46564645/Surgery_exoskeleton/Main_ project/Hardware_information_list/hardware_interface_registry.md

# 硬件接口编码表

> 状态：型号资料接口登记 + 台架接线设计；2026-10-01已在用户报告 GIM 上电后观察到肩侧 CAN 原始报文，尚未完成协议解码或动力电压的独立实测。
>
> 本文件是当前项目的权威接口登记。历史目录中的同名文件仅作为旧副本，不再被项目文档引用。
>
> 硬件范围：严格来自同目录 `hardware_components_reference.md`。
>
> 规则：厂家资料确认与项目设计分配分开记录；第10节列出已选引脚和逐线关系，不代表实物一致性、保护器件或运行参数均已验证。

## 1. 编码与证据规则

| 对象 | 格式 | 示例 | 含义 |
|---|---|---|---|
| 设备 | `类别-序号` | `ACT-01` | 沿用 Hardware List 的设备编号 |
| 物理接口组 | `设备.IF序号` | `ACT-01.IF01` | 连接器、焊盘或固定线缆接口 |
| 接口信号 | `接口组.S序号` | `ACT-01.IF01.S01` | 接口内的一条厂家定义信号 |
| 板上操作件 | `设备.CTL序号` | `ESC-01.CTL01` | 按键、选择开关等非线缆接口 |
| 软件资源槽 | `设备.LR序号` | `MCU-01.LR01` | MCU逻辑需求；已选引脚见第10节 |
| 电源域 | `PD-名称` | `PD-24V-MOTOR` | 具有共同电气性质的电源范围 |
| 逻辑网络 | `NET-名称` | `NET-CAN-ELBOW` | 后续连接映射使用的逻辑网络身份 |

编码只表达稳定身份。厂家端子名称可以记录，但“某信号接到另一设备的哪一针”在第10节接线映射表中单独记录。

### 1.1 状态

| 状态 | 含义 |
|---|---|
| `CONFIRMED` | 对应型号官方资料明确给出，且型号身份已确认 |
| `REFERENCE_ONLY` | 资料来自参考板、芯片或商品页，尚不能证明到货实物完全一致 |
| `PLANNED` | 当前架构需要，但尚未分配物理资源 |
| `DESIGN_SELECTED` | 项目已选择连接关系或物理资源，尚未实物验证；不是厂家证据等级 |
| `TBD` | 缺少型号、版本、实物标识或对应资料，不能继续细化 |
| `INACTIVE` | 设备存在，但当前编码器控制架构不使用 |

### 1.2 证据等级

| 等级 | 证据 | 可确认范围 |
|---|---|---|
| `A` | 对应型号的厂家官方手册、数据手册或官方原理图 | 可确认该型号的接口名称、信号职责和厂家限制 |
| `B` | 对应芯片数据手册或官方参考板资料 | 只能确认芯片或参考板，不能自动等同于当前模块 |
| `C` | 用户提供的商品页、订单截图或商家资料 | 只记录直接可见的信息，必须核对实物 |
| `D` | 项目规划或待验证假设 | 不能作为接线依据 |

## 2. 型号与资料绑定

| 设备 | 已确认型号 | 主资料 | 证据 | 资料边界 |
|---|---|---|---|---|
| `MCU-01` | NUCLEO-F446RE；MB1136 rev C；用户报告 C04；STM32F446RET6 | ST `UM1724 Rev 17`、`MB1136-DEFAULT-C04` 原理图 | A+用户报告 | 正面照片可见 rev C；C04 来自用户文字，背面完整标识尚未拍照核对；板上焊桥/跳线现状仍需实物核对 |
| `ACT-01` | GIM6010-8；GDS68；订单 Y-48、12–48 V 选项 | SteadyWin《GIM6010-8 使用手册 rev2.2》 | A+C | 扩展口是否存在取决于驱动板硬件版本 |
| `ESC-01` | RoboMaster C620 | DJI《C620 无刷电机调速器使用说明 V1.01》 | A | 接口以中文版第 23–25 页为准 |
| `MOTOR-01` | 裸 RoboMaster M3508 | DJI《M3508 直流无刷电机使用说明 v1.0 2025.10》 | A | 不使用 P19 减速器资料 |
| `FORCE-01` | 5 kg 直梁式四线全桥应变称重传感器 | 随购买套装提供的技术参数表、安装图和接线图 | C | 已确认所购规格与资料基准；尺寸、线色和桥阻仍需到货实测 |
| `ADC-01` | HX711-BF / HX711AD 模块；资料原理图版本 | 随购买套装原理图及 Avia《HX711 数据手册》 | B+C | 原理图确认 `RATE`接地、固定10 SPS；实物排针和PCB一致性待核对 |
| `CAN-01/02` | 商品页展示为 Waveshare SN65HVD230 CAN Board 样式 | Waveshare 参考板原理图；TI 数据手册 | B+C | 到货板是否同版尚未确认 |
| `PWR-01` | S-250-24；商品24V/10A，规格书24V/10.4A | 卖家规格书001读取记录、第7页派生图、商品截图 | C | 原PDF待补；供应商/到货批次、输入档位未核对 |
| `IMU-01/02` | WitMotion WT901C-TTL | WitMotion 官方产品页、协议和教程 | A | 当前停用；排针物理顺序仍需实物核对 |

## 3. 电源域

| 编码 | 名称 | 已知范围 | 状态与边界 |
|---|---|---|---|
| `PD-AC-MAINS` | 台架交流输入域 | `PWR-01` 交流输入、保护接地和防触碰边界 | `DESIGN_SELECTED`：规格书针号已记录；实物与输入档位待核对 |
| `PD-24V-MOTOR` | 24 V 动力域 | `PWR-01` 计划向 `ACT-01`、`ESC-01` 供电 | `DESIGN_SELECTED`：两驱动独立支路已选；保护、开关和载流验证待定 |
| `PD-LOGIC-3V3` | 3.3 V 逻辑域 | `CAN-01/02` 和可能的 MCU 扩展逻辑 | `DESIGN_SELECTED`：CN7-16供3.3V，容量待核验 |
| `PD-MCU-5V` | MCU 板 5 V 域 | NUCLEO 的 USB 5 V、E5V 或板载 5 V 路径 | `DESIGN_SELECTED`：CN1 USB供电，CN7-18向逻辑模块分线 |
| `PD-SENSOR-LOW-VOLTAGE` | 传感器低压域 | `ADC-01`、`FORCE-01`；IMU 库存保留 | `DESIGN_SELECTED`：2026-10-16用户改选方案B，HX711由CN7-16的3.3V供电、数字线直连，模块整板3.3V未验证（原为CN7-18 5V加电平转换）；称重桥由HX711激励，IMU停用 |

## 4. 设备接口详细编码

### 4.1 MCU-01：NUCLEO-F446RE

#### 4.1.1 板级接口

| 接口编码 | 官方连接器 | 作用 | 状态 | 官方依据 |
|---|---|---|---|---|
| `MCU-01.IF01` | `CN1` USB Mini-B | ST-LINK 调试、下载、Mass Storage、VCP，并可供电 | `CONFIRMED` | UM1724 第 7.4、7.5.1 节 |
| `MCU-01.IF02` | `CN2` ST-LINK/NUCLEO 跳线 | 选择 ST-LINK 与板载目标 MCU 的连接关系 | `CONFIRMED` | UM1724 第 7.4 节、表 4 |
| `MCU-01.IF03` | `CN4` SWD | 板载 ST-LINK 调试外部目标板 | `CONFIRMED` | UM1724 第 7.4.5 节、表 5 |
| `MCU-01.IF04` | `CN5/CN6/CN8/CN9` | Arduino Uno V3 扩展接口组 | `CONFIRMED` | UM1724 第 7.13 节、表 19 |
| `MCU-01.IF05` | `CN7/CN10` | ST Morpho 扩展接口组 | `CONFIRMED` | UM1724 第 7.14 节、表 29 |
| `MCU-01.IF06` | 板载 VCP 内部路径 | 默认连接 `USART2 PA2/PA3`，受焊桥配置影响 | `CONFIRMED` | UM1724 第 7.10、7.11 节 |
| `MCU-01.IF07` | `B1` USER | 用户输入，连接 `PC13` | `CONFIRMED` | UM1724 第 7.7 节 |
| `MCU-01.IF08` | `B2` RESET | 目标 MCU 复位 | `CONFIRMED` | UM1724 第 7.7 节 |
| `MCU-01.IF09` | `LD2` USER LED | 用户输出，连接 D13 / `PA5` | `CONFIRMED` | UM1724 第 7.6 节 |

`CN4` 用于板载 ST-LINK 调试另一块目标板。UM1724 要求此时移除 CN2 两只跳线；若使用 CN4 第5针 NRST 复位外部目标，还必须断开 SB12，隔离板载 MCU 的复位路径。当前不把 CN4 与板载目标调试路径同时使用。CN2 仅控制 SWDIO/SWCLK 两条路径；板载 PB3 的 SWO 另经 SB15 接到 ST-LINK/CN4 的 SWO 网络，不能由 CN2 跳线状态推断其连接。

2026-10-02用户新正面照片已实际查看（Library `libfile_6ef3ceb5dd8c8191b7ad470143ac49a4`，本机证据 `D:/codex_tasks/2026-10-01/task/s3-axis/cn2-photo-review/`）：CN2两只跳帽外观均可见；CN4六针为裸露排针，未见套接母头或外接线，CN12黑色跳帽不能混作CN4接线。此为照片外观确认，不证明接触导通；不据此假设CN4争用或要求拆线。当时的历史成功与该窗口失败使用相同CLI2.23/HOTPLUG/4000kHz、固定ST-LINK及FW V2J28M18；该窗口目标芯片身份无法读取。后续同日探针升级至V2J48M35后已读到目标身份，13:27 HSI烧录及独立读回通过；不将先前失败描述为当前仍阻塞，历史根因仍未证实。

默认 USART2 VCP 路径按 UM1724 表10要求 SB13/SB14 ON、SB61/SB62/SB63 OFF；这是资料配置条件，当前实物焊桥状态仍未逐项核查。

2026-10-03当前Library实物时钟照片核对：背面`libfile_7d63857c82448191a0d42dbeb6f811d7`与此前背面图字节相同，可见SB16/SB50/SB54装0Ω、SB55空；新正面`libfile_0cab2b9c712c8191917206e69e46874b`中U5左侧C29下四行丝印对应R34/R36/R35/R37，上两行0Ω在位，下两行R35/R37无器件，X3晶体位空，ST-LINK X1在位标8.000。已按Hardware List、MB1136-DEFAULT-C04原理图第3页与UM1724 Rev17第7.9.1节交叉核对，外观符合经PH0输入ST-LINK MCO的装配条件；这不是导通/实际8MHz测量，也未拍到精确C04子版本背贴。没有修改焊桥/接线，不能由照片判断当前24V或USB状态。原图hash与独立证据在`D:/codex_tasks/2026-10-01/task/s2-stream-clock-ab/photo-review/result.json`；该01:19离线准备之后，01:32已在用户24V关闭/USB-only窗口单次刷入同源HSE stream候选并独立读回匹配；01:33 RCC实读HSERDY/HSEBYP/PLLSRC_HSE=1、M8/N336/P4及默认输出0通过。活动源码仍HSI，板上为HSE候选；未测实际8MHz、未启动连续采样。证据在同一工作目录usb-only-20261003T013012Z/result.json。

#### 4.1.2 CN4 信号

| 编码 | 针位 | 信号 | 方向（相对 ST-LINK） |
|---|---:|---|---|
| `MCU-01.IF03.S01` | 1 | `VDD_TARGET` | 采样输入 |
| `MCU-01.IF03.S02` | 2 | `SWCLK` | 输出 |
| `MCU-01.IF03.S03` | 3 | `GND` | 参考地 |
| `MCU-01.IF03.S04` | 4 | `SWDIO` | 双向 |
| `MCU-01.IF03.S05` | 5 | `NRST` | 输出 |
| `MCU-01.IF03.S06` | 6 | `SWO` | 手册表5标为 Reserved（保留）；本项目未用；与板载 PB3 的连接受 SB15 影响，不据此断言电气悬空 |

#### 4.1.3 可用供电入口和电源脚

| 编码 | 位置 | 功能与官方范围 | 状态 |
|---|---|---|---|
| `MCU-01.IF01.S01` | `CN1` | USB 5 V 路径，板及扩展负载受 UM1724 USB 电流限制约束 | `CONFIRMED` |
| `MCU-01.IF04.S01` | `CN6 pin 8` | `VIN`，外部 7–12 V 输入 | `CONFIRMED` |
| `MCU-01.IF05.S01` | `CN7 pin 24` | `VIN` | `CONFIRMED` |
| `MCU-01.IF05.S02` | `CN7 pin 6` | `E5V`，外部 4.75–5.25 V 输入 | `CONFIRMED` |
| `MCU-01.IF04.S02` | `CN6 pin 4` | `+3V3` | `CONFIRMED` |
| `MCU-01.IF04.S03` | `CN6 pin 5` | `+5V` | `CONFIRMED` |
| `MCU-01.IF04.S04` | `CN6 pin 6/7` | `GND` | `CONFIRMED` |

本项目选择CN1 USB供电；不并联外部VIN/E5V/3.3V入口。按UM1724第21–23页核对JP1、JP5、JP6及USB供电总预算，见第10节。

#### 4.1.4 资源槽与设计分配

| 编码 | 用途 | 所需能力 | 状态 | 分配或待定内容 |
|---|---|---|---|---|
| `MCU-01.LR01` | `SHOULDER_SIDE` | 1 路 CAN TX/RX | `DESIGN_SELECTED` | CAN1 PB9/TX、PB8/RX、AF9；500kbps准备值；bank0/FIFO0，RX0/SCE IRQ 5/0；接GDS前核实速率 |
| `MCU-01.LR02` | `ELBOW` | 1 路 CAN TX/RX | `DESIGN_SELECTED` | CAN2 PB13/TX、PB12/RX、AF9；1Mbps；bank14/FIFO1，RX1/SCE IRQ 5/0；实物总线待测 |
| `MCU-01.LR03` | 命令与遥测 | ST-LINK VCP / USART2 | `DESIGN_SELECTED` | PA2/TX、PA3/RX、AF7，115200 8N1无流控；DMA1 Stream5/Channel4 RX循环、Stream6/Channel4 TX普通；S1已生成并构建，实物通信验证另见开发日志 |
| `MCU-01.LR04` | HX711 | 数字输出 `PD_SCK`、数字输入 `DOUT` | `DESIGN_SELECTED` | PC3/SCK输出、PC2/DOUT输入无上下拉；3.3V直连（方案B），10SPS新样本 |
| `MCU-01.LR05` | 未来 `assist_enable_permission` | 安全定义的数字输入 | `PLANNED` | 硬件、GPIO、电平、去抖 |

S1固件中断配置（2026-09-25）：NVIC GROUP4；USART2、DMA1 Stream5/6抢占优先级5、子优先级0；SysTick抢占优先级0。用户按键EXTI15_10的最终抢占优先级为10：官方BSP初始化会写15，因此由自有`BoardRuntime_FinalizeInterrupts()`在`BSP_PB_Init()`之后重新设置并读回检查。检查失败不启动命令接收。此段记录软件配置，不证明实物焊桥、USB链路或电机安全。

S2第一轮软件配置（2026-09-25）：APB1=42MHz，BS1=11、BS2=2、SJW=1，CAN1/2分频6/3；正常模式，允许硬件ACK，无应用发送接口。共享过滤器分界14，仅标准数据帧，不限制11位ID。启用GPIOB及CAN1/CAN2时钟，CAN2保留CAN1时钟依赖；CAN1_RX0、CAN2_RX1和两路SCE均5/0；不自动恢复bus-off。每路64帧队列、ISR最多3帧、主循环每1ms每路最多16帧。USB实测两路started=1、seen=0，仅证明控制器启动与查询，不证明线路收帧或电机在线。

### 4.2 ACT-01：GIM6010-8 + GDS68

`ACT-01` 绑定右臂 `SHOULDER_SIDE`。接口来自 GDS68，不表示全部启用。

| 编码 | 手册序号 | 连接器/形式 | 功能 | 状态 | 依据 |
|---|---:|---|---|---|---|
| `ACT-01.IF01` | 1 | 板端 `XT30PB(2+2)-M`；线端 `XT30(2+2)-F` | 电源与 CAN/复用通信 | `CONFIRMED` | rev2.2 第 2.4.1 节，第 10 页 |
| `ACT-01.IF02` | 2 | USB Type-C | 调试与上位机通信，不给驱动器供电 | `CONFIRMED` | 第 2.4.2、3.1 节 |
| `ACT-01.IF03` | 3 | 20-pin 扩展插槽 | SPI/USART/I2C/PWM/ADC/GPIO | `TBD` | 第 2.4.3 节；硬件 v3.9+ 无此口 |
| `ACT-01.IF04` | 4 | 2.00 mm 焊盘 | SWD 调试/下载 | `CONFIRMED` | 第 2.4.4 节，第 11–12 页 |
| `ACT-01.IF05` | 5 | 2.00 mm 焊盘 | 第二编码器 USART/I2C | `CONFIRMED` | 第 2.4.5 节，第 12 页 |
| `ACT-01.IF06` | 6 | 焊盘 | 电机 10 kΩ NTC | `CONFIRMED` | 第 2.4.6 节，第 12 页 |
| `ACT-01.IF07` | 7a | 2.00 mm 焊盘 | 抱闸或制动/泄放电阻 | `CONFIRMED` | 第 2.4.7 节，第 13 页 |
| `ACT-01.IF08` | 7b | 2.00 mm 焊盘 | 最小/最大限位及 12 V 辅助电源 | `CONFIRMED` | 第 2.4.8 节，第 13–14 页 |
| `ACT-01.IF09` | U/V/W | 三相绕组焊接孔 | GIM6010-8 三相绕组 | `CONFIRMED` | 第 2.2 节，第 9 页 |

#### 4.2.1 电源与 CAN

| 编码 | 信号 | 功能 | 项目状态 |
|---|---|---|---|
| `ACT-01.IF01.S01` | `VBUS` | 直流母线正端 | `PLANNED` |
| `ACT-01.IF01.S02` | `GND` | 直流母线负端/参考地 | `PLANNED` |
| `ACT-01.IF01.S03` | `CANH` | CAN 高线；其他模式可复用 | `PLANNED`：只计划 CAN |
| `ACT-01.IF01.S04` | `CANL` | CAN 低线；其他模式可复用 | `PLANNED`：只计划 CAN |

GDS68 手册明确说明驱动板没有电源反接保护。本表把它记录为接线验证约束，不据此新增未选型的保护器件。

#### 4.2.2 调试与辅助信号

| 编码 | 信号 | 功能 | 状态 |
|---|---|---|---|
| `ACT-01.IF04.S01` | `SWDIO` | SWD 数据 | `CONFIRMED` |
| `ACT-01.IF04.S02` | `GND` | 调试参考地 | `CONFIRMED` |
| `ACT-01.IF04.S03` | `SWDCLK` | SWD 时钟 | `CONFIRMED` |
| `ACT-01.IF04.S04` | `3.3V` | 调试电平参考 | `CONFIRMED` |
| `ACT-01.IF05.S01` | `GND` | 第二编码器参考地 | `CONFIRMED` |
| `ACT-01.IF05.S02` | `3.3V` | 第二编码器供电 | `CONFIRMED` |
| `ACT-01.IF05.S03` | `TX/SCL` | USART TX 或 I2C SCL | `CONFIRMED` |
| `ACT-01.IF05.S04` | `RX/SDA` | USART RX 或 I2C SDA | `CONFIRMED` |
| `ACT-01.IF06.S01` | `MOT_TEMP` | 10 kΩ NTC 信号 | `CONFIRMED` |
| `ACT-01.IF06.S02` | `GND` | 温度参考地；手册称两线无极性 | `CONFIRMED` |
| `ACT-01.IF07.S01` | `EMG` | 抱闸电流输出或制动电阻端 | `CONFIRMED`：未启用 |
| `ACT-01.IF07.S02` | `GND` | 抱闸/制动回路参考端 | `CONFIRMED`：未启用 |
| `ACT-01.IF08.S01` | `GND` | 限位参考地 | `CONFIRMED`：未启用 |
| `ACT-01.IF08.S02` | `12V` | 限位开关辅助供电 | `CONFIRMED`：未启用 |
| `ACT-01.IF08.S03` | `LW1` | 最小位置限位输入 | `CONFIRMED`：未启用 |
| `ACT-01.IF08.S04` | `LW2` | 最大位置限位输入 | `CONFIRMED`：未启用 |

限位口允许两线开关或三线 NPN 开关，但项目未选定开关。20-pin 扩展口的板端为 `X0812FVS-20CS-9TV01`，扩展板端为 `X0812WVS-20AS-9TV01`；ACT-01实读硬件3.11.1，手册标注v3.9+无此20-pin口；该未启用扩展口不建立项目连接，实物PCB外观未由本次界面读取验证。

#### 4.2.2a 肩侧目视姿态与编码器配对（2026-10-06）

- 用户确认采集期间未移动，并接受目视判断的当前角度，要求跳过进一步测角。未提供仪器测量值/误差范围，也未明确数值0°；记录为用户目视参考，不标为精确角度标定通过。
- 23:39:44 CST原生USB实读位置为2.8982579708099365转子rev，首末IDLE；原始来源为`D:/codex_tasks/2026-10-01/task/s3-shoulder-supervised/usb/captures/20261006T153943.847110Z/capture.json`。本仓证据引用：`firmware/Exoskeleton_F446/experiments/can_blackbox/captures/s3-precheck-20261006T153820368000Z/usb-read-reference.json`（本机忽略）。
- 未据此写入关节零位、方向、总传动比例或运动边界。后续若出现角度/重力补偿偏差，回查目视姿态基准、采集配对及映射参数；原始读数不是关节角度。用户范围调整和阶段状态见唯一开发日志2026-10-06条目。

2026-10-09 S4 连接补充（用户口述，未独立拆检）：GDS68 输出端与肩轴直接相连，用户确认没有额外皮带或齿轮传动。这只排除了外部二次传动的候选；反馈位置到关节角的总换算比及关节正向仍须与独立角度和同期新鲜读数核对。舒适内侧位置的独立角度、同期转子读数及试验小区间两端余量目前未提供，不将 8:1 或方向写为已验收，也不据此启用 S4 输出。

#### 4.2.3 当前实物版本、通信配置与USB绑定（2026-10-02只读）

以下是肩侧静态供电、MotorWizard已连接后的实际界面和Windows在线设备读数；不是手册示例，未修改设备配置。唯一进度与操作经过见development_schedule.md当日日志。

| 项目 | 实际读取结果 | 证据/边界 |
|---|---|---|
| 硬件/固件版本 | 3.11.1 / 0.6.5 | 电机参数页头；不再使用手册3.8/0.5.13示例代表实物 |
| 通信接口/波特率 | CAN / 500000 bit/s | 通信参数页；与MCU CAN1名义500kbps一致，不证明物理链路无错 |
| 节点/协议 | ID 1 / SIMPLE | 实际配置支持既有0x029按节点1、命令0x009核对；载荷含义和真实反馈对应仍待确认 |
| 减速比/极对数 | 8.00 / 14 | 客户端存量配置，未独立标定；不改变S2原生转子单位或确认关节零位 |
| 显示运行状态 | 空闲、0 RPM、母线23.2 V | 连接主界面快照，不代替外部仪表测量或全部启动行为验收 |
| USB Interface 2 | USB\VID_1209&PID_0D32&MI_02 | 在线Code0；oem249.inf / libusb0 / libusb-win32 1.4.0.0 |
| USB Interface 0 | COM5 / usbser.inf / usbser | 仍为原Microsoft串口驱动，未改绑 |
| 120Ω/启动参数 | 2026-10-03 01:12 UTC只读：can.config.enable_r120=true（ep72/bool）、r120_gpio_num=5（ep71/uint16）；启动参数未验证 | HW3.11.1/FW0.6.5/node1/IDLE及板SN197332430435634匹配；仅软件配置，不证明电阻导通或CAN根因，不把逻辑GPIO编号5映射为未核实的物理脚位 |

实物版本3.11.1不属于手册“硬件≤3.7时USB/CAN互斥”条件，当前CAN配置下USB实际可连接；未发Disable_Can、保存或重启命令。协议字段仍须核对0.6.5适用资料，不把旧手册全部行为自动套用。现有HAL 0x10是STM32帧格式错误，USB驱动修复不证明CAN错误已消除。S2肩侧解析、必要真实反馈/离线恢复及双路验收尚未完成；本记录不作为运动或人体安全验收。

2026-10-02 14:56–14:58 UTC补充只读证据：同一静止时段，厂家参数浏览器显示`axis0.encoder.pos_estimate=2.9320929050445557`、`encoder.is_ready=1`、`encoder.error=0`；约30秒后的CAN查询仍为`0x029/DLC8/0000000000000000`，心跳`state=1/error=0/fault=0`，输出许可为0。并非同步采样，未据此确认动态角度/速度或关节映射。原始帧已零，不通过改STM32换算掩盖；USB与CAN来源差异待厂家FW0.6.5实现核实。rev2.2第35页注明`load_encoder_axis`仅BETA必要、量产无效；不能据上游ODrive版本建议修改该项或使能初始化。第45–46页RxSdo只读方案须先取得匹配0.6.5的端点表；公开0.5.13/0.5.14表不能代用，候选0.6.5地址实际返回HTML。证据索引：`D:/codex_tasks/2026-10-01/task/s2-final-acceptance/usb-can-source-diagnosis.json`。本轮未改接线/参数/驱动固件，S2仍未完成。

2026-10-02 15:33 UTC实机Native USB追加确认：HW3.11.1/FW0.6.5/node1/axis0 IDLE，36965字节原始endpoint0 schema SHA256为`cfd83580745d91c18d87c6832daa34677685e32e9d051e7f2b4bb562a90c9bc1`。只读float `axis0.encoder.pos_estimate`端点372、`vel_estimate`端点378；当次USB分别2.9287331104278564rev和0.005722047761082649rev/s，ready=true/error0。此前公开地址返回HTML的阻碍已由设备导出解决，未套用旧版端点。固件新增只读opcode0、固定节点/端点的250ms有界诊断，匹配025回应与周期029独立标记；16:09已随新HSI刷入并独立读回，16:11默认禁用/SDO idle通过，尚未发送CAN属性读取；USB CRC16=63447不能用于CAN属性帧。端点绑定与最小后续边界见[限定SDO诊断](../../firmware/Exoskeleton_F446/docs/s2_encoder_sdo_diagnostic.md)。S2真实CAN语义、变化和离线恢复仍待验收；参数、接线及驱动固件未改。

16:21 UTC限定CAN实测：372/378各一次read得到ID025/DLC8/正确端点，位置`00740100FC993740`=2.8687734603881836rev、速度`007A010000007ABB`=−0.003814697265625rev/s；紧邻USB位置2.868832588195801rev，相隔约96.541ms。周期029仍全零、心跳IDLE/error0/fault0；两路本窗口CAN错误/丢帧/溢出/bus-off均0，无新增。属性估计与周期009分别标记，不确认厂家内部controller来源，不以非同步微小速度值确认运动方向。读取机会已用，可信连续肩反馈及实物超时/恢复仍待验收；无写参数/使能/校准或运动。证据为s2-sdo-read/can-usb-20261002T162124633Z/analysis.json。

本机证据目录：D:/codex_tasks/2026-10-01/task/gds-tool-preparation/gds-interface2-correct-binding/；actual-binding.json、pnputil-install.log、motorwizard-after-binding.png、motor-parameters.png。本次只安装授权的Interface2驱动包及其对应证书；Logitech原驱动未变，未启动、校准或同步保存设备参数。

### 4.3 ESC-01：RoboMaster C620

`ESC-01` 与 `MOTOR-01` 共同绑定右臂 `ELBOW`。

2026-10-08 安装位置补充（用户口述，未通过照片独立核查）：C620 固定在支架上，不随肩侧关节转动。估算肩轴随动负载时不计入 C620 本体质量；随动线束仍须按实际布置另行判断。

| 编码 | 官方接口 | 功能 | 状态 | 依据 |
|---|---|---|---|---|
| `ESC-01.IF01` | 7-Pin 电机数据端口 | 与 M3508 数据交互 | `CONFIRMED` | C620 中文第 23、25 页 |
| `ESC-01.IF02` | 三相动力线接头 | 向 M3508 输出三相动力 | `CONFIRMED` | 第 23、25 页 |
| `ESC-01.IF03` | 兼容 XT30 的电源线 | 24 V 输入 | `CONFIRMED` | 第 24 页 |
| `ESC-01.IF04` | CAN 信号端口 | 1 Mbps CAN 控制与反馈 | `CONFIRMED` | 第 24–25 页 |
| `ESC-01.IF05` | PWM 信号端口 | PWM 控制或配置/升级 | `CONFIRMED` | 第 24–25、27 页 |
| `ESC-01.CTL01` | 终端电阻开关 | 接入/断开板载 120 Ω | `CONFIRMED` | 第 24 页 |
| `ESC-01.CTL02` | SET 按键 | 设置 ID、快速编号、电机校准 | `CONFIRMED` | 第 24、30–32 页 |

| 编码 | 标记/线色 | 方向（相对 C620） | 项目状态 |
|---|---|---|---|
| `ESC-01.IF03.S01` | 电源正，XT30 极性依连接器 | 输入 | `PLANNED`：核对实物 |
| `ESC-01.IF03.S02` | 电源负，XT30 极性依连接器 | 输入 | `PLANNED` |
| `ESC-01.IF04.S01` | A，黑色，`CAN_L` | 双向总线 | `PLANNED` |
| `ESC-01.IF04.S02` | B，红色，`CAN_H` | 双向总线 | `PLANNED` |
| `ESC-01.IF05.S01` | A，黑色，`GND` | 参考地 | `CONFIRMED`：不作运行控制 |
| `ESC-01.IF05.S02` | B，灰色，`TX` | 输出 | `CONFIRMED`：不作运行控制 |
| `ESC-01.IF05.S03` | C，白色，`PWM/RX` | 输入 | `CONFIRMED`：不作运行控制 |

C620 手册禁止同时接入 CAN 与 PWM，切换方式前必须断电。本项目固定选择 CAN 运行路径。7-Pin 内部针位未在当前官方手册展开，因此不猜测。

### 4.4 MOTOR-01：裸 M3508

| 编码 | 官方接口 | 功能 | 状态 | 依据 |
|---|---|---|---|---|
| `MOTOR-01.IF01` | 7-Pin 数据端口 | 用随附线连接 C620 | `CONFIRMED` | M3508 v1.0 第 2、6 页 |
| `MOTOR-01.IF02` | 三相输入接头 | 连接 C620，相同颜色对应且不可反插 | `CONFIRMED` | M3508 v1.0 第 2、6 页 |

不添加 P19 接口。手册没有公开 7-Pin 内部针位，也未在文字中定义三相 U/V/W，因此只把原厂线束视为完整接口。M3508 的动力必须来自 C620 三相输出，不能直接接 24 V 直流母线。

2026-10-11 用户口述：肘部电机输出轴与关节同轴直连，本轮软件以 1:1 为局部候选。随后在 24 V 关闭、机构承托下，用户轻轻手动转动前臂，报告电机输出端与肘关节同步、同方向转动，未见明显空转或打滑；这只支持本次低负载手动联动，不是传动比精度、带载无滑差、屈伸编码器正方向、力矩或可用活动角域的实测证明。

2026-10-11 R2 修复版动力微动方向观察：在独立承托的同一台架姿态下，固件通过 C620 发送 `elbowpulse <token> 2000 150`，主机约 100 ms 取消；操作者从侧面确认重复窗口的两次微动均使前臂**更弯曲**。本结论只将该装配姿态下的正向电流指令与屈肘微动关联，不推定重力支撑方向或全活动范围。重复第 2 次结束时固件锁存 `HEALTH/SAFETY_TRANSPORT` 故障，第 3 次未发送；用户确认断电承托、无异常。原始串口与故障 RAM 见固件 `build/bench-logs/s5-r2-repeat-20261011/`。

### 4.5 FORCE-01：5 kg 直梁式应变称重传感器

以下信息来自随购买套装提供的5 kg技术参数表、安装图和接线图，证据等级为商品配套资料。到货后仍需核对实物。

| 编码 | 商品资料线色 | 商品资料定义 | 方向 | 状态 |
|---|---|---|---|---|
| `FORCE-01.IF01.S01` | 红 | `E+` 激励正 | 输入 | `REFERENCE_ONLY` |
| `FORCE-01.IF01.S02` | 黑 | `E-` 激励负 | 输入 | `REFERENCE_ONLY` |
| `FORCE-01.IF01.S03` | 绿 | `A+` 信号正 | 输出 | `REFERENCE_ONLY` |
| `FORCE-01.IF01.S04` | 白 | `A-` 信号负 | 输出 | `REFERENCE_ONLY` |

资料给出额定载荷5 kg、灵敏度1.0 ± 0.1 mV/V、推荐激励3–12 V以及输入/输出电阻1000 ± 50 Ω。安装采用一端固定、另一端悬空的悬臂方式；连接ADC前仍需测量桥路并通过已知方向加载确定正负方向。

### 4.6 ADC-01：HX711 模块

随购买套装资料给出了HX711-BF模块原理图和接线图。原理图明确把`RATE`（15脚）接至`GND`，因此本项目按固定10 SPS的低速采集模块登记；具体排针顺序仍需到货后按板上丝印确认。

| 编码 | 逻辑接口组 | 芯片功能 | 模块状态 |
|---|---|---|---|
| `ADC-01.IF01` | 通道 A 称重桥输入 | `E+`、`E-`、`A+`、`A-` | `REFERENCE_ONLY`：按套装接线图，待实物丝印确认 |
| `ADC-01.IF02` | 通道 B 输入 | `B+`、`B-` | `INACTIVE`：当前不使用 |
| `ADC-01.IF03` | MCU 数字接口 | `DT/DOUT`、`SCK/PD_SCK`、`GND` | `REFERENCE_ONLY`：待实物排针确认 |
| `ADC-01.IF04` | 模块供电 | `VCC`、`GND` | `DESIGN_SELECTED`：CN7-16 +3.3V（2026-10-16方案B）；配套原理图模拟稳压目标约4.3V，3.3V下预计饱和、E+约3.0–3.2V，需上电实测 |
| `ADC-01.CFG01` | HX711 `RATE`硬件配置 | 15脚接`GND`，固定10 SPS | `REFERENCE_ONLY`：套装原理图已确认，实物PCB待核对 |

ADC-01只发布低速辅助力监测值，用于显示、记录、标定观察和后续研究。它不作为快速助力触发、关节主控制反馈、安全触发或高带宽力闭环输入。软件不得把重复读取旧样本描述为高于10 SPS的新测量。

| 参考编码 | HX711 针位 | 信号 | 官方功能 |
|---|---:|---|---|
| `ADC-01.IF01.S01` | 8 | `INA+` | 通道 A 正输入 |
| `ADC-01.IF01.S02` | 7 | `INA-` | 通道 A 负输入 |
| `ADC-01.IF02.S01` | 10 | `INB+` | 通道 B 正输入 |
| `ADC-01.IF02.S02` | 9 | `INB-` | 通道 B 负输入 |
| `ADC-01.IF03.S01` | 12 | `DOUT` | 数据输出；低电平表示就绪 |
| `ADC-01.IF03.S02` | 11 | `PD_SCK` | 时钟兼断电控制；高电平超过 60 µs 断电 |

依据为 Avia HX711 数据手册第 2、4–6、10 页。数据手册要求 DOUT 对应的 MCU 输入不接内部上拉/下拉；本地开源 STM32 示例 README 建议上拉，与芯片手册冲突，后续必须以芯片手册和实际模块电路为先。

### 4.7 CAN-01 / CAN-02：SN65HVD230 CAN Board 样式模块

两块模块结构相同。排针顺序来自 Waveshare 参考板原理图，实物未核对，全部为 `REFERENCE_ONLY`。

下表使用公共后缀压缩重复内容。例如 `.IF01.S01` 分别展开为 `CAN-01.IF01.S01` 和 `CAN-02.IF01.S01`，两者仍是独立且唯一的信号编码。

| 信号后缀 | 参考板针位 | 信号 | 方向（相对模块） |
|---|---:|---|---|
| `.IF01.S01` | P1-1 | `CAN_TX`，接收发器 D | 输入 |
| `.IF01.S02` | P1-2 | `CAN_RX`，来自收发器 R | 输出 |
| `.IF01.S03` | P1-3 | `GND` | 参考地 |
| `.IF01.S04` | P1-4 | `3.3V` | 电源输入 |
| `.IF02.S01` | can1-1 | `CANL` | 双向总线 |
| `.IF02.S02` | can1-2 | `CANH` | 双向总线 |

Waveshare 原理图确认：`Rs` 经 10 kΩ 接地，CANH/CANL 固定跨接 120 Ω；未显示终端使能开关、隔离器或 TVS。TI 数据手册第 5 页确认 SN65HVD230 芯片信号和 3.3 V 供电。接线前必须逐块核对芯片顶标、P1 丝印方向、CANH/CANL 丝印、3.3 V/GND 极性及断电端间电阻。

### 4.8 PWR-01：S-250-24

卖家规格书001第7页已给针号。原PDF临时文件在归档时失效，保留[第7页派生图](all_hardware_relevant_documents/S-250-24_power_supply/specification_page7_render.png)与[读取记录](all_hardware_relevant_documents/S-250-24_power_supply/specification_reading_record.md)，证据等级C，实物仍待核对。

| 接口/信号编码 | 针号或名称 | 职责 | 状态 |
|---|---|---|---|
| `PWR-01.IF01.S01` | 9 / AC/L | 交流火线 | `REFERENCE_ONLY` |
| `PWR-01.IF01.S02` | 8 / AC/N | 交流零线 | `REFERENCE_ONLY` |
| `PWR-01.IF01.S03` | 7 / GND保护接地 | PE；不是DC负极 | `REFERENCE_ONLY` |
| `PWR-01.IF02.S01` | 1/2/3 / +V | 同一路+24V输出 | `REFERENCE_ONLY` |
| `PWR-01.IF02.S02` | 4/5/6 / −V | 同一路动力0V | `REFERENCE_ONLY` |
| `PWR-01.IF03` | ADJ | 输出调节；规格書22.7–25.2V | `REFERENCE_ONLY` |

观察方向：风扇面朝上、端子朝向观察者，从左向右1–9，调压器不计入针号。三组正负端子共享电源总额定10.4A，不乘三；原商品标10A的差异保留。L接火线，N接零线，不采纳卖家“无需区分”说法。输入选择档位、接线端子扭矩和回生吸收能力未确认。

保护资料边界（既有S-250-24规格书读取记录、原PDF未归档）：过流12.5–14.5A恒功率、过功率300–350W及短路消除后自动恢复；ADJ为调压，未记录可调恒流限流能力。供应商/实物一致性和保护实测未验证，固定保护不代替支路保险；现有用户选择为暂不安装动力保险，动力线径尚未核实。

### 4.9 IMU-01 / IMU-02：WT901C-TTL

IMU 当前不进入控制架构，仅登记库存能力。

下表公共后缀分别展开到 `IMU-01` 与 `IMU-02`，例如 `.IF01.S02` 对应两个设备各自独立的 TX 信号。

| 信号后缀 | 官方信号 | 方向（相对 IMU） | 状态 |
|---|---|---|---|
| `.IF01.S01` | `VCC` | 电源输入 | `INACTIVE`：电压按实物版本复核 |
| `.IF01.S02` | `TX` | 串口输出 | `INACTIVE` |
| `.IF01.S03` | `RX` | 串口输入 | `INACTIVE` |
| `.IF01.S04` | `GND` | 参考地 | `INACTIVE` |

WitMotion 官方教程确认串口交叉连接，即传感器 TX 对主控 RX、传感器 RX 对主控 TX。当前没有本批产品排针实物证据，不登记物理针序；未来启用时须先读取当前波特率和输出配置。

## 5. 逻辑网络

| 编码 | 功能 | 端点角色 | 状态 | 尚未决定 |
|---|---|---|---|---|
| `NET-PWR-24V-MOTOR` | 24 V 动力母线 | `PWR-01.IF02`、`ACT-01.IF01`、`ESC-01.IF03` | `PLANNED` | 分支、保护、线径、连接器、同时输出能力 |
| `NET-CAN-SHOULDER-SIDE` | SHOULDER_SIDE CAN | `MCU-01.LR01`、`CAN-01`、`ACT-01.IF01` | `DESIGN_SELECTED` | MCU引脚见第10节；实物终端、线束、CAN配置待验证 |
| `NET-CAN-ELBOW` | ELBOW CAN | `MCU-01.LR02`、`CAN-02`、`ESC-01.IF04` | `DESIGN_SELECTED` | MCU引脚见第10节；实物终端、线束、C620 ID待验证 |
| `NET-M3508-DATA` | M3508 数据链 | `ESC-01.IF01`、`MOTOR-01.IF01`、原厂 7-Pin 线 | `CONFIRMED` | 不拆未公开针位 |
| `NET-M3508-PHASE` | M3508 三相链 | `ESC-01.IF02`、`MOTOR-01.IF02` | `CONFIRMED` | 实物线色和接头检查 |
| `NET-FORCE-BRIDGE` | 力传感器桥路 | `FORCE-01.IF01`、`ADC-01.IF01/04` | `PLANNED` | 实物端子、激励、桥阻和方向标定 |
| `NET-HX711-DIGITAL` | HX711 10 SPS低速数字采集 | `ADC-01.IF03`、`MCU-01.LR04` | `DESIGN_SELECTED` | GPIO见第10节；方案B 3.3V直连无转换板；实物排针、读取超时待落实 |
| `NET-DEBUG-VCP` | 调试与遥测 | PC、`MCU-01.IF01/06`、`MCU-01.LR03` | `PLANNED` | USART2 是否占用、波特率、格式 |

## 6. 无法由型号资料确认的项目

1. `MCU-01` 用户报告 C04，已选用 C04 原理图作为资料依据；背面完整版本贴纸和当前焊桥/跳线状态仍未照片核对。
2. `ACT-01` 已实读GDS68硬件3.11.1/固件0.6.5及CAN 500kbps/ID1/SIMPLE（第4.2.3节）；实际PCB接口外观、120Ω软件开关和肩侧反馈/错误根因仍未确认，不认定20-pin扩展口存在。
3. `FORCE-01`已确定购买5 kg规格，但缺少到货实物、厂家型号和铭牌，线色、桥阻及尺寸仍需实测。
4. `ADC-01`已有套装原理图并确认固定10 SPS，但缺少到货PCB正反面照片，不能把资料排针顺序直接视为实物事实。
5. `CAN-01/02` 未核对到货板，Waveshare 参考板针序不能视为实物事实。
6. `PWR-01` 已读取S-250-24规格书并保存第7页派生图；原PDF待补，实物铭牌、输入档位和端子一致性未核对。
7. `IMU-01/02` 当前停用且缺少本批排针照片，不登记物理针序。

## 7. 接线设计前的实物核对

| 对象 | 必须获取或测量 | 解锁工作 |
|---|---|---|
| `MCU-01` | C04 背标照片、当前焊桥/跳线 | 板级差异与实物接线核对 |
| `ACT-01` | GDS68 板版本、端子朝向、CAN 模式与配置 | SHOULDER_SIDE 线束 |
| `ESC-01` | XT30 极性、终端开关、ID、CAN/PWM 未同时接入 | ELBOW 线束 |
| `MOTOR-01` | 原厂 7-Pin 与三相线完好、同色对应 | C620-M3508 配套确认 |
| `FORCE-01` | 铭牌/订单型号、5 kg规格、尺寸、线色、桥阻和已知方向加载 | 接HX711并完成方向标定 |
| `ADC-01` | PCB正反面、丝印、芯片顶标，并核对`RATE`确实接地 | 两侧针位编码和10 SPS采样验证 |
| `CAN-01/02` | 正反面、芯片顶标、丝印、断电总线电阻 | CAN 接线与终端 |
| `PWR-01` | 铭牌、输入选择、端子排和丝印 | 交流与 24 V 支路 |
| `IMU-01/02` | 未来启用时核对排针、供电版本和配置 | IMU 资源分配 |

## 8. 尚未完成的设计与验证

- CAN1/CAN2及HX711引脚已分配；CAN ID、实际波特率配置、控制周期、控制限值、DMA/IRQ/滤波器仍由固件设计与设备读取落实。C620要求1Mbps不是另一条GDS68总线已配置的证明。
- 24V两支路拓扑已选；保险、急停/接触器、浪涌、回生处理、线束载流具体型号未选定；HX711按方案B 3.3V直连，不再需要电平转换板。图中占位不代表已安装器件。
- 不把旧款商品参数、参考板针序、规格书数值或开源程序提升为实物已验证结论。IMU保持停用。

## 9. 资料索引

AI 读取手册时，有对应型号和版本且正文可读的 Word 就优先读 Word；完整格式规则和图示核对要求见[图纸文字说明第0.1节](motor_can_diagrams_text.md#01-手册读取入口)。Word 页码可能因重排变化，以下章节/页码依据原 PDF。

| 编号 | 本地资料 | 用途 |
|---|---|---|
| `SRC-PROJECT-DIAGRAMS` | [电机与 CAN 模块图纸的详细文字描述](motor_can_diagrams_text.md) | 项目整理的逐线说明和 Word/PDF 读取入口；不替代厂家原件或本表的当前接线状态 |
| `SRC-MCU-01` | [Word](all_hardware_relevant_documents/um1724-stm32-nucleo64-boards-mb1136-stmicroelectronics.docx)；[原 PDF](all_hardware_relevant_documents/um1724-stm32-nucleo64-boards-mb1136-stmicroelectronics.pdf) | NUCLEO 接口、供电、VCP、按键和 LED |
| `SRC-MCU-C04` | [ST 官方 MB1136-DEFAULT-C04 原理图](https://www.st.com/resource/en/schematic_pack/mb1136-default-c04_schematic.pdf)；[项目所用接口的结构化摘录](nucleo_f446re_mb1136_c04_ai.json) | 5 页 C04 参考电路；JSON 为不完整摘录，不能代替整板网表或实物焊桥检查 |
| `SRC-ACT-01` | [Word](all_hardware_relevant_documents/ABUIABA9GAAgzpi6wQYoh9D9CQ.docx)；[原 PDF](all_hardware_relevant_documents/ABUIABA9GAAgzpi6wQYoh9D9CQ.pdf) | GIM6010-8/GDS68 rev2.2 第 2.2–2.4 节 |
| `SRC-ESC-01` | [原 PDF](all_hardware_relevant_documents/RoboMaster_C620_Brushless_DC_Motor_Speed_Controller_V1.01.pdf)（当前无对应 Word） | C620 接口、线色、终端和限制 |
| `SRC-MOTOR-01` | [Word](all_hardware_relevant_documents/RoboMaster_M3508_Brushless_DC_Motor_User_Guide_v1.0_2025.10.docx)；[原 PDF](all_hardware_relevant_documents/RoboMaster_M3508_Brushless_DC_Motor_User_Guide_v1.0_2025.10.pdf) | 裸 M3508 接口 |
| `SRC-ADC-01` | `all_hardware_relevant_documents/电子秤HX71..料包/电子秤HX711AD模块资料包/hx711(海芯).pdf` | HX711 芯片信号与时序 |
| `SRC-FORCE-01` | `all_hardware_relevant_documents/电子秤HX71..料包/电子秤HX711AD模块资料包/称重传感器的原理及使用.pdf`（旧技术参数表目录不在当前树中） | 5 kg传感器参数、尺寸、安装与线色 |
| `SRC-ADC-REF` | `all_hardware_relevant_documents/电子秤HX71..料包/电子秤HX711AD模块资料包/ADC模块原理图.pdf` | 确认资料版本固定10 SPS；不直接证明到货排针 |
| `SRC-CAN-BOARD` | [原理图 PDF](all_hardware_relevant_documents/SN65HVD230_CAN_module/Waveshare_SN65HVD230_CAN_Board_Schematic.pdf)（当前无原理图 Word） | 参考板排针、120 Ω 与 10 kΩ |
| `SRC-CAN-IC` | [TI Rev O Word](all_hardware_relevant_documents/SN65HVD230_CAN_module/TI_SN65HVD23x_3.3V_CAN_Transceivers_RevO.docx)；[原 PDF](all_hardware_relevant_documents/SN65HVD230_CAN_module/TI_SN65HVD23x_3.3V_CAN_Transceivers_RevO.pdf) | 芯片引脚和职责；旧 Waveshare Datasheets Word 是 Rev G 芯片资料，不是模块原理图 |
| `SRC-PWR-01` | [来源及派生资料](all_hardware_relevant_documents/S-250-24_power_supply/SOURCE.md) | 商品、规格书读取记录与第7页派生图；原PDF待补 |
| `SRC-IMU-01` | WitMotion 官方 WT901C 产品页及 WIT Standard Protocol | WT901C-TTL 串口角色；当前停用 |

## 10. 台架接线设计分配（2026-09-24）

以下均为`DESIGN_SELECTED`，与厂家资料级`CONFIRMED`分开。CN7-35指连接器第35针，不是MCU芯片封装第35脚。针号见UM1724 Rev17第59页表29；CAN复用AF9见STM32F446RE DS10693复用功能表。板上针1标记/单双排方向按实物核对，不能按照片左右猜针号。

### 10.1 整体连接图

```mermaid
flowchart TD
  PC[电脑USB] --> MCU[NUCLEO CN1 Mini-B]
  MCU -->|CN7-16 3.3V| L33[3.3V分线]
  MCU -->|CN7-18 5V| L5[5V分线]
  L33 --> CAN1[CAN-01]
  L33 --> CAN2[CAN-02]
  L33 --> HX[HX711 3.3V供电 方案B]
  MCU -->|PB9 TX / PB8 RX| CAN1
  MCU -->|PB13 TX / PB12 RX| CAN2
  MCU <-->|PC3 SCK输出 / PC2 DOUT输入 直连| HX
  HX --> FORCE[称重桥 E+ E- A+ A-]
  CAN1 <-->|CANH/CANL 独立总线| GDS[GDS68 / 肩部]
  CAN2 <-->|CANH/CANL 独立总线| C620[C620 / 肘部]
  AC[交流 L N PE] --> PSU[S-250-24]
  PSU -->|24V及0V| DIST[动力保护与分配 器件待定]
  DIST --> GDS
  DIST --> C620
  C620 -->|原厂三相线及7-pin| MOTOR[裸M3508]
```

图省略各逻辑GND线，实际必须按下表接地。两条CAN不合并H/L；非隔离系统通过专用参考连接共地，电机回流直接到动力0V分配，不经过开发板、面包板或杜邦线。PE与DC0V分开标识，不能任意短接。

### 10.2 逐线连接表

2026-10-05现场补充（用户报告）：肩侧CAN-01到GDS68的H/L线长约15cm；用户确认CAN-01元件面与官方参考一致、无发现问题。本轮未收到新图片或阻值实测，不把该报告扩大为已独立核验R1/R2、终端上电导通或信号波形。按用户确认继续使用既有接线映射，不再将补拍同一模块作为整理接线说明的前置。下述历史线色为定位辅助，接线以信号丝印及NUCLEO连接器针号为准。

同日后续用户对完整逐线说明回复“没问题”，并对断电检查CAN-01 H/L端子及四针插头有无明显松动回复“没有”。记录为人工核对未发现接错或明显松动，不等同于已测接触电阻随弯折变化、终端导通或动态波形；不再重复要求同一接线和松动检查。

2026-09-25现场记录（照片辨识+用户确认，不是电压/通断仪器测量）：肩侧TX白线→PB9/CN10-5，RX红线→PB8/CN10-3；肘部TX紫线→PB13/CN10-30，RX橙线→PB12/CN10-16。CN7-16分线至肩侧3.3V紫线、肘部3.3V蓝线，CN7-20分配两模块GND。两根紫线用途不同，所有线色以端点信号为准。用户确认面包板分段与针位；USB已接，当前安排24V断开、H/L不接驱动器。电压与远端终端仍待测。

2026-09-30现场线色补记：以下以模块端近照及上段用户确认记录为依据。上段“H/L 不接驱动器”是2026-09-25当时的状态；照片可见肩侧模块 H/L 端子已插入导线，GIM 四芯插头已插入。用户此前口头确认黑线到 GDS68 CANL、白线到 CANH；后续电机端特写按丝印和出线位置判断为细黑在 CANL 侧、白线在 CANH 侧，与模块端一致。此为照片判断，尚未做两根小触点的逐线通断核对，不能写成实物电气验收或已收到 CAN 帧。

| 对象/模块端丝印 | 当前线色 | 已知去向及证据边界 |
|---|---|---|
| 肩侧 `CAN-01 TX` | 白 | 本次照片可见模块端；此前用户确认至 PB9/CN10-5 |
| 肩侧 `CAN-01 RX` | 红 | 本次照片可见模块端；此前用户确认至 PB8/CN10-3；不是动力 +24 V |
| 肩侧 `CAN-01 GND` | 灰 | 本次照片可见模块端；逻辑地分配的远端未在本次照片中追线 |
| 肩侧 `CAN-01 3.3V` | 浅紫 | 本次照片可见模块端；此前用户确认来自 CN7-16 分线；不是肘部 TX 的紫线 |
| 肩侧 `CAN-01 CANL` 蓝色端子左孔 | 黑 | 照片可见模块端；GIM 端细黑线也位于 CANL 丝印对应侧，照片判断一致，未逐针复测 |
| 肩侧 `CAN-01 CANH` 蓝色端子右孔 | 白 | 照片可见模块端；不是上方 TX 白线；GIM 端白线也位于 CANH 丝印对应侧，照片判断一致，未逐针复测 |
| 肘部 `CAN-02 TX` | 紫 | 2026-09-25用户确认至 PB13/CN10-30；本次照片未拍到 CAN-02 |
| 肘部 `CAN-02 RX` | 橙 | 2026-09-25用户确认至 PB12/CN10-16；本次照片未拍到 CAN-02 |
| 肘部 `CAN-02 3.3V` | 蓝 | 2026-09-25用户确认来自 CN7-16 分线；本次照片未拍到 CAN-02 |
| GDS68 配套线粗红 | 红 | 用户报告粗红线与其识别为 VBUS 的触点约 0 Ω；测量部位和插头朝向未由照片复核，不作为完整线束验收 |

用户按前述断电测量步骤报告 CAN-01 H/L 间约 120 Ω；该值可能仅来自模块端终端电阻，不能证明 GDS68 端终端已使能或真实通信。肘部 `CAN-02 GND` 的现场线色、GDS68 除粗红 VBUS 外三根线的触点对应仍缺少逐线测量。线色只用于定位这次台架上的导线，不替代丝印、端点核对或断电测量。

2026-09-30 后续五张现场照片复核：

| 部位 | 照片可见 | 不能由照片证明/待核对 |
|---|---|---|
| GIM6010-8 插座及四芯插头 | 板面丝印 `VBUS`、`GND`、`CANH`、`CANL`；插头已插入，出线为粗红、粗黑、细黑、白。按丝印与出线位置判断：粗红 VBUS、粗黑 GND、细黑 CANL、白线 CANH | 粗红到 VBUS 另有此前用户报告约 0 Ω；其余三根线尚未逐线通断测量，照片判断不等于触点电气验收。此前曾把细黑/白的上下位置误看成疑似交叉，复核本组特写后已更正 |
| GIM 动力线端 | 粗红、粗黑分别进入两只独立的 WAGO 221-412；各自另一孔在照片中未见接入电源线 | 未见可调电源鳄鱼夹或其他电源输出接入；未验证端子夹持、电源电压/极性或上电状态 |
| 肩侧 CAN-01 | 排针按实物丝印从 `TX/RX/GND/3.3V` 依次插白/红/灰/浅紫；蓝色端子 `CANL` 插黑、`CANH` 插白 | 排针远端的 NUCLEO 针号、GIM 插头两个 CAN 小触点未在本组照片中逐线追踪；黄色两针不视为终端开关 |
| NUCLEO 与分线 | 开发板接有多根跳线，分线处可见多色插接线 | 线束在照片中交叉、遮挡，不能仅凭颜色核实全部 CN 针号、3.3 V、逻辑 GND 与 CAN-02 的实际端点；C620/M3508 动力与 CAN 接线不在本组照片中 |

用户在确认万用表表笔自检正常后，曾报告断电测量 GIM 粗黑动力负极所在端子与 CAN-01 `GND` 为 `0L/OL`（未导通）；此前将其短暂误读为 `0 Ω` 已纠正。随后用户按指导加接动力 0 V 与逻辑 GND 的专用参考线，并报告两点间断电电阻已接近表笔短接读数；未提供具体数值或装配照片，此结果按用户报告记录为公共参考地已导通，不证明 GIM 粗黑线到插头 `GND` 触点本身已逐线核验。用户另报告可调电源空载时红夹相对黑夹为直流约 `+24 V`，未提供万用表照片；随后报告已将可调电源低压输出线接到 WAGO，并自查接线无问题。在要求暂时隔离 GIM 粗红正线、测量 WAGO 正负后，用户回复“都没有问题”；未提供改线后照片、具体表显或 GIM 粗红线复位状态，先前照片只显示未接电源的旧状态。用户决定先不安装动力保险，不等于已具备过流保护。正负分组及夹持情况目前仅有用户自查报告，驱动器动力是否仍断开尚未核实；照片对 CANH/CANL 的线色判断一致，但不把本接线记为已上电或已收到 CAN 反馈。

2026-10-01 动态观察：上述段落记述的是首次通电前的证据边界。用户明确报告打开 GIM 电源后，NUCLEO 的 COM10 `shoulder` 查询显示 CAN1 `rx` 从 10549 增至 10605，随后从 29505 增至 29672；`seen=1`，最近帧为标准数据帧 ID `0x029`、DLC 8、数据 `00 00 00 00 00 00 00 00`、年龄 2–9 ms。CAN2 `elbow` 同期 `rx=0 seen=0`，`output_allowed=0`。CAN1 `err` 从 1 增至 11，`last_err=0x00000010` 对应当前 STM32 HAL 的帧格式错误，`bus_off=0`，无软件丢帧或 FIFO 溢出。按 GIM 手册 rev2.2 CAN Simple 的 ID 分段，`0x029` 可拆为节点 1、命令 `0x009`（编码器位置/速度估计）；但尚未独立读取该驱动器当前协议/节点配置，也未验证全零载荷与真实轴状态的对应关系，因此只确认持续收到肩侧原始帧，不将其记作有效角度、无错链路或运动安全验收。此刻未发送运动命令，未安装动力保险；电源实际电压和接线端子温升均未由工具实测。

| 网络/用途 | 起点 | 终点 | 要求 |
|---|---|---|---|
| USB逻辑供电/调试 | 电脑USB | NUCLEO CN1 Mini-B | 已有数据线；不为电机供动力 |
| 肩部CAN发送 | PB9 / CN10-5 / CAN1_TX AF9 | CAN-01 TX（D） | TX对TX，不交叉 |
| 肩部CAN接收 | CAN-01 RX（R） | PB8 / CN10-3 / CAN1_RX AF9 | 3.3V逻辑 |
| 肘部CAN发送 | PB13 / CN10-30 / CAN2_TX AF9 | CAN-02 TX（D） | TX对TX |
| 肘部CAN接收 | CAN-02 RX（R） | PB12 / CN10-16 / CAN2_RX AF9 | 3.3V逻辑 |
| 3.3V | CN7-16 | 两CAN模块3.3V及HX711 VCC（2026-10-16方案B） | 通过分线，不接5V |
| 5V | CN7-18 | 方案B下暂不使用 | 不直接进入MCU信号脚 |
| 逻辑地 | CN7-20 | 两CAN GND、HX711 GND | 分线端子互联建立同一逻辑地 |
| HX711时钟 | PC3 / CN7-37 | HX711 SCK直连，不加下拉（2026-10-16用户决定） | 固件在`MX_GPIO_Init`用户区先置低、再配置为推挽输出。复位到GPIO初始化前的数毫秒内SCK悬空，HX711可能短暂掉电，SCK回低后按手册复位恢复，驱动须等首个DOUT就绪；高脉冲不超过50µs；读取驱动尚未接入 |
| HX711数据 | HX711 DOUT/DT | PC2 / CN7-35直连 | GPIO输入无内部上下拉；不误接桥路B+ |
| 肩部CAN高/低 | CAN-01 H/L | GDS68配套线CANH/CANL | 一对双绞线；按触点功能核对线束，不猜颜色 |
| 肘部CAN高 | CAN-02 H | C620 CAN B红线 | 此红线不是24V |
| 肘部CAN低 | CAN-02 L | C620 CAN A黑线 | 此黑线不是GND |
| +24V主干 | 电源+V（1/2/3选一） | 动力保护/正极分配 | 具体保护器件待选；总电流不乘三 |
| 动力0V主干 | 电源−V（4/5/6选一） | 动力负极分配 | 按总回流选线 |
| 肩部动力 | 动力正/负分配 | GDS68 VBUS/GND | 使用已有XT30(2+2)-F配套线 |
| 肘部动力 | 动力正/负分配 | C620电源正/负 | 使用已有配套电源线，核对极性 |
| 公共参考地 | 动力0V分配 | 逻辑GND分配 | 专用连接；不承担电机负载回流 |
| 电机连接 | C620三相和7-pin接口 | M3508同色三相与7-pin | 原厂线束，不定义未公开内部针序 |
| 称重桥 | 传感器红/黑/绿（部分图蓝）/白 | HX711 E+/E−/A+/A− | 核对实际传感器；B通道不接 |
| 交流输入 | 火线/零线/PE | 电源9/L、8/N、7/保护地 | 先核对输入档位及防触碰结构 |

2026-10-01肘侧现场更新（用户断电测量/自查报告）：CAN-02单独H/L约120Ω，C620单独H/L约120Ω，恢复完整肘侧连接后H/L约60Ω；该组重测替代此次此前不可靠的0Ω/OL/120Ω读数，不替代肩侧CAN-01既有120Ω记录。用户确认C620动力粗红为正、粗黑为负，CAN_H/L、原厂三相和7-Pin已连接并自查完成，PWM不接；记录为用户报告，不声称本代理独立仪器验收。24V保持断开；当前仅NUCLEO USB供电的COM10查询确认S2_CAN_RX、output_allowed=0、CAN2启动成功/名义1Mbps，尚无驱动器真实反馈或24V静态验收。GDS68动力支路与C620共用24V源，安排C620单路供电前需在断电下物理隔离GDS68正极支路，避免一并上电。

2026-10-01肘侧只读接收更新：COM10的180秒记录已收到累计9185帧、最近ID0x201/DLC8，按C620手册对应ID1原始反馈；累计2次HAL CAN错误（0x08 Stuff、0x80 Bit dominant），此窗口现场供电切换时刻尚未对应，不能记为无错链路或完整S2反馈验收。该次采集的板上固件只有原始监视。随后按用户批准新增C620转子rad/rad/s解析和有效接收时间戳，ID1/暂定100ms集中在s2_config.h，离线测试与Debug构建通过，尚未烧录；当前板上镜像仍不能查询新反馈或设备在线状态。GDS68动力插头已获用户确认拔下并保护，肩侧在该窗口无帧；用户事后确认两次上电但未提供精确时刻，目前24V已关闭、USB保留。

### 10.3 供电、终端与线束约束

- USB供电按UM1724第21–23页：JP5选U5V（1–2），JP6接通，JP1按相应USB枚举方案核对；JP1 OFF枚举方案总板及扩展负载上限300mA，不能把该值当扩展余量。还须计入NUCLEO、两收发器和HX711（含约1000Ω称重桥，3.3V下约3mA）；3.3V稳压器额定值不替代USB总预算。
- 每条CAN总线设计为两个末端各120Ω：收发器参考板固定120Ω，远端GDS68软件使能/C620开关接入。实物确认后全系统断电测H/L约60Ω；不是用万用表验证线缆特性阻抗。GDS68参数与板版本对应后再设置，不盲目加第三只120Ω。
- Waveshare参考原理图P1针号为1TX/2RX/3GND/4(3.3V)；商品图从上到下显示3.3V/GND/RX/TX，方向相反，不能据此给到货模块直接编号。接线以实物信号丝印和电路一致性为准。黄色双针为H/L并行接口，不是终端开关。
- HX711参考板VCC连DVDD及VSUP。原设计为5V供电并做双向相反通道的电平转换，不采购仅写"自动双向"的板（两侧上拉使SCK默认为高）。2026-10-16用户改选方案B：VCC接3.3V，SCK/DOUT与MCU直连，按HX711手册DVDD 2.6–5.5V、VIH=0.7·DVDD≈2.3V。配套原理图模拟稳压目标约4.3V，在3.3V下会饱和，E+预计约3.0–3.2V（传感器推荐激励3–12V的下沿），属于未验证的整板配置；首次上电先测E+−E−电压。
- RV2.5mm²红/黑各2m是固定台架主干采购建议，不是厂家规定或已验证载流能力；关节活动段另核验柔性、弯折和应力释放。CAN建议2×0.3mm²双绞线，特性阻抗向供应商核实。
- WAGO221-415六个仅为分线用量预估（动力两组、3.3V、5V、逻辑地两组）；221-412四个仅在两路CAN都需延长时使用。一只端子各孔同电位，不能将正负或H/L插入同一只。需确认实际产品适用细绞线截面积；0.14mm²下限不适合常见26/28AWG细线，优先匹配0.2–0.3mm²逻辑线。不得把杜邦金属接头当裸线夹入。数量及品牌不作为已采购事实。

### 10.4 后续验证与配置边界

GDS68硬件/固件及当前CAN接口/波特率/ID/协议已于2026-10-02只读核实，见第4.2.3节；软件终端enable_r120=true/r120_gpio_num=5已于2026-10-03只读确认，实物导通未证实。电源输入档位和实物丝印、CAN模块排针及电阻、HX711 PCB一致性仍按各自记录核对。终端配置、GDS68协议/波特率/ID、C620 ID、限流与控制周期在通信/动力调试前落实；手册通信方法存在不代表当前设备已经配置。初次测试前还需完成动力保护、急停和回生设计；不得用本表宣称系统已经可以直接上电或穿戴。C620控制模式固定CAN，不同时连接PWM。

2026-10-02当前板上状态更新：按用户明确确认24V关闭、仅USB连接，已将上述C620只读源码对应Debug ELF烧录并校验成功，ST-LINK/STM32F446身份匹配；USB-only新elbowfeedback可查询ID1，seen/valid/online均0、数据和时间为na，两路CAN收帧/错误计数0、output_allowed=0。此前2026-10-01“尚未烧录/当前板不能查询”的记录是当时状态，现已被本次实测更新。24V未由本机独立测量；没有进行带电反馈、超时恢复或运动验收，不能由无样本记为S2完成。GDS动力隔离及其他现场条件仍由主对话协调下一步，不重测已确认肘侧60Ω。

2026-10-02 C620静态接收状态：同一只读采集中已实测有效收帧、断电后valid/online=0且旧时间戳不刷新、2026-10-02T01:24:21.1462311Z新帧恢复valid/online=1；全窗口CAN/串口/调度错误0、output_allowed=0，GDS隔离无帧。按用户减少测试要求，恢复确认后于01:24:56.459 UTC关闭串口，不追加已过项。100ms精确边界、独立角度/非零速度真值未测；S2肩侧及双路仍待完成。最后观察C620在线，现场24V是否随后关闭须按用户报告记录，不由端口关闭推定。
