46564645/Surgery_exoskeleton/Main_ project/Hardware_information_list/motor_can_diagrams_text.md

# 电机与 CAN 模块图纸的详细文字描述

> 整理日期：2026-09-26。目标是只读本文即可理解**这些资料图中的电气连接**。下文把厂家图、参考板原理图与本项目的接线设计分别标出；资料图不能证明到货实物一致，也不表示整机已经可以接通动力电源。当前接口和验证状态的权威登记仍是[硬件接口编码表](hardware_interface_registry.md)。

## 0. 先分清图的种类和读法

本文件涉及四个对象：肩侧一体电机 `GIM6010-8/GDS68`、肘部 `C620` 电调与裸 `M3508` 电机、两块 `SN65HVD230` CAN 收发模块。GDS68、C620、M3508 手册给的是**外部接口/线束示意**，没有公开完整内部电路；Waveshare 的 SN65HVD230 文件才是**板级原理图**，可以沿导线追到芯片引脚和电阻。

文中的 `H/L` 是 CAN 总线的高线/低线；`TX/RX` 是 MCU 与 CAN 收发器间的数字信号；`VBUS/+24V` 与 `GND/0V` 是动力电源的正负端。`CAN_L` 虽可能是黑线，仍是信号线，不能当作 0V。接插件上的 `P1-1` 等数字只属于对应图纸；连接器公母端翻转后，观察到的左右顺序可能相反。未给针号的图，本文只记录**信号名称**，不自造针号。

### 0.1 手册读取入口

**AI 有对应型号和版本、且正文可读的 Word 时优先读 Word 正文和表格；没有合适或可读的 Word 时再读 PDF。**下列 Word 文件是仓库已有的阅读版本，本轮未转换或改写手册。接头朝向、针号和图中线路同时核对原 PDF/原理图；Word 中的图片不能因只抽取文字而被忽略。遇到乱码、漏字、数值歧义或版本不一致时回查原件。本文及接口登记中的页码均指原 PDF，Word 重排后的页码不能直接套用。

| 对象与用途 | Word 正文入口（优先） | 原 PDF/原理图（核对图示、版本与页码） |
|---|---|---|
| NUCLEO-F446RE / UM1724 | [UM1724 Word](all_hardware_relevant_documents/um1724-stm32-nucleo64-boards-mb1136-stmicroelectronics.docx) | [UM1724 Rev 17 PDF](all_hardware_relevant_documents/um1724-stm32-nucleo64-boards-mb1136-stmicroelectronics.pdf) |
| GIM6010-8 / GDS68 | [GIM6010-8 手册 Word](all_hardware_relevant_documents/ABUIABA9GAAgzpi6wQYoh9D9CQ.docx) | [手册 rev2.2 PDF](all_hardware_relevant_documents/ABUIABA9GAAgzpi6wQYoh9D9CQ.pdf) |
| 裸 M3508 | [M3508 v1.0 2025.10 Word](all_hardware_relevant_documents/RoboMaster_M3508_Brushless_DC_Motor_User_Guide_v1.0_2025.10.docx) | [同版 PDF](all_hardware_relevant_documents/RoboMaster_M3508_Brushless_DC_Motor_User_Guide_v1.0_2025.10.pdf) |
| SN65HVD230 芯片功能、引脚和 Rs 模式 | [TI Rev O Word](all_hardware_relevant_documents/SN65HVD230_CAN_module/TI_SN65HVD23x_3.3V_CAN_Transceivers_RevO.docx) | [TI Rev O PDF](all_hardware_relevant_documents/SN65HVD230_CAN_module/TI_SN65HVD23x_3.3V_CAN_Transceivers_RevO.pdf) |
| C620 外部接口与线束 | 当前未收集对应 Word | [C620 V1.01 PDF](all_hardware_relevant_documents/RoboMaster_C620_Brushless_DC_Motor_Speed_Controller_V1.01.pdf) |
| Waveshare CAN 参考模块逐器件连接 | 当前未收集原理图 Word | [参考模块原理图 PDF](all_hardware_relevant_documents/SN65HVD230_CAN_module/Waveshare_SN65HVD230_CAN_Board_Schematic.pdf) |
| MB1136 C04 板级原理图 | 当前未收集原理图 Word | [ST 官方 C04 PDF](https://www.st.com/resource/en/schematic_pack/mb1136-default-c04_schematic.pdf)；项目接口可读[结构化 JSON](nucleo_f446re_mb1136_c04_ai.json) |

`Waveshare_SN65HVD230_CAN_Board_Datasheets.docx` 是旧版 TI 芯片资料（Rev G），不是模块原理图。当前芯片说明读取上表的 TI Rev O；模块 P1 针序、10 kΩ 和 120 Ω 连接仍看 Waveshare 原理图，不能用芯片资料代替模块电路。

## 1. SN65HVD230 CAN 收发模块：把整张参考原理图写成网表

**资料及适用范围：** [Waveshare SN65HVD230 CAN Board Schematic](all_hardware_relevant_documents/SN65HVD230_CAN_module/Waveshare_SN65HVD230_CAN_Board_Schematic.pdf) 第 1 页；芯片脚功能和 `Rs` 模式另核对 [TI SN65HVD23x 数据手册 Rev O](all_hardware_relevant_documents/SN65HVD230_CAN_module/TI_SN65HVD23x_3.3V_CAN_Transceivers_RevO.pdf) 第 5、21～23 页。以下是**参考板**，不是到货 `CAN-01/02` 的实测网表。

### 1.1 图中有哪些器件

| 图中编号 | 器件/数值 | 电气作用 |
|---|---|---|
| `P1` | 四针 MCU 侧排针 | 向模块提供 3.3 V 与 GND，传入 CAN_TX，取出 CAN_RX。 |
| `U1` | `SN65HVD230` 八脚芯片 | 在 TX/RX 数字信号与 CANH/CANL 双线总线之间收发信号；它本身不是 CAN 控制器。 |
| `R1` | 10 kΩ | 从 U1 的 `Rs` 脚接到 GND。TI 将这种 10～100 kΩ 下拉列为斜率控制模式；它不是终端电阻。 |
| `R2` | 120 Ω | 直接跨接 CANH 和 CANL，作为图中的固定终端电阻。 |
| `can1` | 两针总线侧端子 | 第 1 针为 CANL，第 2 针为 CANH。图中没有给总线参考地的第三针。 |

### 1.2 从 P1 逐针追到 U1

| 参考图针号 | 信号与方向（相对模块） | 图中导线的去向 |
|---|---|---|
| `P1-1` | `CAN_TX`，模块输入 | 直接到 `U1-1 D`，芯片的发送数据输入脚；由 MCU 的 CAN_TX 驱动。 |
| `P1-2` | `CAN_RX`，模块输出 | 直接来自 `U1-4 R`，芯片的接收数据输出脚；送到 MCU 的 CAN_RX。 |
| `P1-3` | `GND` | 与 `U1-2 GND` 和 `R1` 的接地端共网。 |
| `P1-4` | `3.3V` | 到 `U1-3 VCC`；图中没有从 5 V 转成 3.3 V 的稳压器。 |

**核对观察方向：** 原理图按数字列出 `1 TX / 2 RX / 3 GND / 4 3.3V`。资料中的商品照片从上到下印着 `3.3V / GND / RX / TX`，这与按另一方向读取上述四针相符，但照片没有直接标出 `P1-1`。到货模块必须以本块 PCB 的丝印和触点为准，不能把参考图的数字方向直接套到实物。接口登记曾把参考图的 2～4 针顺序写反，已按原图更正。

### 1.3 从 U1 的每个脚追到电路另一端

| `U1` 脚 | 芯片脚名 | 本图中的完整外部连接 |
|---|---|---|
| 1 | `D` | 接 `P1-1 CAN_TX`，无串联器件画在这条线上。 |
| 2 | `GND` | 接 `P1-3 GND`；与 R1 的下端共地。 |
| 3 | `VCC` | 接 `P1-4 3.3V`。 |
| 4 | `R` | 接 `P1-2 CAN_RX`，无串联器件画在这条线上。 |
| 5 | `Vref` | 图中的引出线到此为止，没有连接 P1、can1 或其他器件。 |
| 6 | `CANL` | 接 `can1-1`，也接 R2 的低线一端。 |
| 7 | `CANH` | 接 `can1-2`，也接 R2 的高线一端。 |
| 8 | `Rs` | 只经 `R1=10 kΩ` 下拉到 GND；没有 MCU 控制开关。 |

`R2=120 Ω` 的两端分别接 `U1-7/can1-2` 与 `U1-6/can1-1`，因此在参考图中它始终跨在 CANH/CANL 上，没有可拔插的“终端使能跳帽”。图中也没有画隔离器、TVS 或电源去耦电容；这句话只描述**图纸未画**，不能推出到货板一定没有这些器件。商品照片中的黄色两针并行接出 H/L，不应误认为终端开关。

### 1.4 沿信号看工作过程

发送方向为 `MCU CAN_TX → P1-1 → U1 的 D 脚 → U1 的 CANH/CANL 脚 → 两线总线`；接收方向为 `两线总线 → U1 的 CANH/CANL 脚 → U1 的 R 脚 → P1-2 → MCU CAN_RX`。TI 数据手册说明：`D` 为低时请求显性总线状态，接收器识别显性时 `R` 为低；这些逻辑电平不是把 H/L 当作一根 TX、一根 RX。`Rs` 的 10 kΩ 下拉使收发器处于斜率控制模式，不是“只接收”或断电模式；具体总线速率仍由 MCU 的 CAN 控制器与远端设备配置决定。

## 2. 肩侧 GIM6010-8 / GDS68：板上位置与外部接头

**资料及适用范围：** [GIM6010-8 使用手册 rev2.2](all_hardware_relevant_documents/ABUIABA9GAAgzpi6wQYoh9D9CQ.pdf) 第 9～14 页，尤其 2.2 与 2.4.1～2.4.8 节；供电与 Type-C 边界见第 3、15～16 页，终端设置见第 38 页。手册图画的是驱动板或焊盘的**一个观察视角**，不是插上线束后从线端看过去的镜像图，也没有公开板内 CAN 收发器或三相功率级的逐器件电路。

### 2.1 第 9 页：整块驱动板的位置示意

在手册第 9 页的板面图中，标号 `1` 是电源/CAN 共用接头，`2` 是 Type-C 调试口，`3` 是扩展插槽，`4` 是 SWD 焊孔，`5` 是第二编码器焊孔，`6` 是电机温度焊孔，`7` 是抱闸/制动电阻与限位相关焊孔。板面还画有 `U/V/W` 三相绕组焊接孔；它们是驱动板与 GIM6010-8 电机绕组之间的连接点，不是给 STM32 或外部 CAN 模块使用的针脚。项目使用成套一体电机，不据此拆改已装配的相线。

### 2.2 第 10 页：XT30(2+2) 上的四个信号

板端型号为 `XT30PB(2+2)-M`，配套线端型号为 `XT30(2+2)-F`。在手册图的**板侧正面视角**，Type-C 口在接头左边；接头左边两只较大的动力触点依次标 `VBUS`、`GND`，右边两只较小的通信触点标 `CANH`（上）、`CANL`（下）。这一方向描述仅帮助辨认原图，线端公母接插件的观察方向必须另行核对。手册没有为这四触点提供类似 `1～4` 的可靠编号，故下表不用数字针号。

| 接头信号 | 由图和手册确认的作用 | 在本项目的设计去向 |
|---|---|---|
| `VBUS` | GDS68 直流母线正输入。 | 经动力保护/分配后接 +24 V 支路。 |
| `GND` | GDS68 直流母线负输入。 | 回到动力 0 V 分配；它不是 CANL。 |
| `CANH` | CAN 总线高线；其他模式可复用此触点。 | 接肩侧 `CAN-01` 的 H。 |
| `CANL` | CAN 总线低线；其他模式可复用此触点。 | 接肩侧 `CAN-01` 的 L。 |

在 PWM 模式下 `CANH` 可成为 PWM 输入；在脉冲/方向模式下 `CANH` 为脉冲、`CANL` 为方向；某些版本又可复用为 RS485 A/B。**当前选 CAN 模式**，不能把这些其他模式的线义同时使用。Type-C 是调试/上位机通信口，手册说明它不为驱动器提供动力。手册特别说明驱动板没有电源反接保护，因此 VBUS/GND 不能只靠线色或图片左右位置决定。

手册第 9～10 页的通用电压表有 15～60 V、额定 15～48 V 和最小/最大 12/72 V 等不同表述；本项目订单明确是**旧 24 V、Y-48、12～48 V 选项**。这些不同版本/口径不能拼成到货电机的允许电压或运行限值；本文件只按项目选定 24 V 描述连接。

### 2.3 第 11～14 页：图中还能看到的辅助接口

以下接口均为手册图示能力，**目前不进入项目接线**。记录它们是为了以后只看文字也能辨识图中的焊盘；不把“手册有”写成“到货板有”。

| 图页与接口 | 图上信号的排列和连接 | 本项目边界 |
|---|---|---|
| 第 12 页 SWD 四焊孔 | 按该页的板面图从上至下为 `SWDIO`、`GND`、`SWDCLK`、`3.3V`；2 mm 间距。 | 用于驱动器调试/下载，不是 NUCLEO 的 CAN 接口；当前不用，也不刷固件。 |
| 第 12 页第二编码器四焊孔 | 按板面图从左到右为 `GND`、`3.3V`、`TX/SCL`、`RX/SDA`；后两针在 USART/I2C 两种模式下复用。 | 第二编码器未纳入本次 S2 接线。 |
| 第 12 页电机温度两焊孔 | `MOT_TEMP` 与 `GND`；手册说电机内置 10 kΩ NTC，两根引线无极性。 | 这是电机温度输入，不能接作 CAN GND/H/L。 |
| 第 13～14 页边缘五焊孔 | 沿图示板边从上到下为 `EMG`、`GND`、`12V`、`LW1`、`LW2`。最上方 `EMG/GND` 两焊孔用于抱闸或外接制动/泄放电阻；下方 `12V/LW1/LW2` 连同公共 GND 用于限位开关。`LW1` 为最小位置，`LW2` 为最大位置。 | 抱闸、泄放电阻和限位开关均未选型或启用；`EMG` 不是本项目急停输入的已接线路。 |

**第 11 页的 20 针扩展插槽**：手册明确说硬件版本 3.9 及以后不再提供；本项目 GDS68 板版本未读到，因此不能把它当作实际存在。为完整记录图中文字，图上的左列 `1～10` 为：`1 GND`、`2 SPI_MOSI`、`3 SPI_MISO`、`4 SPI_SCK`、`5 EXT_NSS`、`6 USART_EN`、`7 USART_RX`、`8 USART_TX`、`9 GPIO1`、`10 GPIO2`。右列 `11～20` 为：`11 EXT_SDA_RX`、`12 EXT_SCL_TX`、`13 GND`、`14 DIR_IN`、`15 PWM_IN_OUT`、`16 GND`、`17 3.3V`、`18 3.3V`、`19 VOL_CTRL`、`20 DC_5V`。图中 `VOL_CTRL` 另经 `C98=0.1 µF` 到 GND；这只是图中连接，不为该口推定用途或外部负载能力。CAN 接线不经过这个扩展插槽。

手册第 38 页另称驱动器可使能/关闭板载 120 Ω CAN 匹配电阻，并给出软件配置例子；是否适用于本项目旧板、是否已使能，须读实物版本和设置后才能判断。不能仅因手册存在该选项就认为当前总线已有远端终端。

## 3. 肘部 C620 与裸 M3508：所有图示线束分别做什么

**资料及适用范围：** [C620 使用说明 V1.01](all_hardware_relevant_documents/RoboMaster_C620_Brushless_DC_Motor_Speed_Controller_V1.01.pdf) 中文第 23～25 页；[裸 M3508 使用说明 v1.0](all_hardware_relevant_documents/RoboMaster_M3508_Brushless_DC_Motor_User_Guide_v1.0_2025.10.pdf) 中文第 6 页（PDF 第 8 页）。两份手册画了器件端口和接法，没有给出 C620 功率级、M3508 内部绕组或 7-Pin 内部逐针电路。

### 3.1 C620 图中 `[1]`～`[8]` 的含义

| 图示序号 | 端口或操作件 | 连到哪里，以及在本项目中的用法 |
|---|---|---|
| `[1]` | 7-Pin 电机数据端口 | 通过随电机/电调的 7-Pin 数据线连接 M3508 的 7-Pin 数据端口。不能把这根线当 CAN 线。 |
| `[2]` | 三相动力线接头 | 接 M3508 的三相输入接头；同色对同色，依防反插结构连接。M3508 的动力由这条线从 C620 输出。 |
| `[3]` | 120 Ω 终端电阻选择开关 | ON 接入 C620 板载 CAN 终端，OFF 断开；只作用于 C620 所在 CAN 总线。 |
| `[4]` | SET 按键 | 厂家用于 ID 设置等操作；不是急停键。 |
| `[5]` | 电源线 | 额定 24 V 输入，插头兼容 XT30；接本项目的肘部 24 V/动力 0 V 支路，极性按实物核对。 |
| `[6]` | 状态指示灯 | 显示 C620 状态；它不构成 CAN 物理接线。 |
| `[7]` | CAN 信号端口 | 插入厂家 CAN 信号线，以 1 Mbps 与控制板通信；本项目连接 `CAN-02`。 |
| `[8]` | PWM 信号端口 | 用于另一种控制方式，也可供厂家配置/升级工具连接；本项目 CAN 运行时不接。 |

### 3.2 CAN 两芯线、PWM 三芯线与电机线不可混用

手册第 25 页把 **CAN 线**画成两芯，按该页线束图从上到下标 `A`、`B`：`A=黑色 CAN_L`，`B=红色 CAN_H`。在本项目，A 接 `CAN-02 L`，B 接 `CAN-02 H`；两芯均不是 C620 的 24 V 电源线。该页另画的 **PWM 线**为三芯：`A=黑色 GND`，`B=灰色 TX`，`C=白色 PWM/RX`。这是另一只端口的线序，不能把 PWM 线的 A/GND 与 CAN 线的 A/CAN_L 混为一谈。手册明确禁止同时插入 CAN 与 PWM 信号线，切换前必须切断 C620 电源。

M3508 手册给出的连接只有两步：一根随附 **7-Pin 数据线**连接 C620 与 M3508 的对应数据端口；另一组**三相接头**连接 C620 三相输出与 M3508 三相输入，同色相接且不强行反插。两份手册没有公开 7-Pin 内部针脚职责，也没有逐针定义三相 U/V/W，因此本文到连接器整体为止。M3508 裸电机不接到 24 V 直流母线，且不套用带 P19 减速器的参数。

### 3.3 沿电源和信号分别追完整路径

动力路径：`24 V 电源 → 动力保护/分配 → C620 [5] 电源线 → C620 内部驱动（手册未展开） → C620 [2] 三相线 → M3508 三相输入`；动力回流从 C620 电源负端回到动力 0 V 分配，不经 NUCLEO 或 CAN 信号线。电机数据路径：`M3508 的 7-Pin 数据端口 ↔ 原厂 7-Pin 数据线 ↔ C620 [1]`。通信路径：`STM32 CAN2 ↔ CAN-02 收发模块 ↔ 独立肘部 CANH/CANL 双线 ↔ C620 [7] CAN 端口`。这三条路径有不同的连接器，不得互相替代。

C620 手册明确 CAN 速率 1 Mbps，并通过 `[3]` 开关选择板载终端。但“手册规定速率/有开关”不等于本机 ID 已读取、开关位置已确认或总线上已收到反馈。

## 4. 把两套图放到本项目：从 MCU 到驱动器的逐线文字图

下表是[项目接口登记第 10 节](hardware_interface_registry.md#10-台架接线设计分配2026-09-24)的**设计映射**，用于把前述资料图连起来。MCU 引脚与板针位已选择；驱动器 H/L、动力、终端和模块内部电阻仍需实物测量。两套 CAN 收发模块结构相同，但电气上是两条**互不相连的 CANH/CANL 总线**。

| 独立链路 | 从 STM32 到收发模块 | 从收发模块到驱动器 |
|---|---|---|
| 肩侧 `CAN-01` | `PB9/CN10-5 CAN1_TX → 模块 TX/P1-1 → U1-D`；`U1-R → 模块 RX/P1-2 → PB8/CN10-3 CAN1_RX`。 | `模块 CANH → GDS68 CANH`；`模块 CANL → GDS68 CANL`。GDS68 同一个 XT30(2+2) 的另外两触点另接 24 V 的 VBUS/GND。 |
| 肘部 `CAN-02` | `PB13/CN10-30 CAN2_TX → 模块 TX/P1-1 → U1-D`；`U1-R → 模块 RX/P1-2 → PB12/CN10-16 CAN2_RX`。 | `模块 CANH → C620 CAN 线 B/红/CAN_H`；`模块 CANL → C620 CAN 线 A/黑/CAN_L`。C620 的 XT30 电源、三相线和 7-Pin 线另走各自连接器。 |
| 两模块逻辑供电 | NUCLEO `CN7-16 3.3V → 两块模块各自的 3.3V`；`CN7-20 GND → 两块模块各自的 GND`。 | 非隔离系统的逻辑参考地与动力 0 V 按接口登记建立专用参考连接；电机负载回流不走开发板、面包板或杜邦线。 |

表中的 `P1-1/2` 只表示 **Waveshare 参考图的网络名和针号**。对用户已接的到货模块，优先看它自身的 `TX/RX/3.3V/GND` 丝印；现场线色（肩侧 TX 白、RX 红；肘部 TX 紫、RX 橙）是一次照片辨识及用户确认的记录，**线色不替代端点核对**。CAN TX 接模块 TX、CAN RX 接模块 RX，不按 UART 串口交叉。NUCLEO 当前由电脑 USB 供逻辑电，两台驱动器另由 24 V 电源供动力；USB 不能给电机供动力。

每条双节点 CAN 总线原则上在两个物理末端各接一个 120 Ω：参考收发板的 R2 已固定跨 H/L，远端分别是 GDS68 的可配置终端或 C620 的终端开关。**只有在实物确认两端终端都存在且全系统断电时**，从该条 H/L 两端测到约 60 Ω 才是两个 120 Ω 并联的预期值；读数异常需继续查线路、开关或实际模块版本，不能盲加第三只电阻。肩侧和肘部的 H/L 不相连，也不能拿一条总线的终端去补另一条。

## 5. 单凭这些图仍不能得出的结论

- GDS68 到货板的硬件/固件版本、CAN 模式、波特率、节点 ID、终端是否使能，以及 XT30(2+2) 配套线的实物触点方向，图中都没有实测值。
- 到货 `CAN-01/02` 是否与 Waveshare 参考板完全同版、P1 数字方向、R1/R2 是否真按原理图装配、3.3 V 和 GND 是否正确，仍须对每块板核对丝印并断电测量。
- C620 的实物 CAN 终端开关位置、ID、XT30 极性和线束完好状态，以及 M3508 的实际三相接头状态，不能仅凭手册图认定。
- 厂家没有在这些图中展开 GDS68/C620 功率级、7-Pin 内部针位或整机保险、急停、回生电路。本项目动力保护器件仍待落实，不能把本文当成完整可上电施工图。
- 截至开发日志所记的 S2 第一轮验证，两路 STM32 CAN 控制器可启动并查询，但 `seen=0`；这只说明尚未观察到真实驱动器报文，不构成电机在线或反馈解析完成的证据。

## 6. STM32 板卡 C04 的 AI 结构化资料

用户于 2026-09-26 报告板卡版本为 C04，正面照片已可见 `MB1136 rev C`。对应资料为 [ST 官方 MB1136-DEFAULT-C04 原理图](https://www.st.com/resource/en/schematic_pack/mb1136-default-c04_schematic.pdf)，共 5 页，覆盖总览、电源、目标 MCU、ST-LINK 和扩展连接器。官网列出 PDF 原理图与设计工程 ZIP，尚未找到官方提供的电路 JSON。

给 AI 使用的 [nucleo_f446re_mb1136_c04_ai.json](nucleo_f446re_mb1136_c04_ai.json) 已保存于同目录。它记录项目所用 6 个信号脚的 MCU 封装脚号与板连接器针号、USB/SWD/VCP/按键/LED 接口、电源针位，以及双 CAN 和 HX711 的外部接线设计。每项区分资料连接、用户报告和未实测状态；JSON 可直接作为文本读取。

这份 JSON 是**项目所用接口的结构化摘录，不是整板完整网表**：没有逐针重建全部阻容、ST-LINK 内部电路和所有焊桥。官方 C04 是多型号共用图，不能将共用符号中的全部候选引脚名都视为 F446RE。当前直接下载未取得有效 PDF 原件，因此未登记 PDF 校验值；背标照片、焊桥/跳线状态与电气测量仍按接口登记核对。
