46564645/Surgery_exoskeleton/Main_ project/Hardware_information_list/all_hardware_relevant_documents/S-250-24_power_supply/SOURCE.md

# S-250-24 Power Supply References

## Selected product screenshot

- File: `user_selected_S-250-24_24V_10A.png`
- Evidence: user-provided seller screenshot
- Recorded: 2026-09-22
- SHA-256: `b2719de01529c9d46ff93eca623ac73cfd2e3144ac78ecbc41a51c71e2857c41`
- Visible selection: S-250-24, DC 24 V, 10 A, seller-rated 250 W
- Visible dimensions: 215 x 115 x 50 mm
- Visible input range: AC 95-132 V / 185-264 V
- Visible seller claims: overload, overvoltage, and short-circuit protection

The seller's 250 W label is retained as a product claim. The nominal electrical
product of 24 V and 10 A is 240 W. Neither value has been verified on the
delivered unit.

## Terminal-label reference screenshot

- File: `seller_terminal_wiring_reference_S-350-24.png`
- Evidence: user-provided seller screenshot
- Recorded: 2026-09-22
- SHA-256: `37812e0b7776bd55b25d06f8636db47d196ceee92bb6c691439a35893b793aad`
- Visible model: S-350-24, DC 24 V, 14.6 A

This second screenshot is a different power-supply model. It is retained only
as a reference for the seller's explanation of L, N, protective earth, +V, -V,
and ADJ labels. Its 14.6 A rating must not be assigned to the selected S-250-24.

## 2026-09-24 补充归档

卖家提供的型号规格书，供应商栏未填写，尚未核对实物一致性。第2页输出参数，第3页保护和输入，第7页端子，第8页安装说明。商品图仍为 S-350-24，不用于 S-250-24 参数或针号判定。商品图来源：https://img.alicdn.com/imgextra/i4/2216884299726/O1CN01VLEuUw2LiZBr6TA4C_!!2216884299726-0-ampmedia.jpg 。卖家称零火线无需区分，不采纳为操作要求：L 接火线，N 接零线，PE 可靠接地。输入选择开关、回生承受能力及端子紧固规格未确定。

- 文件：[seller_terminal_reference_S-350-24_2026-09-24.jpg](<seller_terminal_reference_S-350-24_2026-09-24.jpg>)
  - 原始来源：`/var/folders/12/jbwvkcys6s7539kd4bj7_yhm0000gn/T/codex-clipboard-a1076b10-6eea-41c6-816a-0d5d75152c0e.jpg`
  - SHA-256：`c1b2080797a8166ca48dd94aea5fbcdc9430c6102f31c48456f38f25683c1cc3`

### 原PDF缺失说明

原PDF在本轮归档时已从剪贴板临时目录消失，尚未归档。不得把本目录商品JPG或读取记录说成原PDF。保留[读取记录](specification_reading_record.md)及此前生成的第7页派生图；收到原件后补录PDF校验值。
- [specification_reading_record.md](specification_reading_record.md) SHA-256：`f25896573696a96368db2140aee5c56151b92673195ad87e59b6c081689d7883`。
- [specification_page7_render.png](specification_page7_render.png) SHA-256：`5a026fdccf3ec8c824f1bedcd9a6031fea7b9268a720f0b9c700555d1ca46cd8`。
