46564645/Surgery_exoskeleton/Main_ project/Hardware_information_list/all_hardware_relevant_documents/SN65HVD230_CAN_module/SOURCE.md

# SN65HVD230 CAN Module References

## Texas Instruments document

- File: `TI_SN65HVD23x_3.3V_CAN_Transceivers_RevO.pdf`
- Source: https://www.ti.com/lit/ds/symlink/sn65hvd230.pdf
- Product page: https://www.ti.com/product/SN65HVD230
- Downloaded: 2026-09-22
- SHA-256: `e98fc0c59168c035d7958111924dae7e21e46ab45bdfd6400aef048299d6d716`

The PDF is the Texas Instruments chip-level datasheet for SN65HVD230,
SN65HVD231, and SN65HVD232. It does not define the PCB pin order,
termination resistor, jumpers, or protection components of the user's module.

## Waveshare board documents

- Wiki: https://www.waveshare.com/wiki/SN65HVD230_CAN_Board
- Schematic: `Waveshare_SN65HVD230_CAN_Board_Schematic.pdf`
- Schematic source: https://files.waveshare.com/upload/c/c5/SN65HVD230-CAN-Board-Schematic.pdf
- Schematic SHA-256: `7f1862fb51dc0252b89cca1e81af58cc27bb59250ff78bdcf52ddb7fc3f87338`
- Datasheet bundle: `Waveshare_SN65HVD230_CAN_Board_Datasheets.pdf`
- Datasheet source: https://files.waveshare.com/upload/3/3a/SN65HVD230-CAN-Board-Datasheets.pdf
- Datasheet SHA-256: `6104a3617c3f5a921dde069a82f8a702210d75b669ca18354a3e43ce920ebecb`
- Example code: `Waveshare_SN65HVD230_CAN_Board_Code.7z`
- Example code source: https://files.waveshare.com/upload/c/ca/SN65HVD230-CAN-Board-Code.7z
- Example code SHA-256: `636b7079af1e0e977582540f66b1fd72df14f422821f9f401e24cfb70728205a`
- Downloaded: 2026-09-22

The seller screenshot links to this Waveshare board page and shows the same
pin labels and fixed 120-ohm termination resistor. The yellow two-pin part in
the image is a parallel CANH/CANL header, not a termination-enable jumper. The
screenshot does not by itself prove that the delivered boards are genuine
Waveshare products or unchanged clones, so the physical boards must still be
checked after delivery.

## User-provided product screenshot

- File: `user_provided_product_screenshot.png`
- SHA-256: `c99950b9148dcb64c313261e7efbffe7270ac13dc4396f0aa5453e3f5d274490`
- Archived: 2026-09-22

## Seller reference supplied by the user

https://www.xinlucity.com/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

The supplied page is a general download index for PCAN, CANable, isolated CAN,
and USB-to-CAN products. No dedicated SN65HVD230 module schematic or download
was found on that page or through its site search on 2026-09-22.
