46564645/Surgery_exoskeleton/firmware/Exoskeleton_F446/.auto-embedded/spec/hardware/_detected.md

# 自动探测结果（草案，待人工确认）

> 由 `aemb init` 扫描工程文件名/扩展名推断，**可能误判**。
> 确认无误后，请把相关信息手工并入 `index.md` 与 `hw-lock.yaml`，再删除本文件。

- 疑似芯片: STM32F4XX, STM32F446XX
- 疑似框架: STM32CubeMX
- 构建系统: CMake

## 证据
- CMake ← CMakeLists.txt
- STM32F4XX ← stm32f4xx_hal_conf.h
- STM32CubeMX ← Exoskeleton_F446.ioc
- STM32F446XX ← stm32f446xx.h
