46564645/Surgery_exoskeleton/Main_ project/Hardware_information_list/all_hardware_relevant_documents/GIM6010-8/drawings/SOURCE.md

# 资料来源与边界

## 2026-09-24 补充归档

来源：用户下载的 Planetary Reduction Motor 中 GIM6010-8.zip；入口 https://steadywin-motor.com/products/document-download 。二维图标记 V1.0 / 2025-07-18。标准版、出轴版、抱闸版和核心组件不能混用；STEP 未验证与到货实物吻合。Parameters PDF 含不同驱动版本，不覆盖旧24V订单。

- 文件：[GIM6010-8  2D Drawing-Brake Version.pdf](<GIM6010-8  2D Drawing-Brake Version.pdf>)
  - 原始来源：`/Users/mzc/Downloads/Planetary Reduction Motor/GIM6010-8.zip :: GIM6010-8/GIM6010-8  2D Drawing-Brake Version.pdf`
  - SHA-256：`45b4d5ec5c96c0780b313f4675192b0772cdf5c294f88b5c237b85cd1027f97c`
- 文件：[GIM6010-8  2D Drawing-Shaft Extension Version.pdf](<GIM6010-8  2D Drawing-Shaft Extension Version.pdf>)
  - 原始来源：`/Users/mzc/Downloads/Planetary Reduction Motor/GIM6010-8.zip :: GIM6010-8/GIM6010-8  2D Drawing-Shaft Extension Version.pdf`
  - SHA-256：`6425dbcfecace1a90b83e8718e7ab5756f1cb9b9a08772046993e94724932d6a`
- 文件：[GIM6010-8  2D Drawing-Standard Version.pdf](<GIM6010-8  2D Drawing-Standard Version.pdf>)
  - 原始来源：`/Users/mzc/Downloads/Planetary Reduction Motor/GIM6010-8.zip :: GIM6010-8/GIM6010-8  2D Drawing-Standard Version.pdf`
  - SHA-256：`b475f3e185b79963751e95eead83e626ba10ad9f7b4133d0d918cb6660a31aed`
- 文件：[GIM6010-8  3D Model-Brake Version.stp](<GIM6010-8  3D Model-Brake Version.stp>)
  - 原始来源：`/Users/mzc/Downloads/Planetary Reduction Motor/GIM6010-8.zip :: GIM6010-8/GIM6010-8  3D Model-Brake Version.stp`
  - SHA-256：`6a82eff1afff1d27de0456f4305c6d04808986cf0031a713daf74cd35b9ce111`
- 文件：[GIM6010-8  3D Model-Standard Version.stp](<GIM6010-8  3D Model-Standard Version.stp>)
  - 原始来源：`/Users/mzc/Downloads/Planetary Reduction Motor/GIM6010-8.zip :: GIM6010-8/GIM6010-8  3D Model-Standard Version.stp`
  - SHA-256：`813edb29802b0b93d09e1dc44090cfa22f18baebe534db3f99e2d2bcd041adff`
- 文件：[GIM6010-8 3D Model-Shaft Extension Version.stp](<GIM6010-8 3D Model-Shaft Extension Version.stp>)
  - 原始来源：`/Users/mzc/Downloads/Planetary Reduction Motor/GIM6010-8.zip :: GIM6010-8/GIM6010-8 3D Model-Shaft Extension Version.stp`
  - SHA-256：`546e39b1ebc0f3b581fa351b8f0367f4e3d779c68b399eff2e66bc51cd29b5d3`
- 文件：[GWK6010-8 2D Drawing.pdf](<GWK6010-8 2D Drawing.pdf>)
  - 原始来源：`/Users/mzc/Downloads/Planetary Reduction Motor/GIM6010-8.zip :: GIM6010-8/GWK6010-8 2D Drawing.pdf`
  - SHA-256：`5d0cbb987b950e13d0eea5b380cd9cd428299655ad1b9409682f0009e241712b`
- 文件：[GWK6010-8 3D Model.stp](<GWK6010-8 3D Model.stp>)
  - 原始来源：`/Users/mzc/Downloads/Planetary Reduction Motor/GIM6010-8.zip :: GIM6010-8/GWK6010-8 3D Model.stp`
  - SHA-256：`5b415b9cabacb6e8ead42c91bd1753b95539ee27727adcb70aa2a620fb83cde7`
- 文件：[Parameters of GIM6010-8    .pdf](<Parameters of GIM6010-8    .pdf>)
  - 原始来源：`/Users/mzc/Downloads/Planetary Reduction Motor/GIM6010-8.zip :: GIM6010-8/Parameters of GIM6010-8    .pdf`
  - SHA-256：`1f1e2697de7b881c07444fae2d2fabfeef83d0513ae0f4b161712fffd02fabd7`
