46564645/Surgery_exoskeleton/Main_ project/Hardware_information_list/all_hardware_relevant_documents/GIM6010-8/selection/SOURCE.md

# 资料来源与边界

## 2026-09-24 补充归档

来源：用户从厂家下载页取得的原始 Excel；包含多型号。关节电机选型表 M列为 GIM6010-8/GDS68/24V，N列为 GDZ468H/48V；没有独立6010-8性能曲线工作表。保留原表，不改参数，不作为旧款实物已确认规格。

- 文件：[Planetary-Reduction-Motor-Selection-Table.xlsx](<Planetary-Reduction-Motor-Selection-Table.xlsx>)
  - 原始来源：`/Users/mzc/Downloads/Planetary-Reduction-Motor-Selection-Table.xlsx`
  - SHA-256：`6b77393c23e02bf0f2beff19fbe3382e30cfd4091dc0b9edbd55612168c5cd03`
