46564645/Surgery_exoskeleton/Main_ project/docs/Drafts/wayfinder/project_blueprint_architecture/tickets/confirm_blueprint_scope.md

---
title: 确定蓝图覆盖范围
type: grilling
status: closed
parent: ../map.md
blocked_by: []
claimed_by: user_and_codex
---

## Question

项目蓝图是否只重点展开 STM32 软件架构，还是对机械、电气、传感通信、控制、安全和软件进行同等深度的系统架构拆分？

## Resolution

采用完整系统蓝图。机械、驱动与供电、传感与通信、嵌入式软件、控制行为和安全关系需要同等深度拆分；软件不是唯一重点，机械和电气也不能只作为外部边界一笔带过。
