46564645/Surgery_exoskeleton/Open-source projects/开源项目借鉴索引表.md

# 开源项目借鉴索引表

## 使用边界

> 本表是项目自有的借鉴索引，不是第三方实现保证。当前规则以[系统架构蓝图](../Main_%20project/docs/system_architecture_blueprint.md)为准，尤其是5.7至5.11节的输出类型、动作暂停、故障恢复与参考差异。参考源码保持只读；所有改写量仅为粗略估计，不代表已完成复用或验证。

- 当前硬件边界：STM32F446RE；SHOULDER_SIDE 为 GIM6010-8 + GDS68；ELBOW 为裸 M3508 + C620。不得套用 P19 减速总成的数据或实现。
- 当前感知边界：暂不使用 IMU；肩、肘状态以电机编码器为主。M3508 编码器仅在当前 1:1、无滑移假设下暂作肘关节角度来源。
- 当前功能边界（2026-10-16）：以省力和自由跟随为主，连续重力补偿为基础；动作放大为可选后续扩展，根据编码器方向和速度介入。Lock通电位置保持已取消，不移植，也不作为其他功能前置；动作取消/停止、状态保护和遥测仍保留。力传感器 + HX711 只作辅助监测，不作为主要助力触发。
- “直接使用”指库、生成代码、工具或已经确定的功能语义可原样采用；“需要修改”指预计改写量不超过 55%；“自己编写”指项目代码仍需自行完成 55% 以上，但所列项目能减少分析、设计或局部实现工作。
- 每行最多列两个主参考。标成“思路借鉴”的项目不计入主参考，也不表示复制其源码。“拿走使用部分”无法确认时留空。
- 改写量是相对该模块最终项目代码的初步估计，不是对整个仓库的修改比例；硬件协议、控制参数和安全阈值仍须以实物资料和后续验证为准。

## 索引表

| 模块 | 借鉴项目 | 拿走使用部分 | 判断 | 改写量 | 继承 ExoKit 的东西 |
|---|---|---|---|---:|---|
| 1. 系统对象与功能术语 | 主参考：[ExoKit](https://github.com/HCI-Lab-Saarland/ExoKit) | “关节、手臂、动作、条件、反应”的对象划分，以及动作开始、运行、取消、结束后恢复的语义 | 直接使用（概念与命名） | 0-10% | 直接保留 ExoKit 的 `joint / arm / action / condition / reaction` 心智模型；不直接复制其 Arduino/Dynamixel 实现 |
| 2. 可选助力与取消命令名称 | 主参考：[ExoKit](https://github.com/HCI-Lab-Saarland/ExoKit) | `jointamplify`、`cancel` 的名称及用户可见行为；不采用 `jointlock` | 直接使用（适用的命令语义） | 0-10% | 保留适用的外部操作语言；Amplify未实现，不将参考命令名称写成当前固件已支持 |
| 3. STM32F446 工程底座 | 主参考：[STM32CubeF4](https://github.com/STMicroelectronics/STM32CubeF4)、[LEAP upper limb](https://github.com/ziteh/LEAP-upper-limb) | F4 HAL/CMSIS、CubeMX 生成工程组织和 F446 外设初始化范例 | 需要修改 | 25-40% | 作为 ExoKit 功能层的新执行底座；ExoKit 的 Arduino 初始化层不继承 |
| 4. 主循环与任务调度 | 主参考：[STM32CubeF4](https://github.com/STMicroelectronics/STM32CubeF4)、[FreeRTOS-Kernel](https://github.com/FreeRTOS/FreeRTOS-Kernel) | HAL 时基、裸机周期任务范例；若后续选 RTOS，可直接使用 FreeRTOS Kernel | 路线待选；需要修改 | 裸机 30-45%；RTOS 25-40% | 保留 ExoKit 对周期条件检查、反应更新和通信处理的职责划分，重写其 TaskManager 调度 |
| 5. CAN 底层与报文分发 | 主参考：[BetaRobot](https://github.com/itgz123/BetaRobot)、[STM32CubeF4](https://github.com/STMicroelectronics/STM32CubeF4) | `bsp_bxcan`/`hal_can` 的分层方式、F4 HAL CAN 收发和过滤器范例 | 需要修改 | 30-45% | 为 ExoKit 的 Joint 调用提供与具体电机解耦的通信底座 |
| 6. 串口 DMA 与环形缓冲 | 主参考：[stm32-usart-uart-dma-rx-tx](https://github.com/MaJerle/stm32-usart-uart-dma-rx-tx)、[LwRB](https://github.com/MaJerle/lwrb) | F4 UART 空闲线/DMA 接收范例和 `lwrb` 环形缓冲库 | 直接使用库，修改集成层 | 20-35% | 承接 ExoKit 文本命令入口和状态输出；不继承其 Arduino Serial 层 |
| 7. 统一关节执行器接口 | 主参考：[BetaRobot](https://github.com/itgz123/BetaRobot)、[ExoKit](https://github.com/HCI-Lab-Saarland/ExoKit) | BetaRobot 的 `drv_motor_base` 接口分层；ExoKit 的 Joint 对上层隐藏电机差异的职责 | 需要修改 | 35-50% | 形成 STM32 版 Joint 接口，让动作层仍只面对关节状态、使能和命令 |
| 8. GIM6010-8 驱动适配 | 主参考：[Rhino-Pi-X1-ROS2HomeRobots](https://github.com/Coderyne/Rhino-Pi-X1-ROS2HomeRobots)、[BetaRobot](https://github.com/itgz123/BetaRobot) | `gim6010_drv.c/.h` 的报文封装与反馈解析骨架、BetaRobot 的 bxCAN 适配层 | 需要修改 | 40-50% | 作为 SHOULDER_SIDE Joint 的硬件适配器；保留 ExoKit Joint 行为，不继承 Dynamixel 驱动。项目中的 `ffTorque * 8` 等设备特定处理不得直接照搬 |
| 9. M3508 + C620 驱动适配 | 主参考：[BetaRobot](https://github.com/itgz123/BetaRobot)、[UICRM-Embedded](https://github.com/UIC-RoboMaster/UICRM-Embedded) | DJI 电机反馈解析、组帧发送、`DjiMotorBase`/`drv_djimotor_broadcast` 的接口组织 | 需要修改 | 20-35% | 作为 ELBOW Joint 的硬件适配器，继续向 ExoKit 风格的关节层提供统一状态和命令 |
| 10. 编码器状态与多圈累计 | 主参考：[BetaRobot](https://github.com/itgz123/BetaRobot)、[Rhino-Pi-X1-ROS2HomeRobots](https://github.com/Coderyne/Rhino-Pi-X1-ROS2HomeRobots) | DJI 编码器反馈状态组织、GIM 位置/速度反馈解析结构 | 需要修改 | 30-45% | 替代 ExoKit 的独立编码器对象，但继续向 Condition 和 Reaction 提供角度、速度和方向 |
| 11. 关节角度统一换算 | 主参考：[BetaRobot](https://github.com/itgz123/BetaRobot)、[ExoKit](https://github.com/HCI-Lab-Saarland/ExoKit) | 电机原始反馈到统一关节状态的数据层结构 | 需要修改 | 35-50% | 保留 ExoKit 的关节方向、零位和可读状态概念；具体符号、零偏和范围由本项目标定 |
| 12. M3508 外环控制 | 主参考：[BetaRobot](https://github.com/itgz123/BetaRobot)、[CMSIS-DSP](https://github.com/ARM-software/CMSIS-DSP) | BetaRobot 的电机/PID 组织和 CMSIS-DSP 基础数学、滤波函数 | 需要修改 | 25-40% | 把 ExoKit Reaction 给出的关节级目标转换为 ELBOW 可执行命令；参数不从参考项目照搬 |
| 13. HX711 与力传感器采集 | 主参考：[STM32-Libraries](https://github.com/DanielMartensson/STM32-Libraries)；思路借鉴：[Auxivo EduExo Maker](https://github.com/auxivo/edu_exo_maker)、IROS 2024 Force-Triggered Controller（`F0(q)` 线性回归 + 短促力触发） | `HX711.c/.h` 的 GPIO 时序、原始值读取和去皮/比例换算接口；ExoKit `ForceCondition` 的阈值条件结构 | 需要修改 | 20-35% | 默认仍只作监测；可选"力触发有界增量"（`App/control/force_assist.c`，默认关闭、需校准 `F0(q)`）。力只触发增量、不参与故障判断，过期即撤；传感器须位于绑带-手臂界面。保持10SPS（未改RATE），触发延迟约100–200ms |
| 14. 参数持久化 | 主参考：[STM32 EEPROM Emulation](https://github.com/STMicroelectronics/stm32-util-eeprom-emulation)、[STM32CubeF4](https://github.com/STMicroelectronics/STM32CubeF4) | EEPROM 仿真核心、Flash 接口模板和 F4 Flash 使用范例 | 需要修改 | 20-35% | 保存 ExoKit 风格的关节配置、助力参数和动作配置；不保存未经确认的默认阈值 |
| 15. 编码器零位标定流程 | 主参考：[OpenExo](https://github.com/naubiomech/OpenExo)、[StateSmith](https://github.com/StateSmith/StateSmith) |  | 自己编写（开源辅助） | 55-70% | 标定结果进入 ExoKit Joint 配置；标定本身是本项目新增的 STM32 状态流程 |
| 16. 启动参数检查 | 主参考：[StateSmith](https://github.com/StateSmith/StateSmith)、[STM32 EEPROM Emulation](https://github.com/STMicroelectronics/stm32-util-eeprom-emulation) |  | 自己编写（开源辅助） | 55-65% | 在 ExoKit 动作系统可运行前增加配置完整性检查，不改变其动作语义 |
| 17. 重力模型离线推导 | 主参考：[SymPy](https://github.com/sympy/sympy)、[SymPyBotics](https://github.com/cdsousa/SymPyBotics)；思路借鉴：[GALAXEA-A1Z](https://github.com/userguide-galaxea/GALAXEA-A1Z) | SymPy 符号表达式化简和代码生成；SymPyBotics 的机器人动力学符号推导方式 | 自己编写（工具直接用） | 45-55% | 为 ExoKit Joint/Arm 补充其原项目没有的重力前馈来源；生成结果需改为本项目双关节模型 |
| 18. 连续重力补偿 | 主参考：[GALAXEA-A1Z](https://github.com/userguide-galaxea/GALAXEA-A1Z)、[SymPy](https://github.com/sympy/sympy) | `GravityModel`、编码器关节状态到重力转矩再到逐关节限幅的控制流程；离线生成公式的工具链 | 自己编写（开源辅助） | 55-70% | 作为健康且有许可时的基础助力层，故障或许可撤销时不继续输出；不能直接搬用 GALAXEA 的 Python/Pinocchio 和六轴模型 |
| 19. 动作意图判断 | 主参考：[ExoKit](https://github.com/HCI-Lab-Saarland/ExoKit)、[CMSIS-DSP](https://github.com/ARM-software/CMSIS-DSP) | `AmplifyReaction` 的方向、起始速度、有效最大速度、反向暂停和低速处理；其 finishCondition 返回 false；必要的基础滤波函数 | 需要修改 | 30-45% | 保留运动条件判断；停止或反向时暂时退出助推，不等于取消 Amplify；正常暂停只撤增量，保留获许可的重力基线；编码器运动不等于已确认用户主动意图，不引入 IMU |
| 20. 动作放大式顺势助力（可选扩展） | 主参考：[ExoKit](https://github.com/HCI-Lab-Saarland/ExoKit)；思路借鉴：[GALAXEA-A1Z](https://github.com/userguide-galaxea/GALAXEA-A1Z) | `AmplifyReaction` 的参数与运行生命周期 | 自己编写（开源辅助） | 55-70% | 若实现，保留 `jointamplify` 及其 Reaction 语义；输出改成叠加在连续重力补偿上的增量助力，不能照搬 Dynamixel 电流控制代码；不依赖Lock，不阻塞当前省力演示 |
| 21. 助力命令合成 | 主参考：[GALAXEA-A1Z](https://github.com/userguide-galaxea/GALAXEA-A1Z)、[ExoKit](https://github.com/HCI-Lab-Saarland/ExoKit) | 动力学前馈与附加力矩合成和限幅；位置、速度、kp、kd与前馈力矩分字段发送 | 自己编写（开源辅助） | 65-80% | 把带类型的 Reaction 请求与重力基线协调；只相加同单位力矩，不把位置与电流相加；控制环在 STM32 或驱动器内仍为 TBD |
| 22. 双关节动作协调 | 主参考：[ExoKit](https://github.com/HCI-Lab-Saarland/ExoKit)、[StateSmith](https://github.com/StateSmith/StateSmith) | ExoKit Arm 级动作组合及并行动作的职责划分 | 自己编写（开源辅助） | 60-75% | 继承 Arm 对多个 Joint 的统一编排，但按 SHOULDER_SIDE/ELBOW 异构执行器重写同步、结束和取消逻辑 |
| 23. 通电保持（已取消，保留编号追溯） | 历史参考：[ExoKit](https://github.com/HCI-Lab-Saarland/ExoKit)、[GALAXEA-A1Z](https://github.com/userguide-galaxea/GALAXEA-A1Z) | 原 `JointLockReaction` 的进入时记录当前位置、运行时保持、退出时恢复语义，仅留作历史资料 | 不采用（用户2026-10-16取消） | 不适用 | 不实现 `jointlock`，不作为FOLLOW、Amplify或演示的前置；来源链接及第三方源码保留 |
| 24. 模式平滑切换 | 主参考：[GALAXEA-A1Z](https://github.com/userguide-galaxea/GALAXEA-A1Z)、[CMSIS-DSP](https://github.com/ARM-software/CMSIS-DSP) |  | 自己编写（开源辅助） | 55-70% | 服务于FOLLOW启停、姿态变化及可选Reaction的进入、退出和取消，减少助力突变与对手动移动的对抗 |
| 25. 角度、速度与输出限制 | 主参考：[BetaRobot](https://github.com/itgz123/BetaRobot)、[GALAXEA-A1Z](https://github.com/userguide-galaxea/GALAXEA-A1Z) | 电机命令限幅的分层位置；GALAXEA 的关节范围、速度和转矩逐级检查结构 | 需要修改 | 30-50% | 在 ExoKit Condition/Reaction 外增加不可绕过的关节级约束；具体阈值留待硬件确认 |
| 26. 系统状态机 | 主参考：[StateSmith](https://github.com/StateSmith/StateSmith)、[ExoKit](https://github.com/HCI-Lab-Saarland/ExoKit) | StateSmith 的状态图生成 C/C++ 流程；ExoKit 动作生命周期 | 需要修改 | 25-40% | 按蓝图使用 `STARTUP_CHECK`、`CALIBRATION`、`SAFE_OFF`、`FOLLOW`、`FAULT`；若实现Amplify再使用 `ASSIST` 并另记当前是否助推；不增加 `LOCK`，这是本项目规则，不是ExoKit已有状态机 |
| 27. 动作管理器 | 主参考：[ExoKit](https://github.com/HCI-Lab-Saarland/ExoKit)、[StateSmith](https://github.com/StateSmith/StateSmith) | `IReaction`、Event、`CmdReactionRunner` 的开始/循环/取消/清理职责 | 需要修改 | 40-50% | 保留新动作取消旧动作、取消后清理的语义；普通取消仅在健康且有许可时返回基线，故障清理不得恢复旧输出；重写内存和调度实现 |
| 28. 安全监督与故障管理 | 主参考：[BetaRobot](https://github.com/itgz123/BetaRobot)、[StateSmith](https://github.com/StateSmith/StateSmith)；思路借鉴：[GALAXEA-A1Z](https://github.com/userguide-galaxea/GALAXEA-A1Z) |  | 自己编写（开源辅助） | 60-75% | ExoKit动作层只提交候选；本项目新增唯一最终输出入口和安全否决，严重故障撤销两个关节许可；软件撤销不等于电机已停；正常开机与故障恢复分开，故障复位后必须重新确认出力 |
| 29. 看门狗与周期健康监测 | 主参考：[STM32CubeF4](https://github.com/STMicroelectronics/STM32CubeF4)、[BetaRobot](https://github.com/itgz123/BetaRobot) | F4 IWDG 范例、BetaRobot `drv_daemon` 的在线/超时监测组织 | 需要修改 | 20-35% | 对周期动作和通信增加存活约束，不由Reaction自行喂狗；超时回调不能保证程序卡死或CAN断线后电机已停，驱动行为与台架独立停止手段须另行验证 |
| 30. 固定文本命令解析 | 主参考：[CLIP](https://github.com/marcinbor85/clip)、[ExoKit](https://github.com/HCI-Lab-Saarland/ExoKit) | CLIP 的嵌入式命令注册/参数解析；ExoKit 的命令名称、目标关节和动作参数定义 | 需要修改 | 15-30% | 保留 ExoKit 命令层，对解析器和串口实现做 STM32 化；不复制 Arduino 正则和动态分配方式 |
| 31. 遥测与调试界面 | 主参考：[Serial Studio](https://github.com/Serial-Studio/Serial-Studio)、[ExoKit](https://github.com/HCI-Lab-Saarland/ExoKit) | Serial Studio 作为独立上位机显示状态、曲线和终端；ExoKit Processing GUI 的命令分组与参数布局 | 直接使用上位机；修改数据映射 | 5-20%（只监看）；40-50%（含控制） | 界面继续使用 ExoKit 的 Joint/Arm/Action 语言；Serial Studio 与固件分开运行，不把其 GPL 代码并入固件 |
| 32. 算法单元验证 | 主参考：[Unity](https://github.com/ThrowTheSwitch/Unity)、[Ceedling](https://github.com/ThrowTheSwitch/Ceedling) | Unity 断言框架、Ceedling 构建与 mock 流程 | 需要修改 | 40-50% | 验证 ExoKit 风格 Condition/Reaction 生命周期、换算、合成和限幅 |
| 33. MuJoCo 仿真省力验证与软件在环（2026-10-26新增，未实现） | 主参考：[MuJoCo](https://github.com/google-deepmind/mujoco)、[myo_sim](https://github.com/MyoHub/myo_sim)；思路借鉴：[MyoAssist/assist_sim](https://github.com/neumovelab/myoassist)、[rehyb_mujoco](https://github.com/stesfazgi/rehyb_mujoco) | MuJoCo Python 绑定、关节执行器、`weld/connect` 绑带约束、`mj_inverse`；myo_sim `legacy/elbow/myoelbow_1dof6muscles_1dofexo.xml` 的外骨骼支撑件与理想助力执行器写法；MyoSuite/RoboHive `myoarm_relocate.xml` 的桌子场景写法 | 引擎直接使用；人臂+外骨骼模型自己编写（开源辅助） | 55-70% | 不涉及 ExoKit 实物层；被测对象是本项目 `App/control` 原代码（编成主机 DLL），仿真不替代必要台架窗口。计划见 schedule 1.2 节；固定 `mujoco==3.16.0`；本地参考库暂无这些仓库 |

## 五项架构规则的源码导航

具体文件链接、函数名、可借鉴部分及必须改写的边界统一维护在[蓝图5.12实现索引](../Main_%20project/docs/system_architecture_blueprint.md#implementation-reference)，本表不复制第二套源码说明。

| 本表模块 | 实现时查阅 | 重点 |
|---|---|---|
| 1、2、27 动作对象、命令与管理器 | [REF-EXO-01](../Main_%20project/docs/system_architecture_blueprint.md#ref-exo-01)、[REF-EXO-02](../Main_%20project/docs/system_architecture_blueprint.md#ref-exo-02)、[REF-EXO-03](../Main_%20project/docs/system_architecture_blueprint.md#ref-exo-03) | 新动作取消旧动作；生命周期不能直接取得电机输出权限 |
| 19、20 助推条件与Amplify | [REF-EXO-04](../Main_%20project/docs/system_architecture_blueprint.md#ref-exo-04)、[REF-EXO-05](../Main_%20project/docs/system_architecture_blueprint.md#ref-exo-05) | 暂停不等于取消；不继承未经确认的默认速度和电流比例 |
| 18、21 重力与合成 | [REF-GAL-01](../Main_%20project/docs/system_architecture_blueprint.md#ref-gal-01)、[REF-GAL-02](../Main_%20project/docs/system_architecture_blueprint.md#ref-gal-02) | 核对姿态相关补偿、逐轴单位和输出限制；第23行已取消，[REF-EXO-06](../Main_%20project/docs/system_architecture_blueprint.md#ref-exo-06)仅供历史追溯 |
| 8、9、12 驱动适配与外环 | [REF-BETA-02](../Main_%20project/docs/system_architecture_blueprint.md#ref-beta-02)、[REF-GIM-01](../Main_%20project/docs/system_architecture_blueprint.md#ref-gim-01) | 核对裸M3508/C620与GDS68能力、单位和换算；计算与发送权限分开 |
| 25、28、29 限制、故障与超时 | [REF-EXO-07](../Main_%20project/docs/system_architecture_blueprint.md#ref-exo-07)、[REF-BETA-01](../Main_%20project/docs/system_architecture_blueprint.md#ref-beta-01)、[REF-GAL-01](../Main_%20project/docs/system_architecture_blueprint.md#ref-gal-01) | 软件撤销不等于硬件停止；统一入口与台架停止保障须由本项目补齐 |
| 15、16、26 标定、启动与系统状态 | [REF-EXO-08](../Main_%20project/docs/system_architecture_blueprint.md#ref-exo-08)及蓝图5.9 | 只借鉴先关闭输出的顺序；故障复位重新确认没有可直接套用的完整实现 |

## 本地仓库状态

本表所列开源项目均已放入当前文件夹。此前已有：`ExoKit-main`、`LEAP-upper-limb-main`、`OpenExo`、`UICRM-Embedded`、`Auxivo_EduExo_Maker`、`elbow_exoskeleton-main`。

本次新增浅克隆：`BetaRobot`、`Rhino-Pi-X1-ROS2HomeRobots`、`STM32CubeF4`、`FreeRTOS-Kernel`、`lwrb`、`stm32-usart-uart-dma-rx-tx`、`stm32-util-eeprom-emulation`、`CMSIS-DSP`、`GALAXEA-A1Z`、`sympy`、`SymPyBotics`、`StateSmith`、`clip`、`Serial-Studio`、`Unity`、`Ceedling`、`STM32-Libraries`。

## 许可证提醒

-许可证无所谓，因为是学生项目只是个人使用，不会涉及问题，但适用项目需要自己判断。
