46564645/Surgery_exoskeleton/Open-source projects/OPEN_SOURCE_PROJECTS_RULES.md

# 上肢外骨骼查找开源项目本地rules
## 本目录的定位

本地文件夹中没有某个模块时，不能直接得出“没有现成项目、需要自己从零写”的结论，必须继续进行联网检索。

本项目属于学生个人原型和学习娱乐用途，现阶段许可证不作为是否下载、研究和原型复用的筛选条件。表格仍保留来源和许可证记录，主要用于以后追溯项目出处。

## 使用规则

每个软件或硬件模块开始设计、写代码之前，必须按以下顺序检查现有成果：

1. 先检查 ExoKit 主参考项目中是否已有可直接借鉴的结构、接口或逻辑。
2. 再检查本地这个文件夹中的参考项目，但必须记住它们只是部分参考。
3. 本地找不到或现有项目不匹配时，必须继续到 GitHub、Gitee、GitCode、AtomGit、GitLink 等开源网站检索，不允许直接从零编写。
4. 搜索到候选项目后，按“可直接使用 > 部分可以使用 > 仅借鉴思路”的顺序评估；预计修改量小于 40%时优先直接适配。
5. 如果只能复用部分代码，应明确保留哪些部分、修改哪些部分，并记录项目来源。详细规则见技术文档中的 AI 编写原则和开源项目原则。
6. 如果网上仍然找不到合适项目，必须先用最直白的话告诉用户“这一部分没有找到可直接使用的开源实现”，讨论确认后才能自行设计或由 AI 从零编写。
7. 本项目为学生个人原型和学习娱乐用途，许可证不作为现阶段的筛选条件。

## 网上开源项目检索入口

| 平台 | 链接 | 主要用途 |
|---|---|---|
| GitHub | https://github.com/search | 第一检索入口，优先查英文型号、芯片名、控制器名和完整项目 |
| Gitee（码云） | https://gitee.com/ | 中文代码托管平台，适合检索 STM32、机器人、电机驱动和国内硬件示例 |
| GitCode | https://gitcode.com/ | 中文开源项目与代码托管平台，可补充检索国内项目和镜像 |
| AtomGit | https://atomgit.com/ | 国内开源代码托管与协作平台，可检索嵌入式和机器人项目 |
| GitLink（确实开源） | https://www.gitlink.org.cn/ | 中文开源社区和项目托管平台 |
| OSCHINA 开源项目 | https://www.oschina.net/project | 中文开源项目分类与发现入口 |
| GitLab Explore | https://gitlab.com/explore | GitHub 以外的国际开源仓库补充入口 |

实际检索不能只搜索一次。至少要组合中英文关键词，例如 `GIM6010 STM32 CAN`、`M3508 C620 STM32 HAL`、`WT901C TTL STM32`、`HX711 STM32 non-blocking`、`upper limb exoskeleton open source` 和“上肢外骨骼 STM32”。

## 当前结论

当前本地库只是部分参考。每个模块都应按“ExoKit 底版 -> 本地参考库 -> 网上开源平台检索 -> 官方资料核对 -> 直接或部分适配”的顺序推进。只有完成联网检索后仍找不到合适实现，才能向用户报告并讨论是否由 AI 从零编写。
