46564645/Surgery_exoskeleton/firmware/Exoskeleton_F446/docs/s3_output_preparation.md

# S3 输出软件接口与启用边界

这是已批准S2→S3方案的源码与启用边界说明，唯一进度日志在[开发排期](../../../Main_%20project/docs/development_schedule.md)。S2当前批准的可信连续肩反馈和一次真实变化已通过；2026-10-04一次受监督肩微动已实际prepare、闭环使能、arm/pulse并完成停止。不能继续以旧失败窗口的“从未使能”描述当前状态。

本次100ms/20mNm请求获接受，零目标/模式及新鲜闭环心跳符合门控；TTL撤权后驱动IDLE、250ms停稳观察通过，终态FAULT/EXPIRED且output/request/token0，原点UNSET→ACTIVE→RETIRED，锁存ACTIVE后至RETIRED身份不变。方向/零位、精确动态、肘部运动及其余S3现场项目未全部验收，因此S3仍为部分完成。实物掉线/恢复仅从本轮S2取消，未执行，不写通过。

当前已刷镜像为HSE相对台架ELF762c0902a4269f3056c32e75b2cb99039d9a45f22678aac41364c111500bcf54（BIN91148B）；2026-10-04只复位一次，未再次刷写。主仓默认site禁用/HSI仍保留，镜像差异见验收记录；以下较早上板、未动作描述保留历史时点。原始[本次记录](bench/s3-capture/evidence-relative-20261004T013713353068Z/summary.json)与[S2变化判定](s2_encoder_stream.md#当前验收证据2026-10-04)记录了全部实际边界；目标转矩受理不证明实际达到20mNm。本轮归档并提交至原GitHub仓库，远端结果以对应Git提交记录为准。

## 实现与实际可达性

| 层/文件 | 当前行为 |
|---|---|
| L1 `board_can_tx.c/.h` | 按显式轴集合有界发送、旧邮箱abort及空闲确认；停用总线不校验帧、不执行HAL或TX。旧API以集合3兼容；无软件队列、不加TX中断，默认未绑定。 |
| L2 `motor_command.c/.h` | C620 分组发送编码，未选择槽清零；GDS rev2.2 SIMPLE 的 Set_Input_Torque/IDLE、力矩输入模式和闭环状态准备帧编码；纯函数不发送。 |
| L3 `joint_state.c/.h` | 连续转子量按已确认映射转换；拒绝未知配置、非有限值和冒充连续量的模角。C620裸轴的单圈扇区由L4独立处理，不称连续量或装配关节坐标。 |
| L3 `safety_supervisor.c/.h` | 只检查启用轴各自的反馈/协议、映射、限制及反馈新鲜度；停用轴的未知映射/状态不阻断。公共保护、停止、UART与服务时序仍参与门控；任一启用关键链异常撤销全部启用轴许可。 |
| L4 `output_gateway.c/.h` | 唯一提交点，按GDS/C620各自证据Prepare→READY→人工Arm→静态单轴请求；限幅、斜率、寿命、替换/取消、故障锁存及撤销旧待发帧；无动态对象。 |
| L4 `output_can_transport.c/.h` | 传递启用轴集合至L1；只触碰启用总线。生产仅在该集合配置与可信来源就绪时绑定，当前默认条件不满足。 |
| L4 `s3_bench.c/.h` | 从s3_site集中读取启用集合与确认项；接入启用CAN总线、公共UART/服务周期健康和人工命令。默认集合0、transport为空，SAFE_OFF无输出。 |
| L4 `s3_feedback.c/.h`、`s3_site.c/.h` | 从CanMonitor读取逐帧GDS档案观测和C620真实反馈，分别保留位置/心跳时间戳与driver[2]状态。WireValid不授予许可；裸C620反馈静止观察已提供，外部停止及GDS校准/零目标/模式来源仍未提供。 |

无参数只读命令 `outputstatus` 仍保留。以下默认禁用状态在2026-10-02 13:30 USB-only及13:46带电只读窗口均已观察；不代表后续停止策略已板测：

```text
OK stage=S2_CAN_RX s3_state=0 reason=1 configured=0 transport_bound=0 output_allowed=0 request_valid=0 stop_attempted=0 prep_state=0 arm_token=0
```

状态编号：0 SAFE_OFF、1 ARMED、2 ACTIVE、3 FAULT、4 PREPARING、5 READY；原因1表示配置未就绪。`prep_state`为0未准备、1等GDS零目标读回或C620零命令后的新反馈、2等GDS模式读回、3等GDS闭环读回、4准备就绪。当前生产 `enabled_axes=0`、确认项false/0、实际发送未绑定；默认prepare/arm在发送前被拒绝。

`enabled_axes`位0肩、位1肘：0禁用、1仅肩、2仅肘、3双轴，非法位拒绝。集合只在冷启动初始化时复制，CLI不能修改。每轴 `feedback_confirmed` / `protocol_confirmed` 取代整机S2完成布尔；整体验收仍如实记录，不靠将布尔置真满足门控。
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
