46564645/Surgery_exoskeleton/firmware/Exoskeleton_F446/docs/bench/live-sessions/live-20261022-005215/figure/figure.png

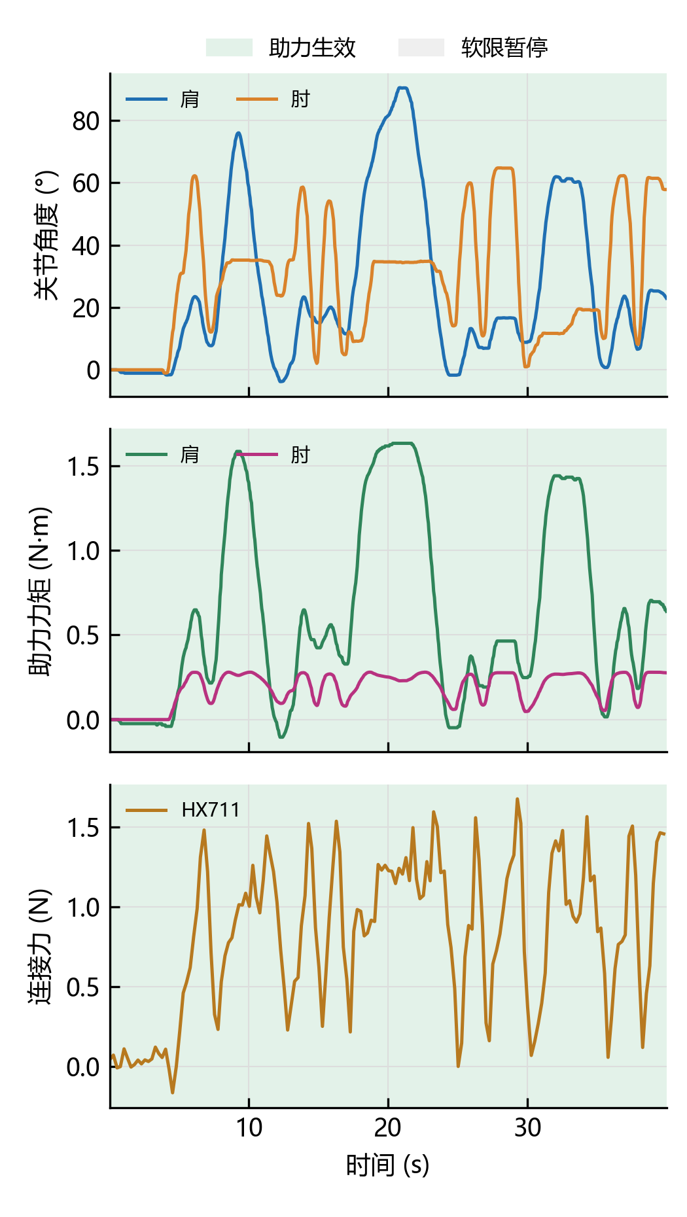
firmware/Exoskeleton_F446/docs/bench/live-sessions/live-20261022-005215/figure/figure.png
