46564645/Surgery_exoskeleton/firmware/Exoskeleton_F446/docs/bench/s3-capture/evidence-direction-after-recovery-20261005T1404074080622Z/motorwizard-user-screenshot.png

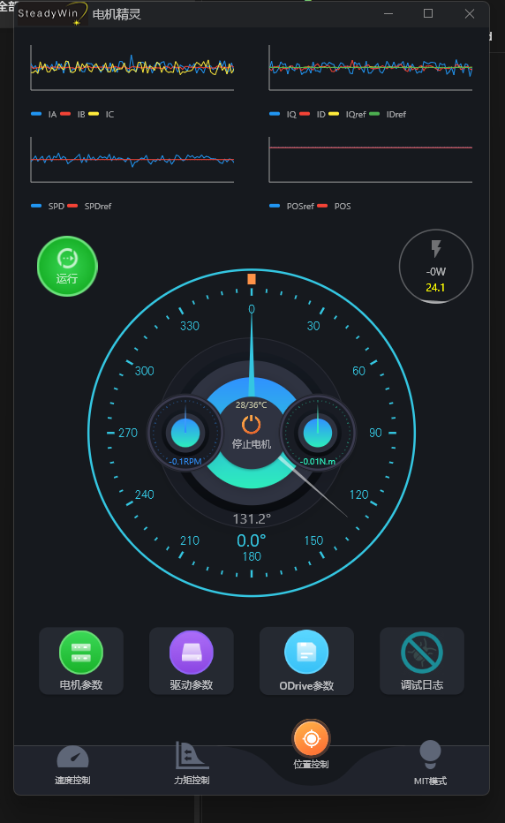
firmware/Exoskeleton_F446/docs/bench/s3-capture/evidence-direction-after-recovery-20261005T1404074080622Z/motorwizard-user-screenshot.png
