46564645/Surgery_exoskeleton/firmware/Exoskeleton_F446/sim/mujoco_arm/docs/figures/01_overview.png

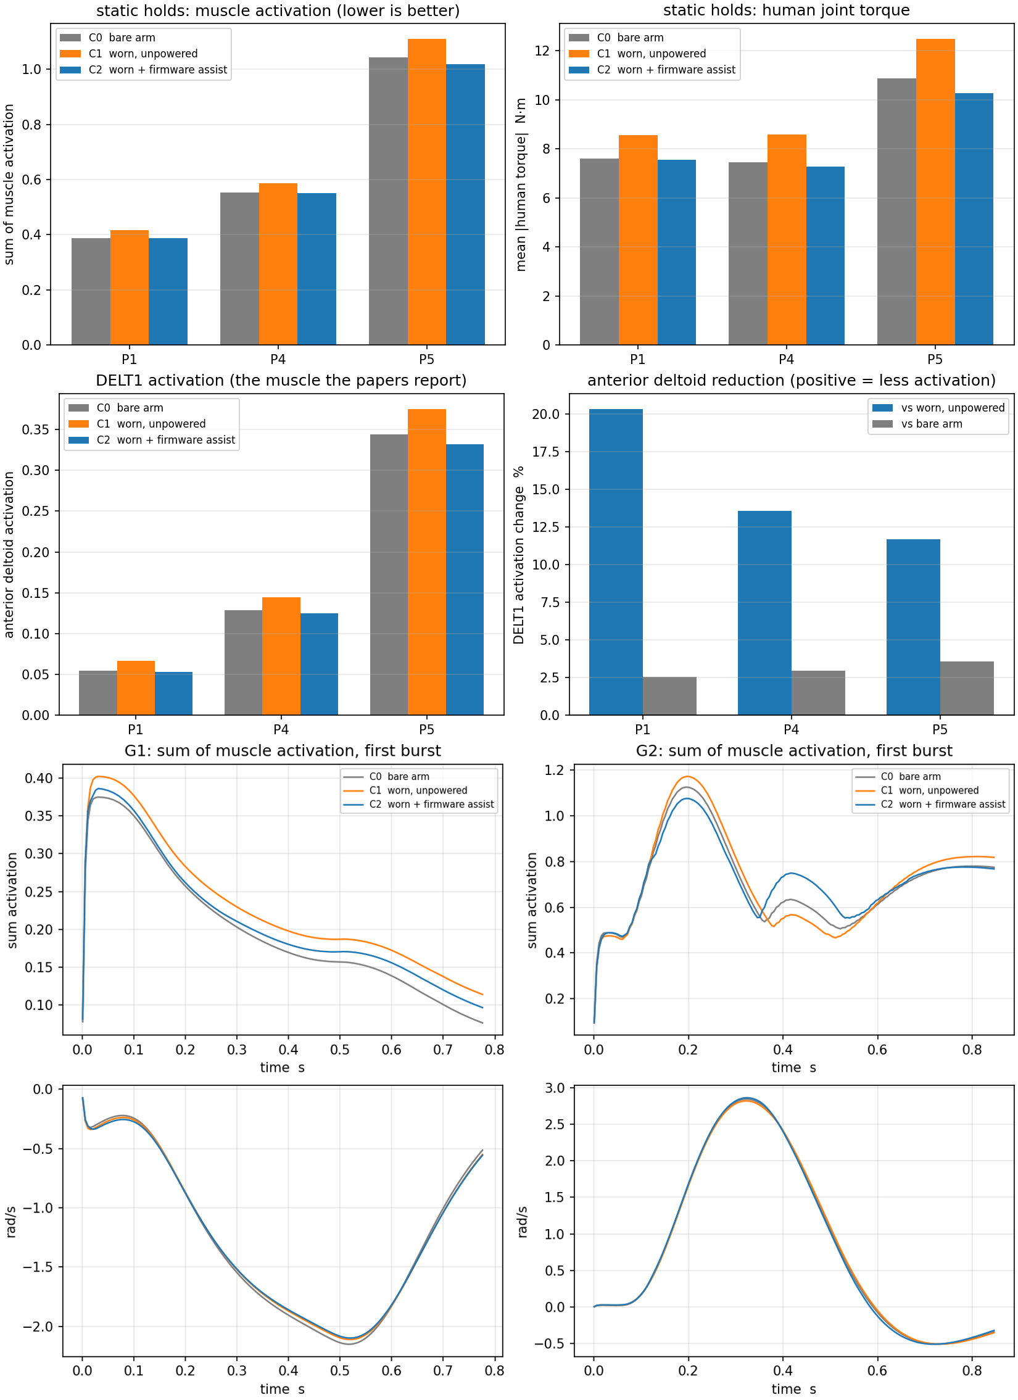
firmware/Exoskeleton_F446/sim/mujoco_arm/docs/figures/01_overview.png
