46564645/Surgery_exoskeleton/firmware/Exoskeleton_F446/sim/mujoco_arm/model/orthoease/docs/cuff_sections.png

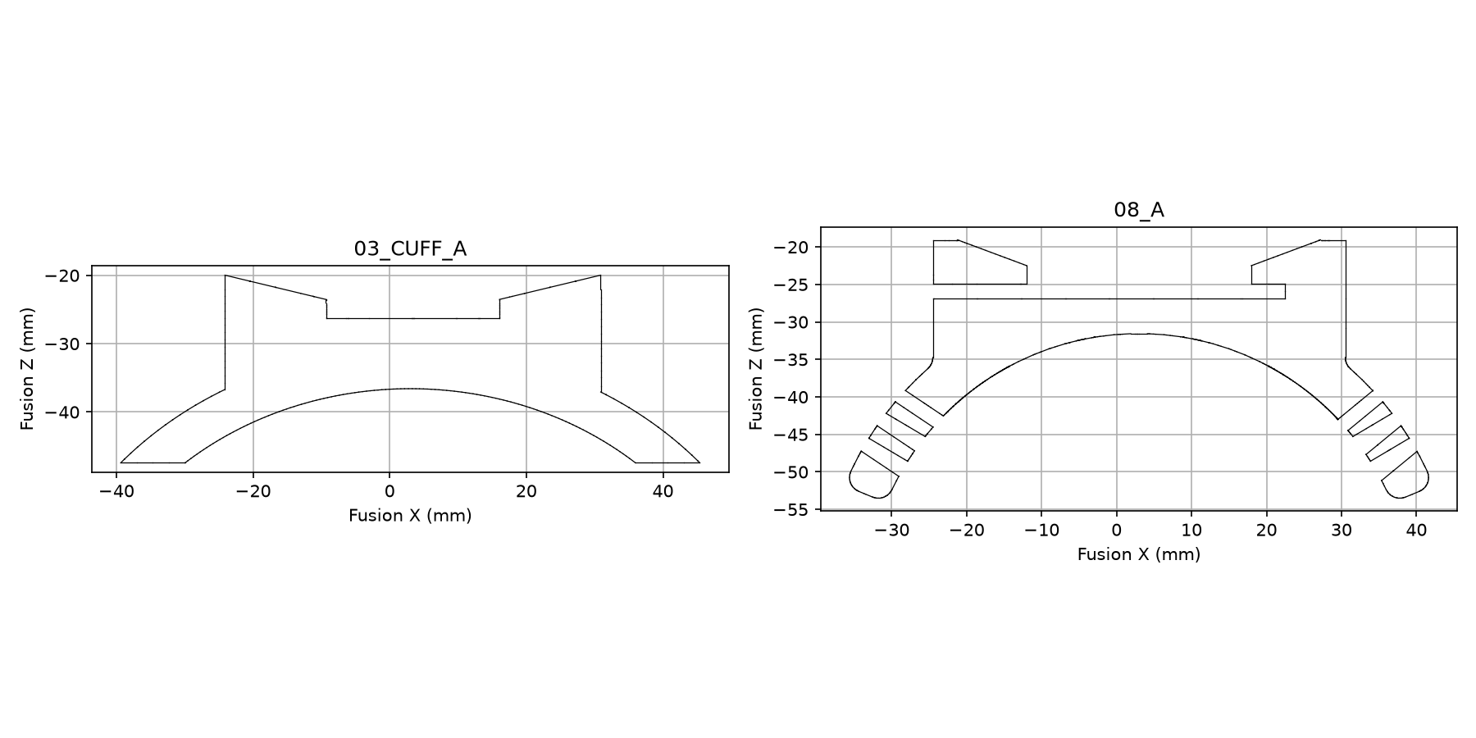
firmware/Exoskeleton_F446/sim/mujoco_arm/model/orthoease/docs/cuff_sections.png
