46564645/Surgery_exoskeleton/Main_ project/docs/exokit_reference_figures/figure_03.png

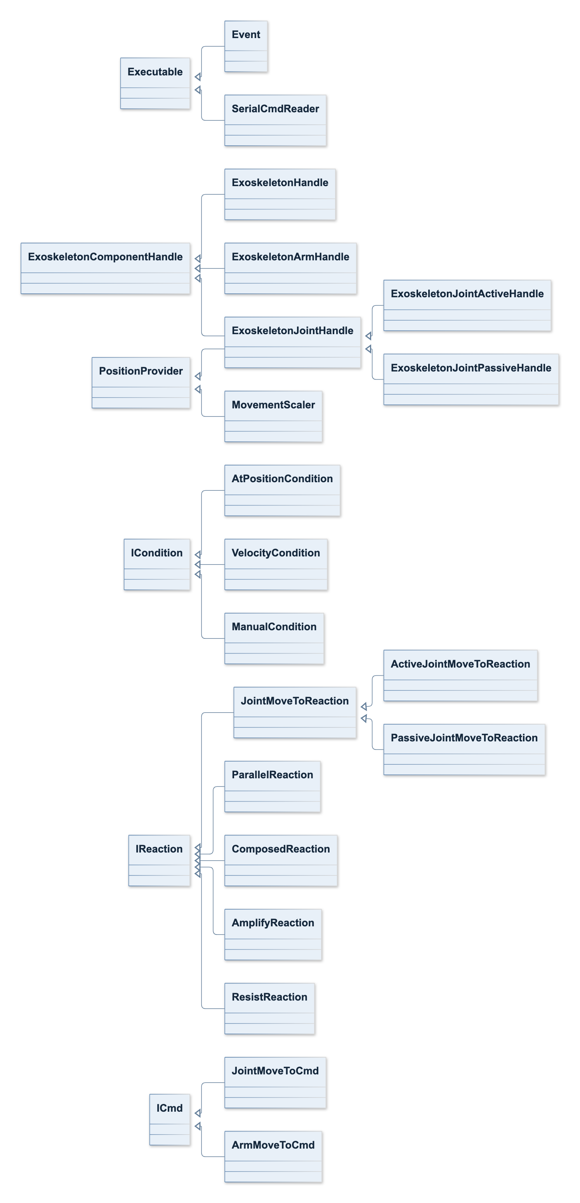
Main_ project/docs/exokit_reference_figures/figure_03.png
