46564645/Surgery_exoskeleton/Main_ project/docs/exokit_reference_figures/figure_05.png

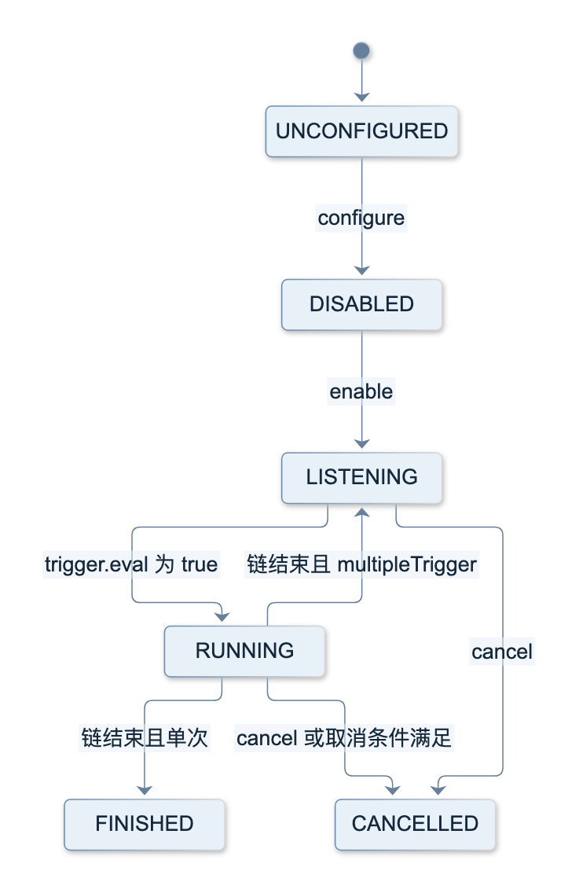
Main_ project/docs/exokit_reference_figures/figure_05.png
