46564645/Surgery_exoskeleton/Main_ project/Hardware_information_list/all_hardware_relevant_documents/S-250-24_power_supply/seller_terminal_reference_S-350-24_2026-09-24.jpg

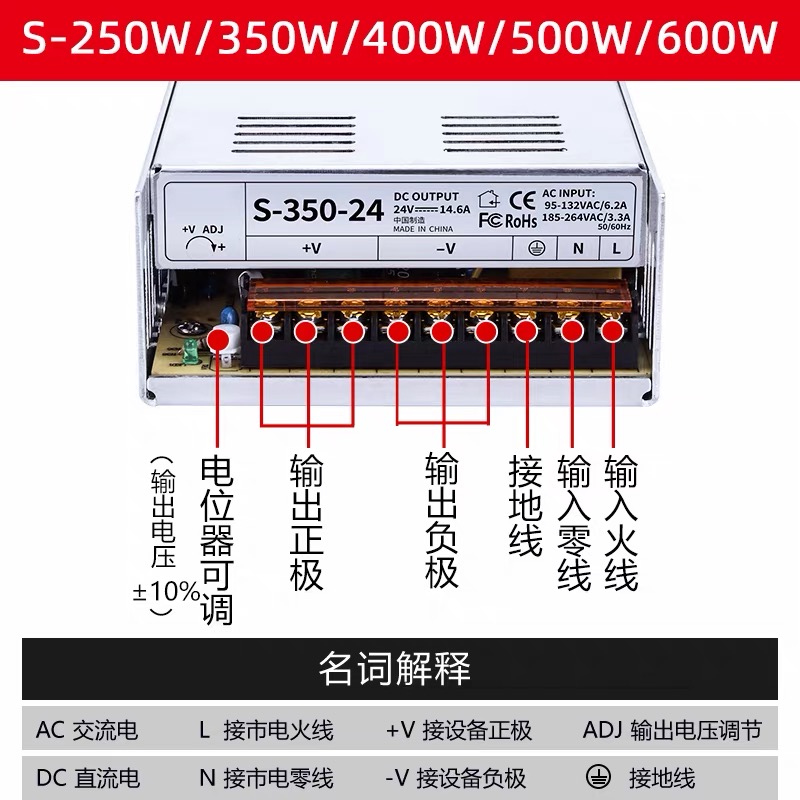
Main_ project/Hardware_information_list/all_hardware_relevant_documents/S-250-24_power_supply/seller_terminal_reference_S-350-24_2026-09-24.jpg
