46564645/Surgery_exoskeleton/Main_ project/Hardware_information_list/all_hardware_relevant_documents/S-250-24_power_supply/user_selected_S-250-24_24V_10A.png

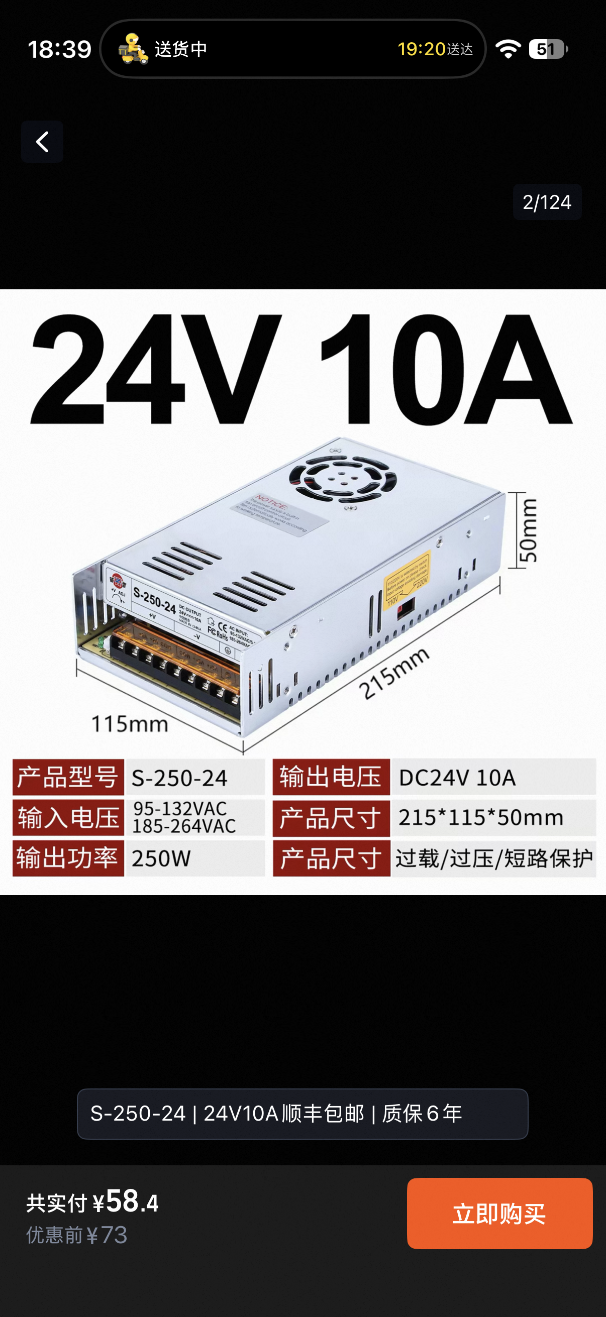
Main_ project/Hardware_information_list/all_hardware_relevant_documents/S-250-24_power_supply/user_selected_S-250-24_24V_10A.png
