46564645/Surgery_exoskeleton/Main_ project/Hardware_information_list/all_hardware_relevant_documents/SN65HVD230_CAN_module/user_provided_product_screenshot.png

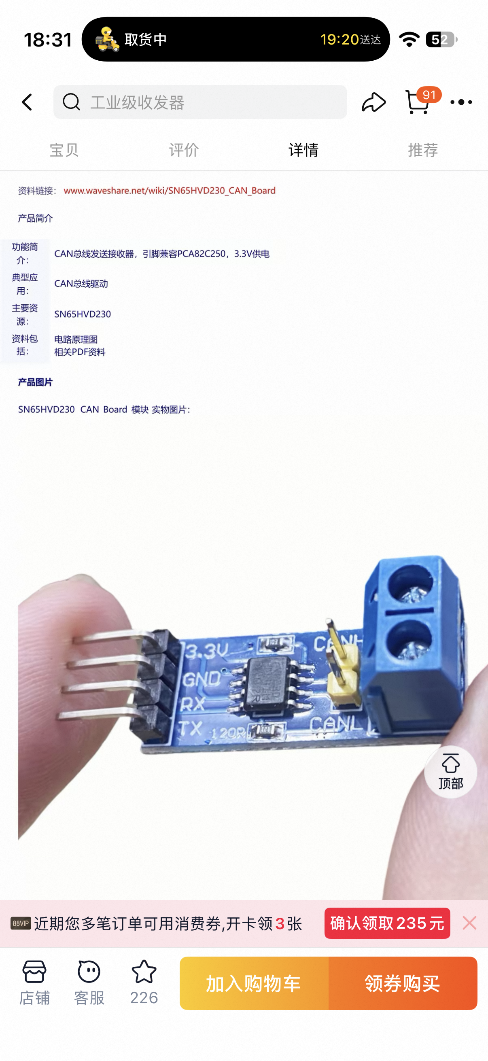
Main_ project/Hardware_information_list/all_hardware_relevant_documents/SN65HVD230_CAN_module/user_provided_product_screenshot.png
