46564645/Surgery_exoskeleton/Main_ project/Hardware_information_list/all_hardware_relevant_documents/GIM6010-8/purchase_evidence/order_configuration.md

# 订单配置摘录

来源：用户2026-09-24提供的订单截图，仅提取产品信息，不记录地址、电话或订单编号。

- 型号：GIM6010-8。
- 选项原文：【旧24v】[电机+减速器];Y-48行星绕组;GDS68(12–48V)；断电记住单圈位置。
- 数量：1。
- “Y-48”不直接等同于已验证的额定电压；“断电记住单圈位置”不能证明已安装输出轴第二编码器。
- GDS68硬件及固件版本未读取。
