46564645/Surgery_exoskeleton/self models/右臂/右臂_发给厂商/打印及采购清单_右臂_副本.txt

ExoKit 右侧单臂 J2 至前臂末端臂箍
三维打印及五金采购清单

序号  中文名称                 本文件夹中的文件名                              打印数量
01    J2 右侧肩侧关节（不打）          01_J2肩侧关节_右臂_打印1个.3mf                 1 个
02    J3 右侧肘关节（不打）            02_J3肘关节_右臂_打印1个.3mf                   1 个
03    关节转子（不打）                 03_关节转子_打印2个.3mf                         2 个
04    上臂刚性连杆             04_上臂刚性连杆_打印2个.3mf                     2 个
05    上臂调节轨               05_上臂调节轨_打印1个.3mf                       1 个
06    上臂臂箍                 06_上臂臂箍_打印2个.3mf                         2 个
07    前臂链节              07_前臂链节_公公型_打印2个.3mf                  2 个
08    前臂链节              08_前臂链节_公母型_打印2个.3mf                  2 个
09    前臂臂箍转接件           09_前臂臂箍转接件_打印1个.3mf                   1 个
10    前臂末端臂箍             10_前臂末端臂箍_打印1个.3mf                     1 个

打印实体合计：15 个。

文件名中的“打印几个”是数量要求。每个三维模型文件只提供一个模型，厂商需要在切片软件中复制到指定数量。

工艺要求

1. 材料：ABS。
2. 填充率：100%。
3. 填充图案：八面体填充。
4. 壁厚：2 毫米。
5. 支撑：普通支撑，悬空和桥接部位按模型需要生成。
6. 尺寸单位：毫米。
7. 不要缩放模型，不要镜像关节件。

四、五金件采购参考（不属于三维打印订单）

1. M5×35 毫米螺丝：8 颗，建议购买 10 颗。
2. M5 防松螺母：8 个，建议购买 10 个。
3. M5 平垫片：16 个，建议购买 20 个。
4. M4×60 毫米螺丝：按四个前臂链节计算共 24 颗，建议购买 28 颗。
5. M4 防松螺母：24 个，建议购买 28 个。
6. M4 平垫片：48 个，建议购买 56 个。
7. 如果 J2 使用大型 XM540 电机：M2.5×16 毫米螺丝 2 颗，建议购买 4 颗。
8. 如果 J3 使用小型 XM430 电机：M2×10 毫米螺丝 2 颗，建议购买 4 颗。
9. 宽度不超过 30 毫米的织物绑带：至少 3 条。
10. 螺纹防松胶：1 瓶。

说明：M4×60 毫米螺丝数量包括两个上臂臂箍、一个前臂臂箍、上臂调节轨和四个前臂链节的连接。若实际减少链节数量，螺丝会有余量。

五、可选轴承

原手册建议使用 MR74-2RS 轴承，尺寸为内径 4 毫米、外径 7 毫米、厚度 2.5 毫米。按本清单的四个链节计算，理论数量为 28 个。

轴承不是首次试装的必需品。由于原手册同时给出了 M5 连杆连接螺丝，与 4 毫米轴承内径存在需要现场核对之处，建议先打印并测量实际孔径，再购买轴承。

六、交货检查

1. 核对实物总数是否为 15 个。
2. 核对 J2 和 J3 均为右臂版本。
3. 检查所有螺丝孔是否完整、无支撑残留。
4. 检查转子、连杆和链节是否存在明显翘曲或层间开裂。
5. 厂商不得用镜像左臂模型替代右臂关节模型。
