46564645/Surgery_exoskeleton/Main_ project/Hardware_information_list/all_hardware_relevant_documents/GIM6010-8/purchase_evidence/SOURCE.md

# 资料来源与边界

## 2026-09-24 补充归档

来源：用户2026-09-24提供的商品详情截图和订单截图。仅归档无订单隐私的参数截图；未复制完整订单截图。第一列GDS68/24V作为旧款暂定参考，尚未实测。

- 文件：[old_24V_product_parameters.png](<old_24V_product_parameters.png>)
  - 原始来源：`/var/folders/12/jbwvkcys6s7539kd4bj7_yhm0000gn/T/codex-clipboard-7486cf2b-3d95-4ffd-b30e-261eabf8e859.png`
  - SHA-256：`a907481627ca53023c054b52fb4b1bbc3683ff379c3621630d4aaad464f0f704`

- 摘录文件：[order_configuration.md](order_configuration.md)；SHA-256：`572001708ad47fbfebd6fbe18928c8828eade6df5688f0698210f29954711456`。
