46564645/Surgery_exoskeleton/firmware/Exoskeleton_F446/sim/mujoco_arm/model/orthoease/assets/05c_elbow_fixed_output_disc.stl

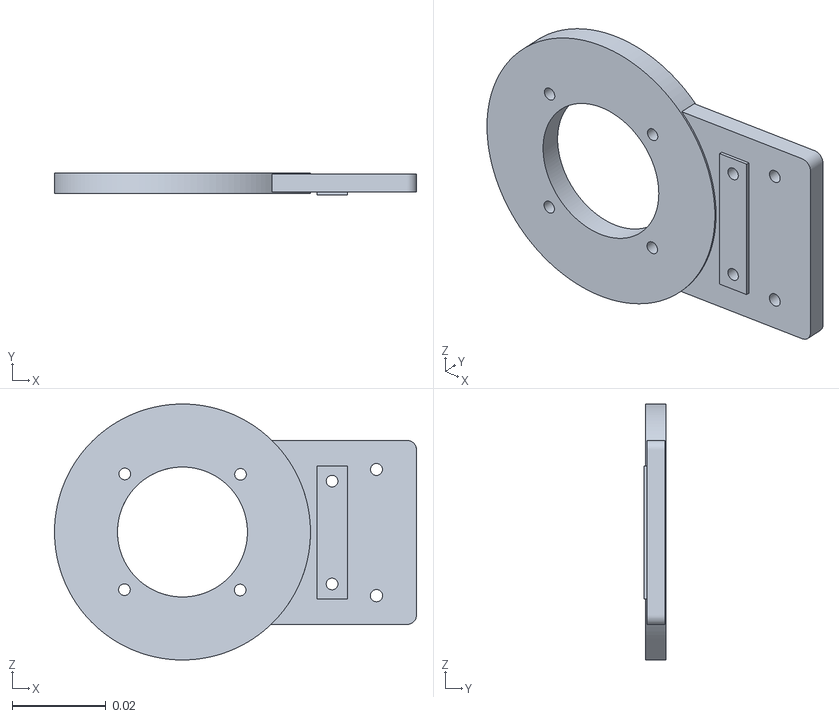
[picture p25: CAD file, 2026-10-27]
firmware/Exoskeleton_F446/sim/mujoco_arm/model/orthoease/assets/05c_elbow_fixed_output_disc.stl
0.0774 x 0.00478 x 0.0548
