46564645/Surgery_exoskeleton/Main_ project/Hardware_information_list/all_hardware_relevant_documents/GIM6010-8/drawings/GWK6010-8 3D Model.stp

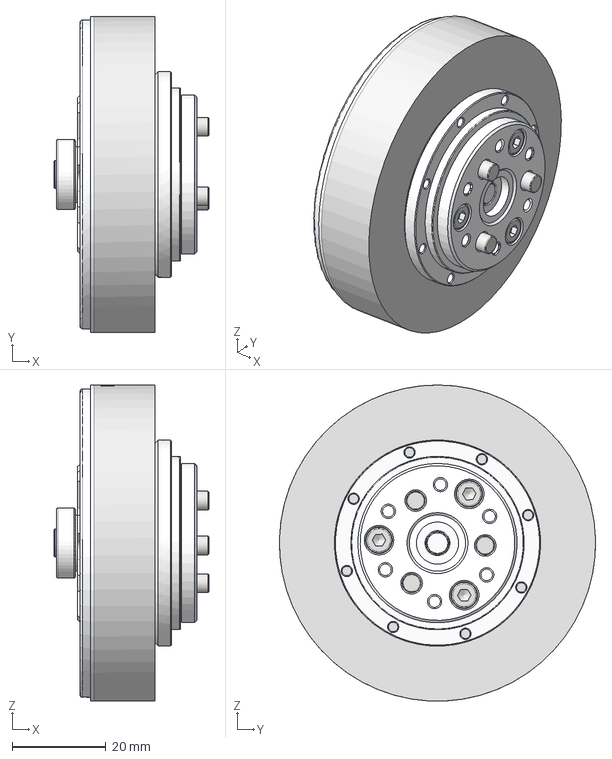
[picture p26: CAD file, 2026-09-25]
Main_ project/Hardware_information_list/all_hardware_relevant_documents/GIM6010-8/drawings/GWK6010-8 3D Model.stp
33.0 x 67.5 x 67.5 mm
