46564645/Surgery_exoskeleton/Open-source projects/Auxivo_EduExo_Maker/EduExo STL files/AdditionalCuffSizes/Upper_Arm_Cuff_110.stl

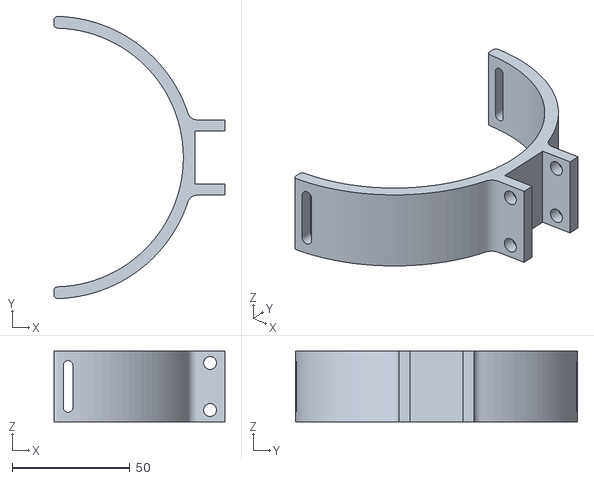
[picture p27: CAD file, 2026-09-22]
Open-source projects/Auxivo_EduExo_Maker/EduExo STL files/AdditionalCuffSizes/Upper_Arm_Cuff_110.stl
72.7 x 120.0 x 30.0
