46564645/Surgery_exoskeleton/Open-source projects/Auxivo_EduExo_Maker/EduExo STL files/MotorAdapter.stl

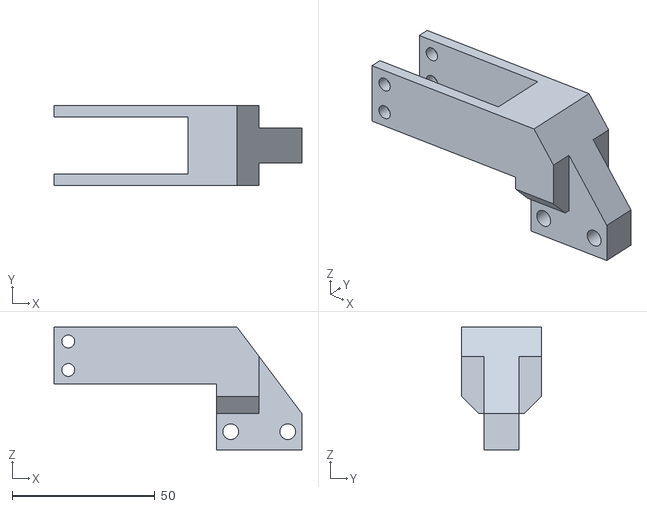
[picture p28: CAD file, 2026-09-22]
Open-source projects/Auxivo_EduExo_Maker/EduExo STL files/MotorAdapter.stl
87.0 x 28.0 x 43.0
