46564645/Surgery_exoskeleton/self models/3d-printing arm cuff.stl

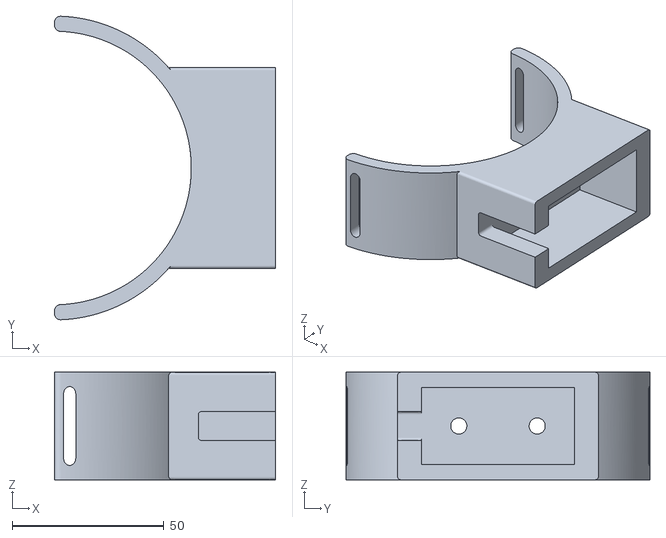
[picture p29: CAD file, 2026-09-22]
self models/3d-printing arm cuff.stl
72.7 x 99.9 x 35.4
