46564645/Surgery_exoskeleton/self models/右臂/整臂_J2固定座.step

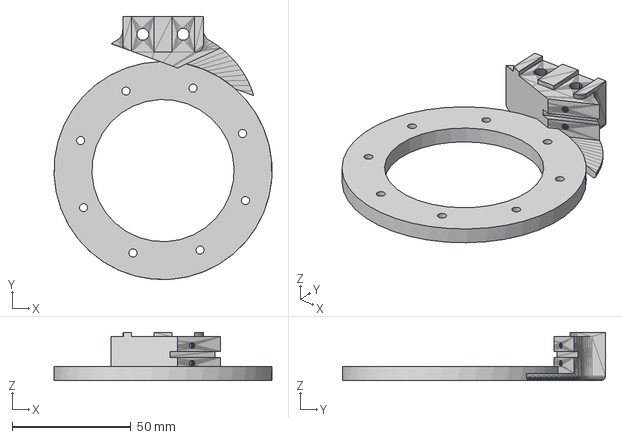
[picture p30: CAD file, 2026-09-22]
self models/右臂/整臂_J2固定座.step
91.9 x 111.0 x 20.3 mm
