46564645/Surgery_exoskeleton/self models/右臂/电机模型/13AFE811C19FDFAE261833B0B7DD1662.SLDPRT

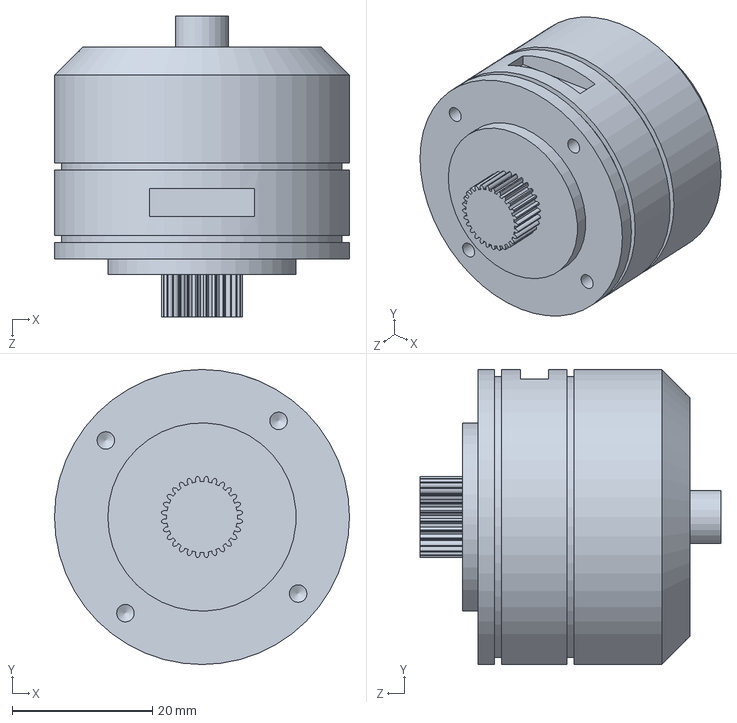
[picture p31: CAD file, 2026-09-24]
self models/右臂/电机模型/13AFE811C19FDFAE261833B0B7DD1662.SLDPRT
42.0 x 42.0 x 42.8 mm
