46564645/Surgery_exoskeleton/firmware/Exoskeleton_F446/sim/mujoco_arm/model/orthoease/assets/06_triple_head_link.stl

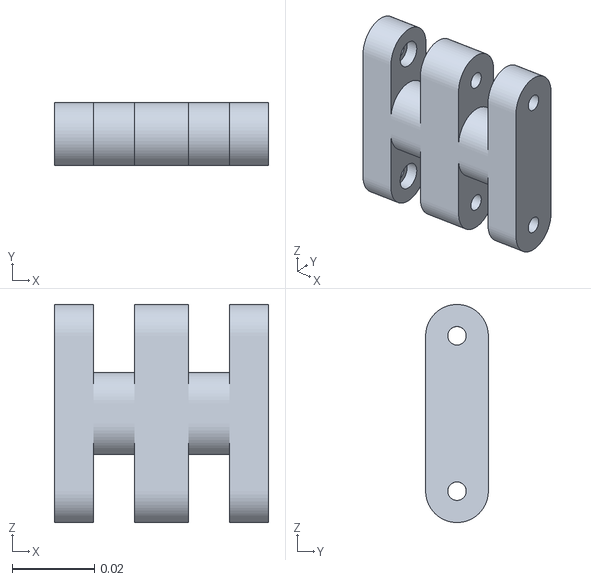
[picture p32: CAD file, 2026-10-27]
firmware/Exoskeleton_F446/sim/mujoco_arm/model/orthoease/assets/06_triple_head_link.stl
0.052 x 0.0152 x 0.053
