46564645/Surgery_exoskeleton/Main_ project/Hardware_information_list/all_hardware_relevant_documents/GIM6010-8/drawings/GIM6010-8  3D Model-Brake Version.stp

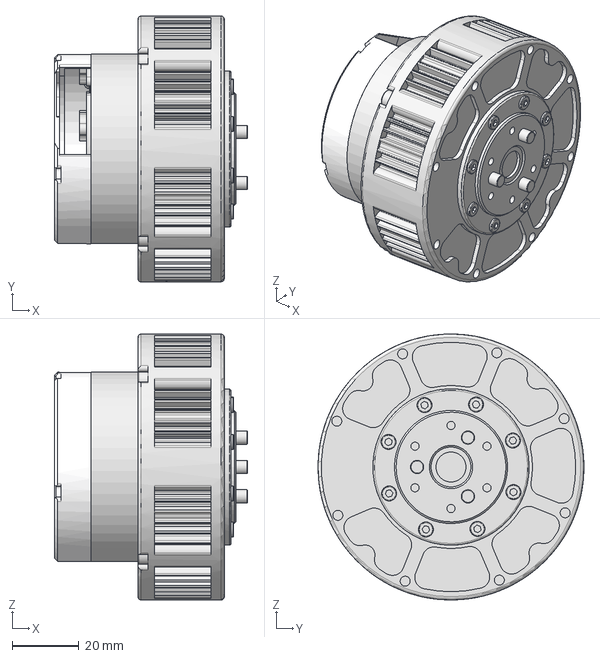
[picture p33: CAD file, 2026-09-25]
Main_ project/Hardware_information_list/all_hardware_relevant_documents/GIM6010-8/drawings/GIM6010-8 3D Model-Brake Version.stp
58.1 x 80.0 x 80.0 mm
6010-8刹车_简化_1
V5驱动盖
