46564645/Surgery_exoskeleton/Open-source projects/Auxivo_EduExo_Maker/EduExo STL files/AdditionalCuffSizes/Upper_Arm_Cuff_90.stl

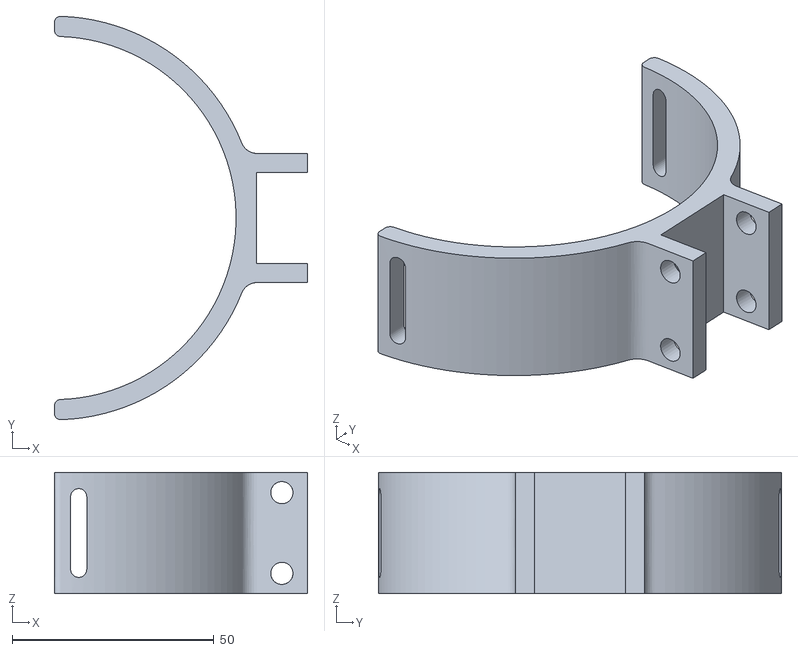
[picture p34: CAD file, 2026-09-22]
Open-source projects/Auxivo_EduExo_Maker/EduExo STL files/AdditionalCuffSizes/Upper_Arm_Cuff_90.stl
62.7 x 100.0 x 30.0
