46564645/Surgery_exoskeleton/Open-source projects/Auxivo_EduExo_Maker/EduExo STL files/Lower_Arm_Segment.stl

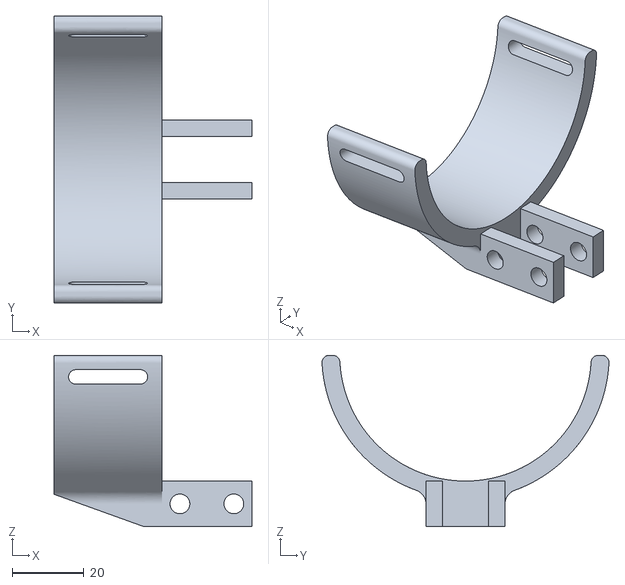
[picture p35: CAD file, 2026-09-22]
Open-source projects/Auxivo_EduExo_Maker/EduExo STL files/Lower_Arm_Segment.stl
55.0 x 79.9 x 47.7
