46564645/Surgery_exoskeleton/self models/j3_自制关节转子.stp

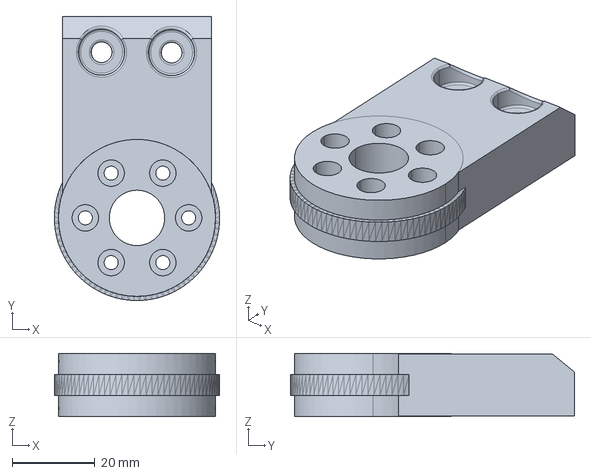
[picture p36: CAD file, 2026-09-22]
self models/j3_自制关节转子.stp
40.0 x 68.7 x 15.2 mm
