46564645/Surgery_exoskeleton/self models/右臂/J3_V4_07_前臂输出叉_试装打印1件.step

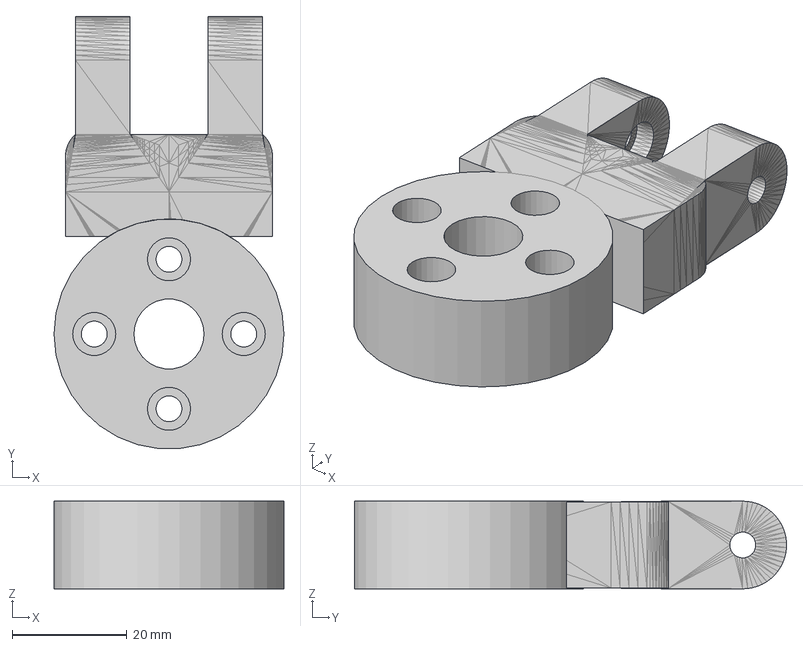
[picture p37: CAD file, 2026-09-22]
self models/右臂/J3_V4_07_前臂输出叉_试装打印1件.step
40.0 x 75.1 x 15.2 mm
