46564645/Surgery_exoskeleton/self models/右臂/电机模型/GIM6010-8_standard_with_GDS68_reference.stp

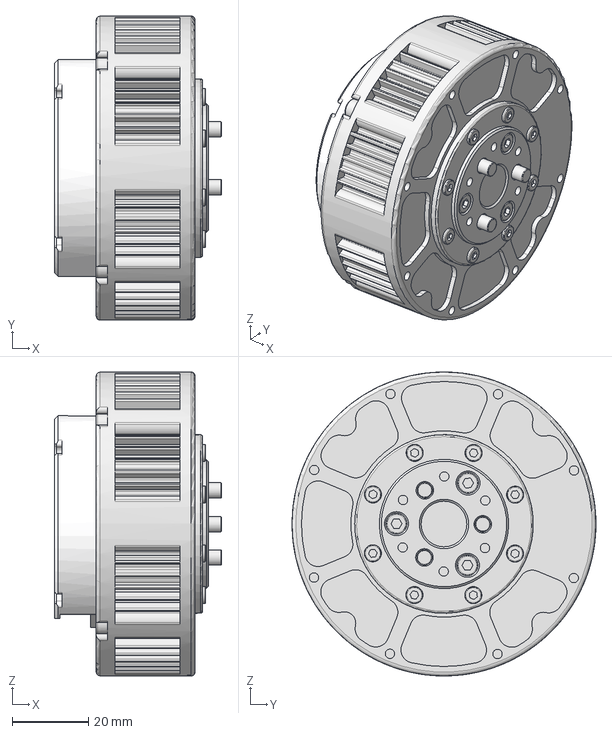
[picture p38: CAD file, 2026-09-22]
self models/右臂/电机模型/GIM6010-8_standard_with_GDS68_reference.stp
44.0 x 80.0 x 80.0 mm
6010-8_简化_1
V5驱动盖
