46564645/Surgery_exoskeleton/firmware/Exoskeleton_F446/sim/mujoco_arm/model/orthoease/assets/01b_stand_clamp.stl

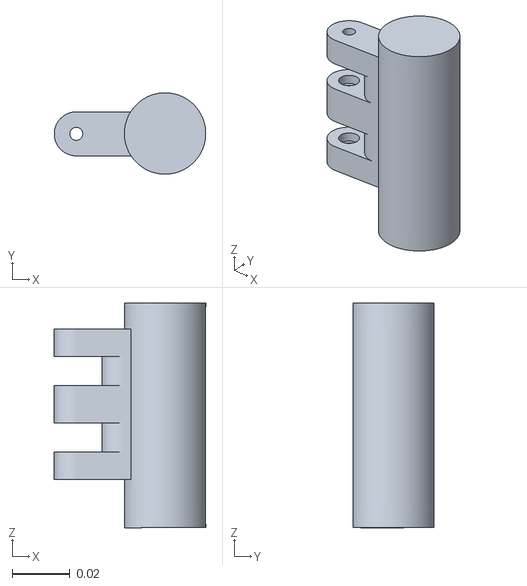
[picture p39: CAD file, 2026-10-27]
firmware/Exoskeleton_F446/sim/mujoco_arm/model/orthoease/assets/01b_stand_clamp.stl
0.0524 x 0.0281 x 0.0778
