46564645/Surgery_exoskeleton/Main_ project/Hardware_information_list/all_hardware_relevant_documents/GIM6010-8/drawings/GIM6010-8 3D Model-Shaft Extension Version.stp

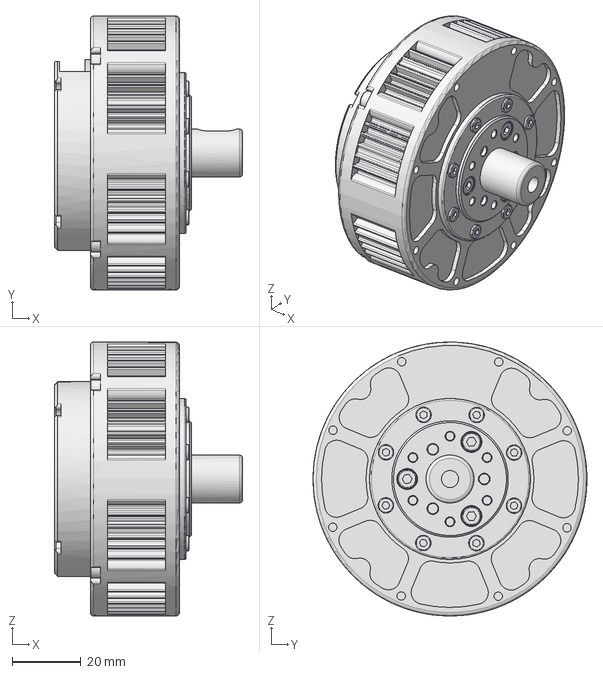
[picture p40: CAD file, 2026-09-25]
Main_ project/Hardware_information_list/all_hardware_relevant_documents/GIM6010-8/drawings/GIM6010-8 3D Model-Shaft Extension Version.stp
55.0 x 80.0 x 80.0 mm
