46564645/Surgery_exoskeleton/Open-source projects/Auxivo_EduExo_Maker/EduExo STL files/AdditionalCuffSizes/Upper_Arm_Cuff_70.stl

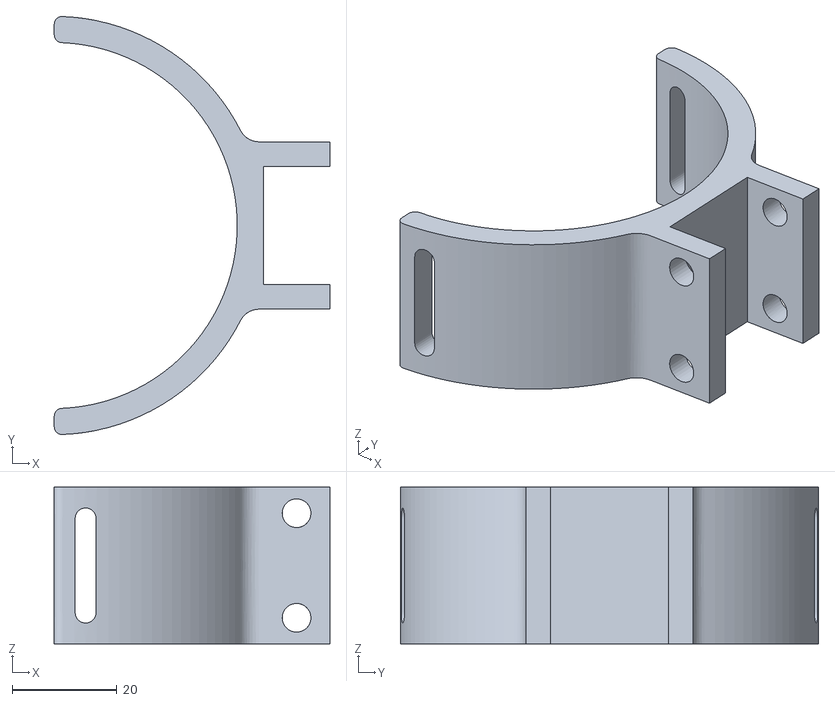
[picture p41: CAD file, 2026-09-22]
Open-source projects/Auxivo_EduExo_Maker/EduExo STL files/AdditionalCuffSizes/Upper_Arm_Cuff_70.stl
52.7 x 79.9 x 30.0
