46564645/Surgery_exoskeleton/firmware/Exoskeleton_F446/sim/mujoco_arm/model/orthoease/assets/03_upper_arm_magnetic_interface.stl

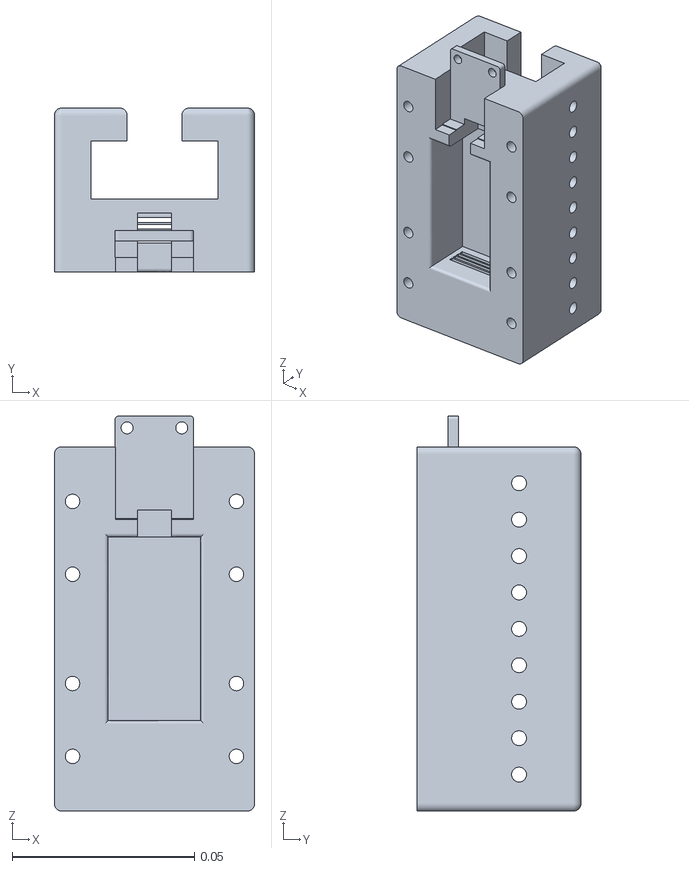
[picture p42: CAD file, 2026-10-27]
firmware/Exoskeleton_F446/sim/mujoco_arm/model/orthoease/assets/03_upper_arm_magnetic_interface.stl
0.055 x 0.045 x 0.108
