46564645/Surgery_exoskeleton/Open-source projects/Auxivo_EduExo_Maker/EduExo STL files/Upper_Arm_Segment.stl

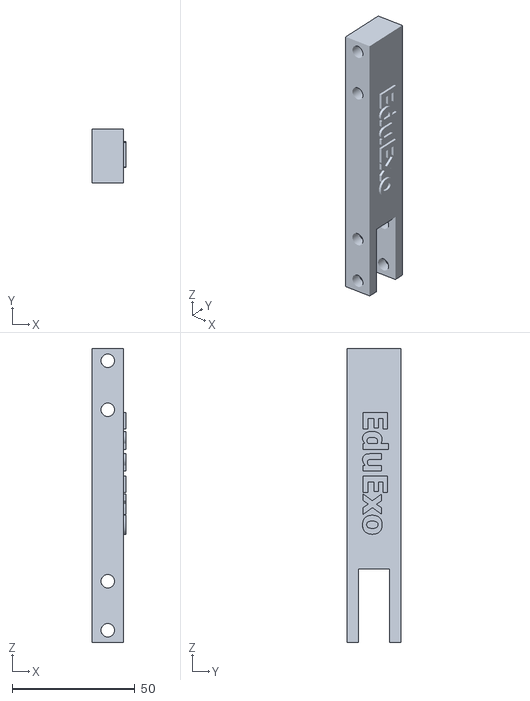
[picture p43: CAD file, 2026-09-22]
Open-source projects/Auxivo_EduExo_Maker/EduExo STL files/Upper_Arm_Segment.stl
13.7 x 22.0 x 120.0
