46564645/Surgery_exoskeleton/firmware/Exoskeleton_F446/sim/mujoco_arm/model/orthoease/assets/02b_upper_arm_beam.stl

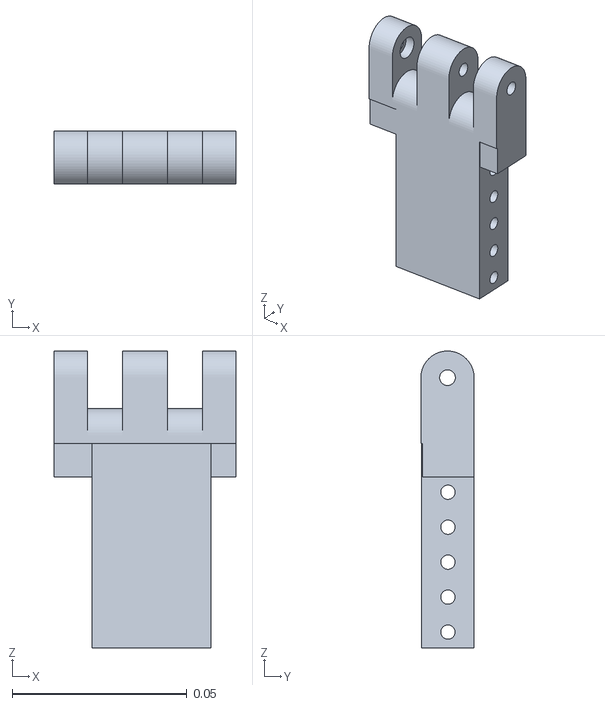
[picture p44: CAD file, 2026-10-27]
firmware/Exoskeleton_F446/sim/mujoco_arm/model/orthoease/assets/02b_upper_arm_beam.stl
0.052 x 0.0153 x 0.0849
