46564645/Surgery_exoskeleton/Open-source projects/Auxivo_EduExo_Maker/EduExo STL files/Interface_Motor_Sensor.stl

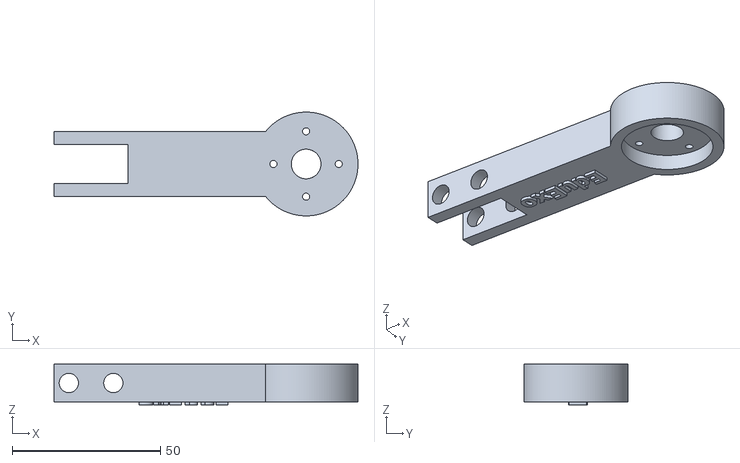
[picture p45: CAD file, 2026-09-22]
Open-source projects/Auxivo_EduExo_Maker/EduExo STL files/Interface_Motor_Sensor.stl
102.5 x 35.0 x 13.7
