46564645/Surgery_exoskeleton/firmware/Exoskeleton_F446/sim/mujoco_arm/model/orthoease/assets/05a_elbow_driven_fork.stl

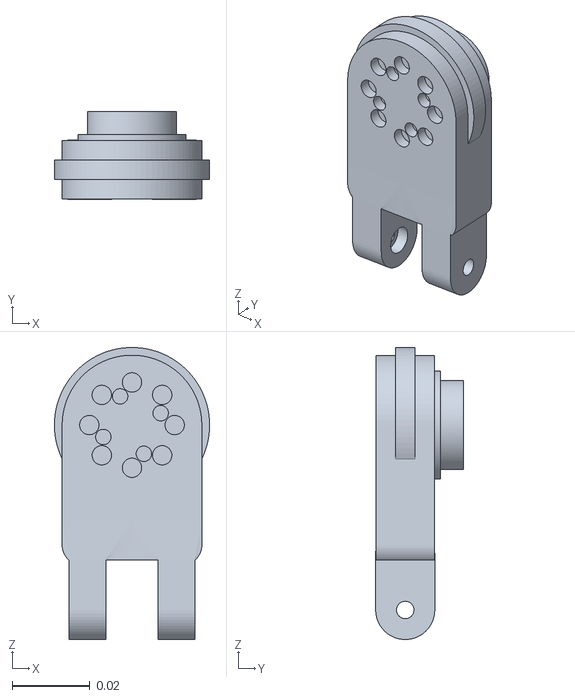
[picture p46: CAD file, 2026-10-27]
firmware/Exoskeleton_F446/sim/mujoco_arm/model/orthoease/assets/05a_elbow_driven_fork.stl
0.04 x 0.0226 x 0.0752
