46564645/Surgery_exoskeleton/firmware/Exoskeleton_F446/sim/mujoco_arm/model/orthoease/assets/02d_shoulder_output_link.stl

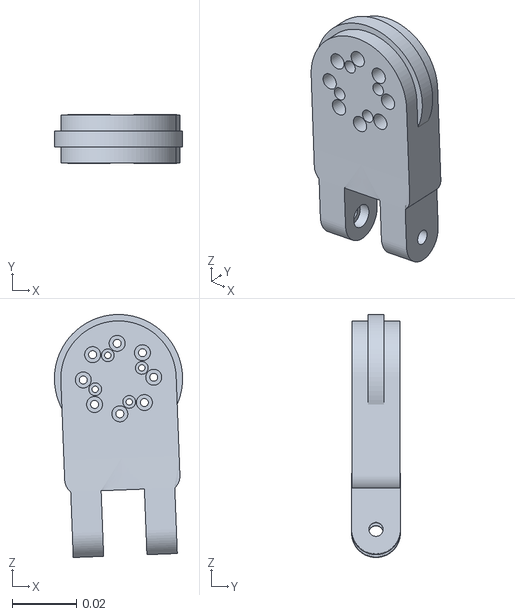
[picture p47: CAD file, 2026-10-27]
firmware/Exoskeleton_F446/sim/mujoco_arm/model/orthoease/assets/02d_shoulder_output_link.stl
0.04 x 0.0152 x 0.0758
