46564645/Surgery_exoskeleton/firmware/Exoskeleton_F446/sim/mujoco_arm/model/orthoease/assets/08b_forearm_magnetic_interface.stl

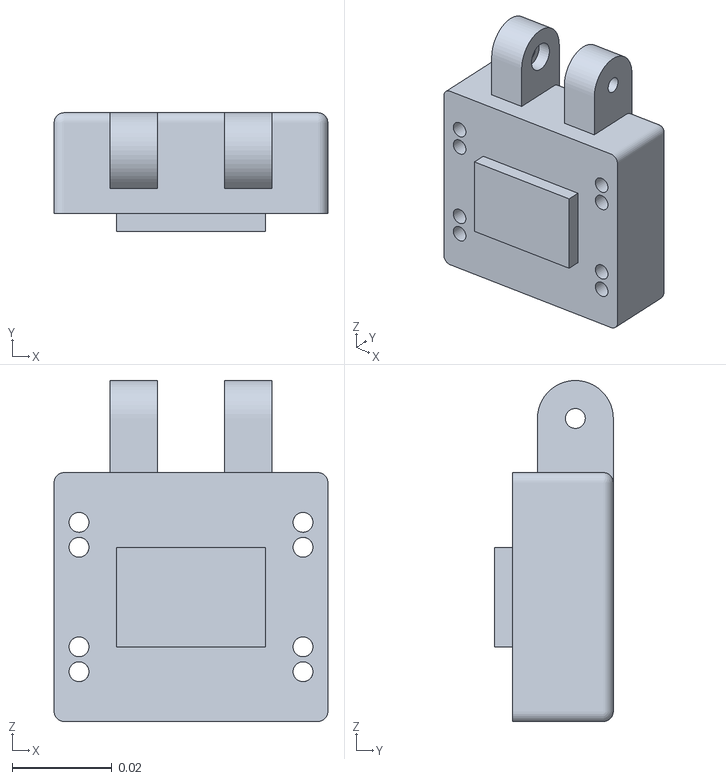
[picture p48: CAD file, 2026-10-27]
firmware/Exoskeleton_F446/sim/mujoco_arm/model/orthoease/assets/08b_forearm_magnetic_interface.stl
0.055 x 0.0238 x 0.0685
