46564645/Surgery_exoskeleton/firmware/Exoskeleton_F446/sim/mujoco_arm/model/orthoease/assets/elbow_motor_housing.stl

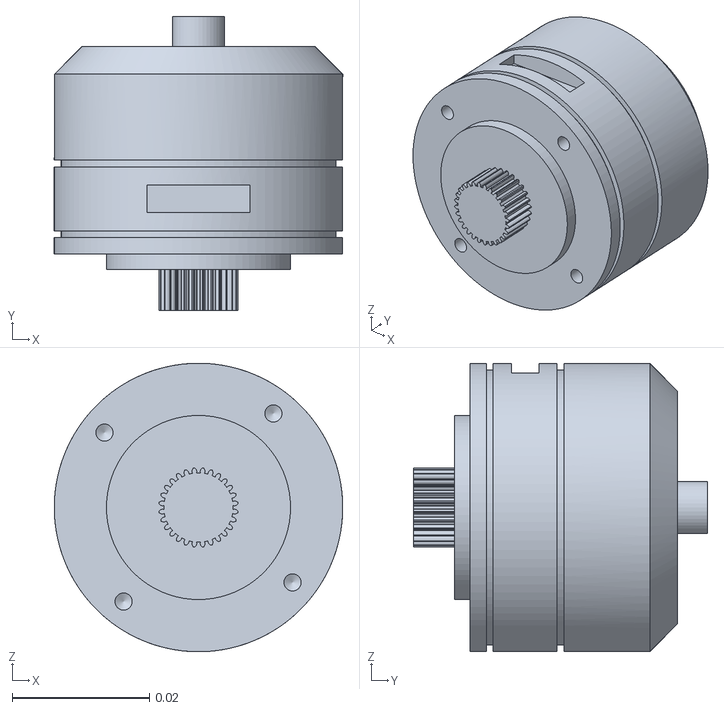
[picture p49: CAD file, 2026-10-27]
firmware/Exoskeleton_F446/sim/mujoco_arm/model/orthoease/assets/elbow_motor_housing.stl
0.042 x 0.0428 x 0.042
