46564645/Surgery_exoskeleton/firmware/Exoskeleton_F446/sim/mujoco_arm/model/orthoease/assets/02c_shoulder_driven_rotor.stl

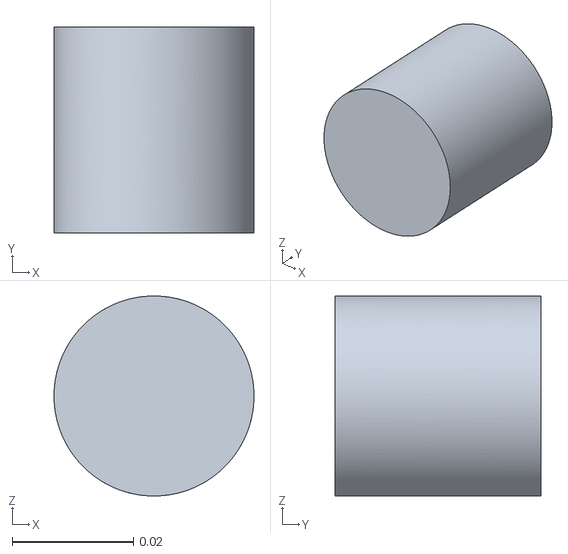
[picture p50: CAD file, 2026-10-27]
firmware/Exoskeleton_F446/sim/mujoco_arm/model/orthoease/assets/02c_shoulder_driven_rotor.stl
0.033 x 0.034 x 0.033
