46564645/Surgery_exoskeleton/firmware/Exoskeleton_F446/sim/mujoco_arm/model/orthoease/assets/05d_elbow_motor_mount.stl

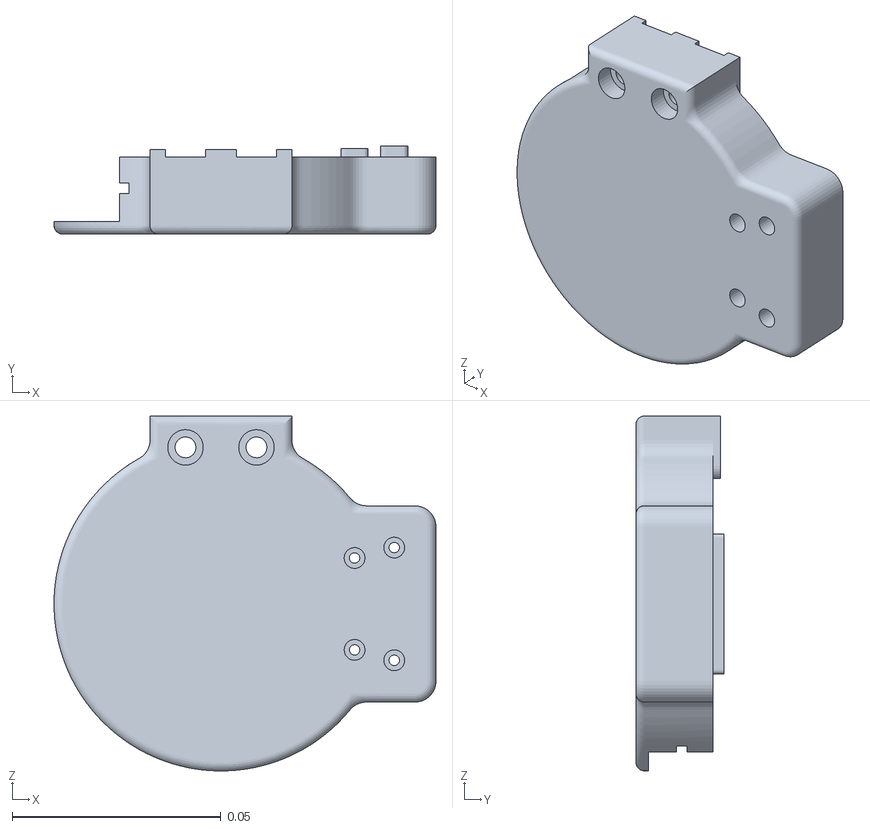
[picture p51: CAD file, 2026-10-27]
firmware/Exoskeleton_F446/sim/mujoco_arm/model/orthoease/assets/05d_elbow_motor_mount.stl
0.0915 x 0.0211 x 0.085
