46564645/Surgery_exoskeleton/firmware/Exoskeleton_F446/sim/mujoco_arm/model/orthoease/assets/01a_passive_rotary_base.stl

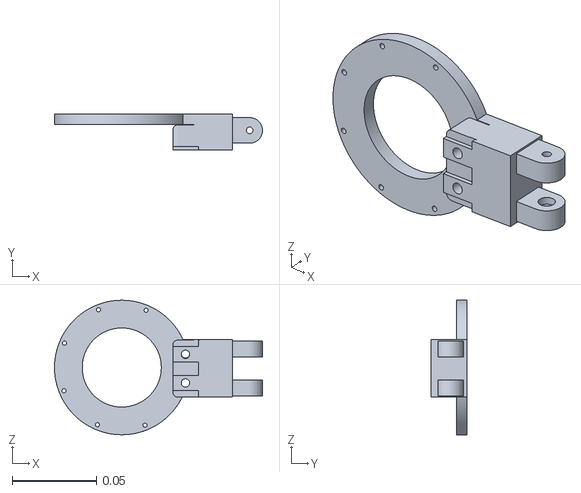
[picture p52: CAD file, 2026-10-27]
firmware/Exoskeleton_F446/sim/mujoco_arm/model/orthoease/assets/01a_passive_rotary_base.stl
0.124 x 0.0215 x 0.08
