46564645/Surgery_exoskeleton/firmware/Exoskeleton_F446/sim/mujoco_arm/model/orthoease/assets/08a_forearm_cuff.stl

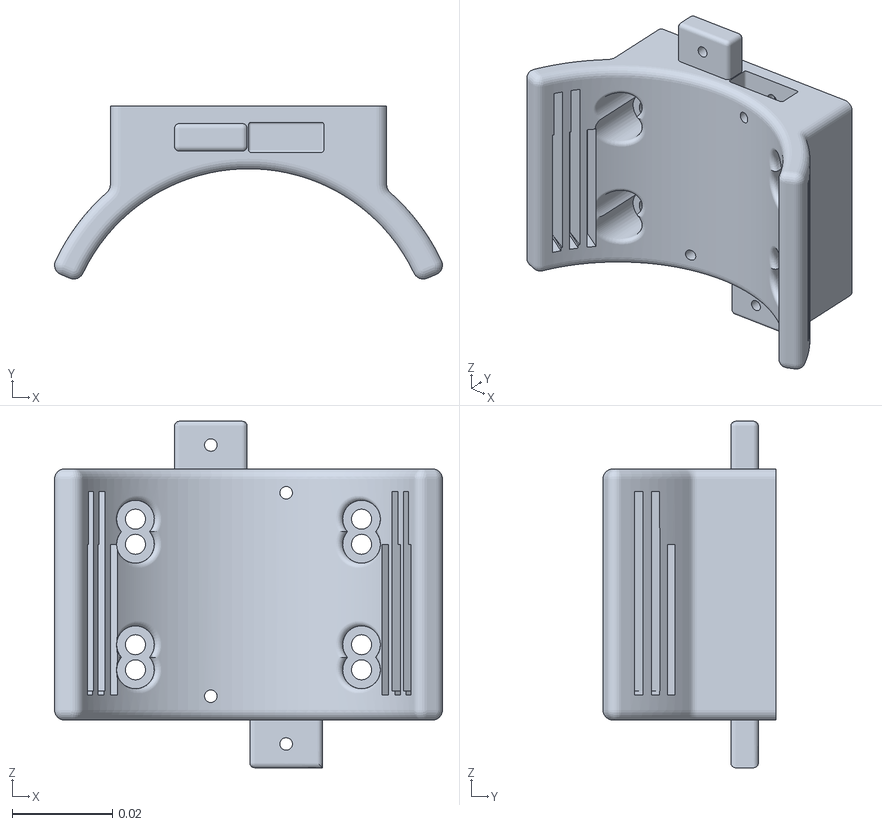
[picture p53: CAD file, 2026-10-27]
firmware/Exoskeleton_F446/sim/mujoco_arm/model/orthoease/assets/08a_forearm_cuff.stl
0.0772 x 0.0344 x 0.069
