46564645/Surgery_exoskeleton/firmware/Exoskeleton_F446/sim/mujoco_arm/model/orthoease/assets/04_upper_arm_adjustment_rail.stl

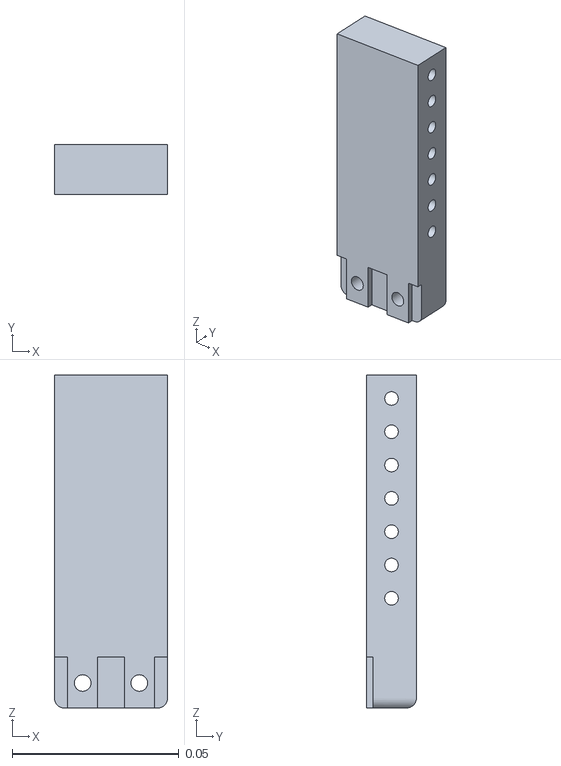
[picture p54: CAD file, 2026-10-27]
firmware/Exoskeleton_F446/sim/mujoco_arm/model/orthoease/assets/04_upper_arm_adjustment_rail.stl
0.034 x 0.015 x 0.1
