46564645/Surgery_exoskeleton/firmware/Exoskeleton_F446/sim/mujoco_arm/model/orthoease/assets/02e_shoulder_motor_mount.stl

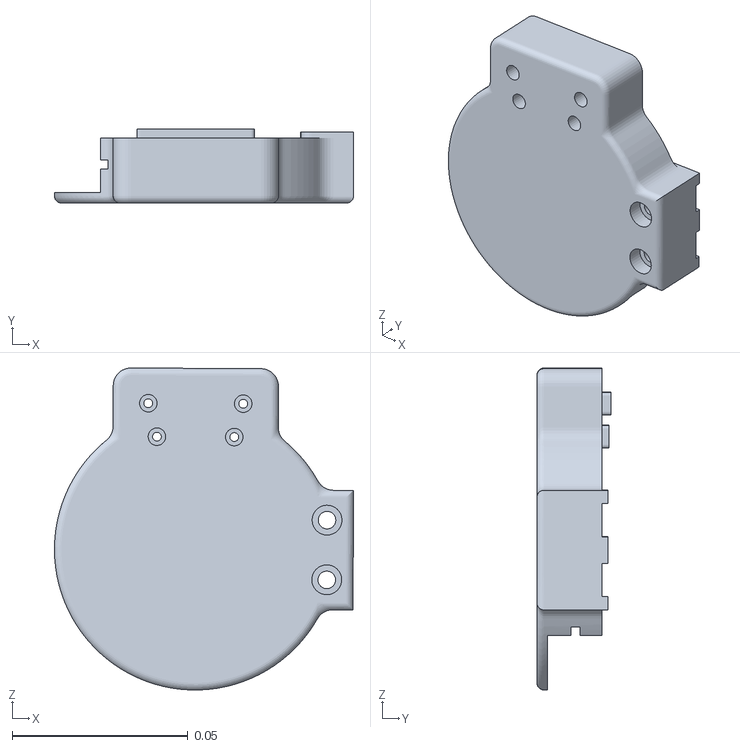
[picture p55: CAD file, 2026-10-27]
firmware/Exoskeleton_F446/sim/mujoco_arm/model/orthoease/assets/02e_shoulder_motor_mount.stl
0.0851 x 0.0211 x 0.0916
