46564645/Surgery_exoskeleton/firmware/Exoskeleton_F446/sim/mujoco_arm/model/orthoease/assets/03c_upper_arm_cuff.stl

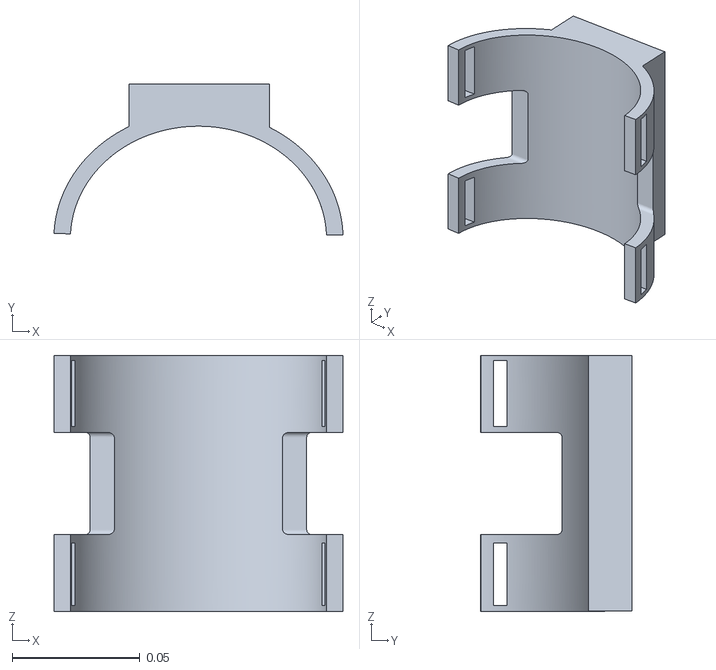
[picture p56: CAD file, 2026-10-27]
firmware/Exoskeleton_F446/sim/mujoco_arm/model/orthoease/assets/03c_upper_arm_cuff.stl
0.113 x 0.0593 x 0.1
