46564645/Surgery_exoskeleton/firmware/Exoskeleton_F446/sim/mujoco_arm/model/orthoease/assets/shoulder_motor_gim6010_2.stl

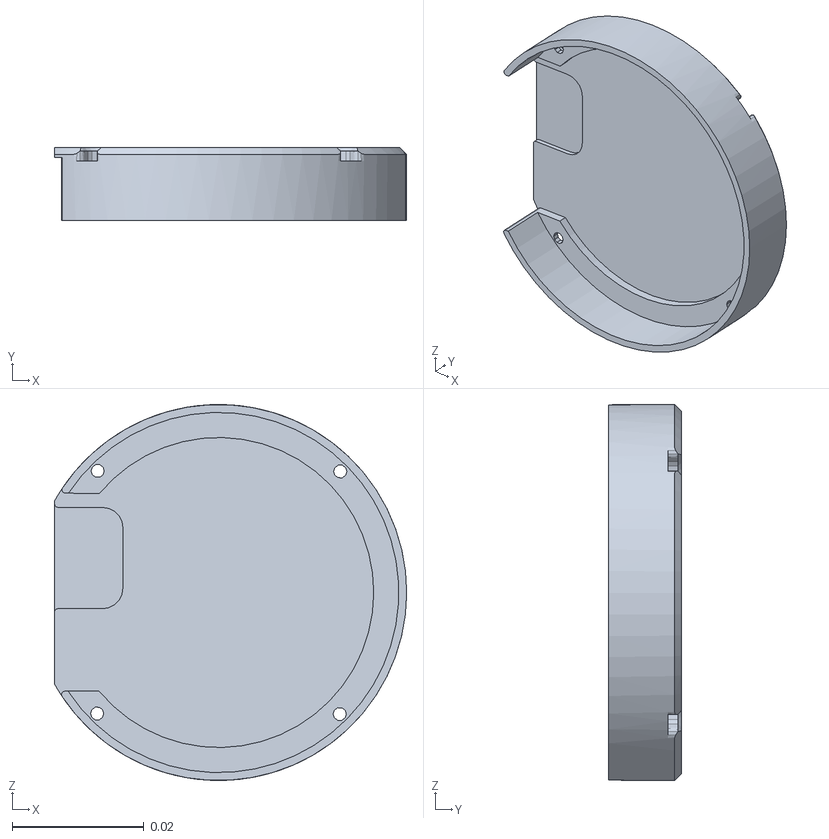
[picture p57: CAD file, 2026-10-27]
firmware/Exoskeleton_F446/sim/mujoco_arm/model/orthoease/assets/shoulder_motor_gim6010_2.stl
0.0534 x 0.011 x 0.057
