46564645/Surgery_exoskeleton/firmware/Exoskeleton_F446/sim/mujoco_arm/model/orthoease/assets/shoulder_motor_gim6010.stl

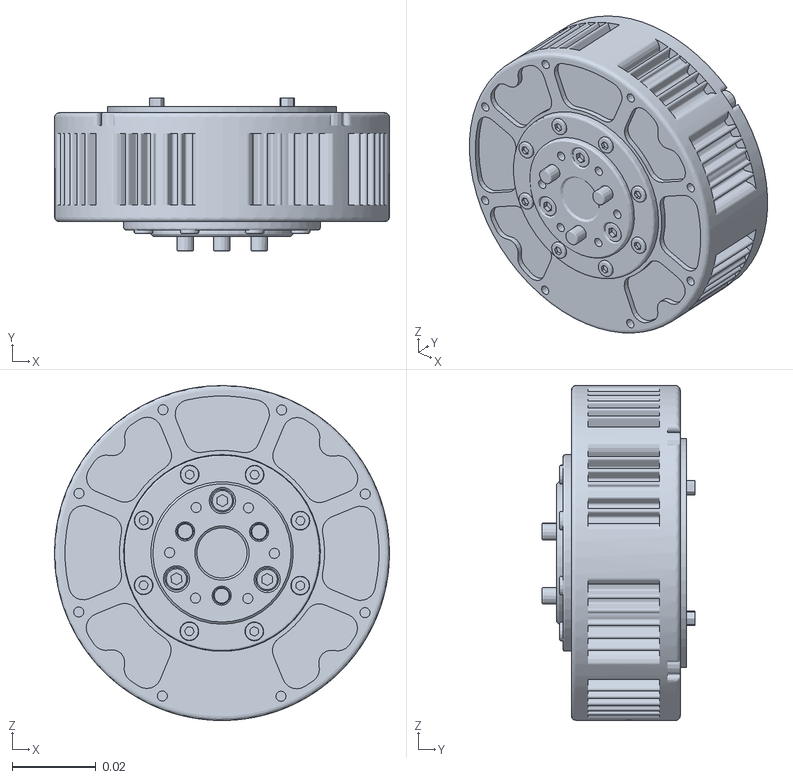
[picture p58: CAD file, 2026-10-27]
firmware/Exoskeleton_F446/sim/mujoco_arm/model/orthoease/assets/shoulder_motor_gim6010.stl
0.08 x 0.0365 x 0.08
