46564645/Surgery_exoskeleton/Open-source projects/elbow_exoskeleton-main/CAD/Elbow Exoskeleton - Left/Elbow Exoskeleton - Left.SLDASM

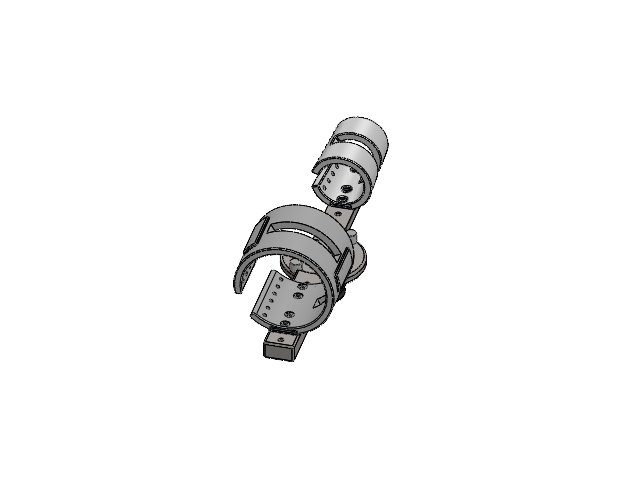
[picture p59: CAD file, 2026-09-22]
Open-source projects/elbow_exoskeleton-main/CAD/Elbow Exoskeleton - Left/Elbow Exoskeleton - Left.SLDASM
AK45-36-KV80 motor
Upper arm orthotic R55 - Left
Upper arm linkage - Left
Forearm orthotic R35 - Left
92005A435_Steel Pan Head Phillips Screw_M6_30mm x 2
90592A016_Steel Hex Nut_M6 x 7
Mechancial stop cover x 2
92005A427_Steel Pan Head Phillips Screw_M6_18mm x 5
ANR Muscle Sense Model M40 EMG sensor x 2
Upper arm orthotic structural insert
Forearm orthotic structural insert
Forearm linkage base
Forearm linkage front
