46564645/Surgery_exoskeleton/(list of files, cad)

Other CAD files:
Open-source projects/Auxivo_EduExo_Maker/EduExo STL files/Upper_Arm_Cuff_Large_180.stl
self models/pilot arm cuff.3dm
self models/右臂j3改过model.3dm
self models/肘部适配922.3dm
