46564645/Surgery_exoskeleton/Open-source projects/Auxivo_EduExo_Maker/EduExo Maker Readme.txt

Dear Exoskeleton Friend,

Thank you for being interested in the Auxivo EduExo Maker Edition.

Please find the handbook, the Arduino sketches, and the 3D printable STL files in this folder. In the subfolder "Cuffs," you will find different sizes for the upper arm cuffs. The handbook will guide you through the individual steps and provide you with all the necessary information.

If you have any problems or questions, please do not hesitate to contact us.

We invite you to share your results (pictures, videos, games, and other EduExo-based projects) with other members of the EduExo community and us through social media (Instagram, Twitter, LinkedIn, YouTube, or Facebook). Make sure to tag us so we can share your post with the hashtag #EduExo. 

We hope you enjoy your EduExo.

The Auxivo Team
