46564645/Surgery_exoskeleton/.embeddedskills/tmp/manual-review/c620-page33.png

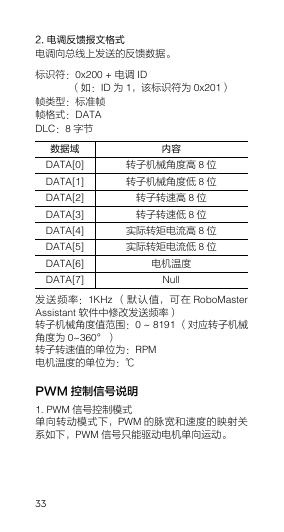
.embeddedskills/tmp/manual-review/c620-page33.png
