46564645/Surgery_exoskeleton/Main_ project/Hardware_information_list/all_hardware_relevant_documents/S-250-24_power_supply/seller_terminal_wiring_reference_S-350-24.png

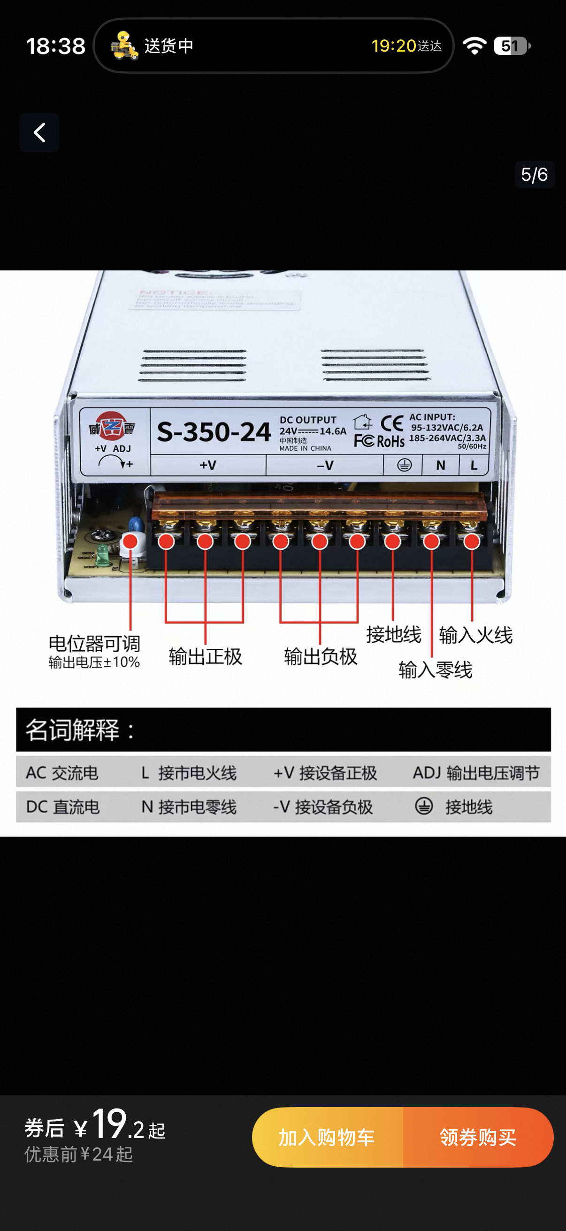
Main_ project/Hardware_information_list/all_hardware_relevant_documents/S-250-24_power_supply/seller_terminal_wiring_reference_S-350-24.png
