46564645/Surgery_exoskeleton/firmware/Exoskeleton_F446/sim/mujoco_arm/docs/validation_report.md

# 上肢外骨骼仿真验证报告（2026-10-28）

本报告汇总 MuJoCo 仿真对当前固件助力效果的验证结果。所有数字均为**模型假设下**的结果：物理参数、人体控制器与绑带模型都带假设，未与实物台架对标（M5 已按用户决定取消）。文中"省力"指人体关节力矩或肌肉激活量下降，不代表真人实测。

## 1. 目的

1. 用仿真**印证**现有固件控制程序确实省力，并给出量化结果。
2. 建立可在其中迭代优化的试验场：改控制逻辑后先在仿真里看结果，不必每次上实机。

## 2. 模型与来源

| 组成 | 来源 | 关键参数 |
|---|---|---|
| 人体 | MyoSim 0.2.3 `myoarm_r` | 站立、躯干固定；只保留肩前屈 `shoulder_elv_r` 与屈肘 `elbow_flexion_r`，63 块肌肉 |
| 外骨骼 | 用户 Fusion 导出包 `model/orthoease/`（只读副本） | 装在右臂外侧；沿 04 调节轨加长到 290.5 mm 与人肘对齐；质量按 STL 体积×ABS：上臂组 0.656 kg、前臂组 0.177 kg |
| 桌子/支架 | 代码构建 | 桌面 0.90 m；竖杆直径 14 mm，穿过 01B 夹持座孔（孔心由 STL 截面算出，Fusion (0.10784, 0.01981) m） |
| 绑带 | 两个软 `weld` | 上臂 03C、前臂 08A 绑定点；solref 0.05 s、torquescale 0.03 |

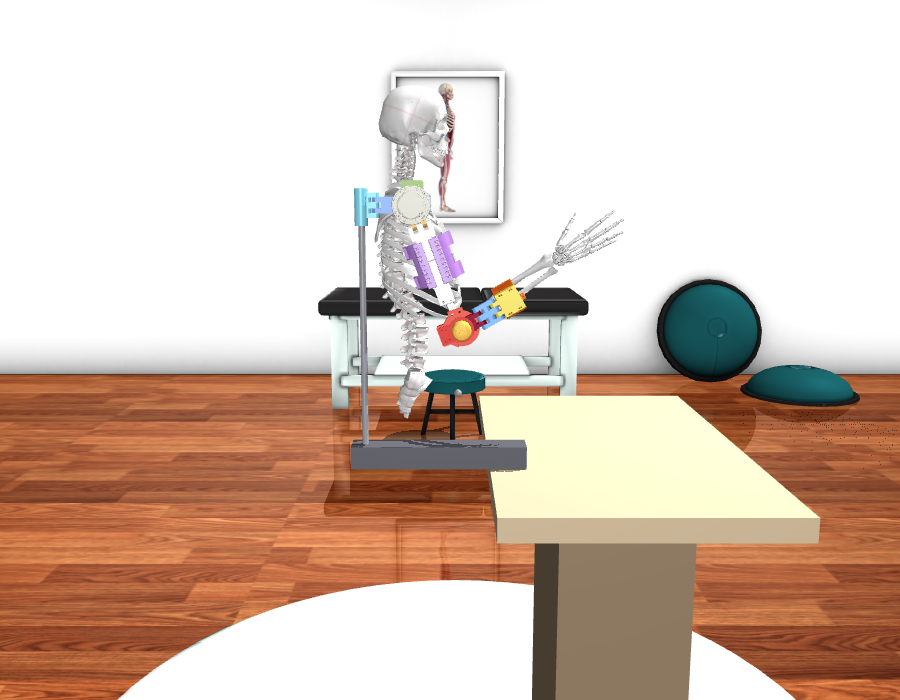
[picture p176: firmware/Exoskeleton_F446/sim/mujoco_arm/docs/figures/06_p1.png]
P1 姿势

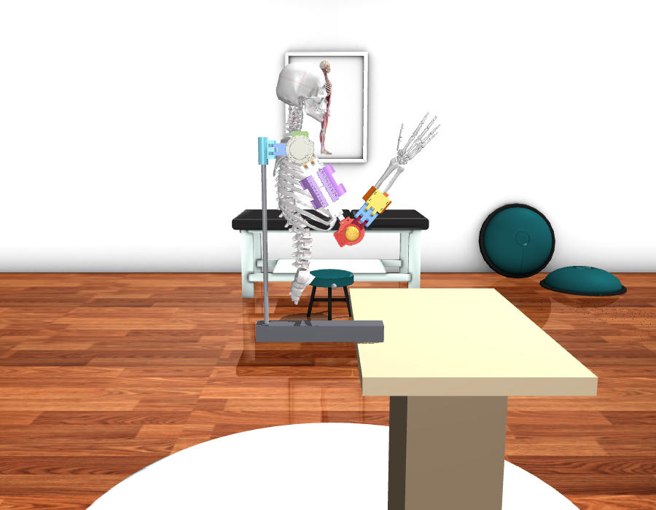
[picture p177: firmware/Exoskeleton_F446/sim/mujoco_arm/docs/figures/07_p4.png]
P4 姿势

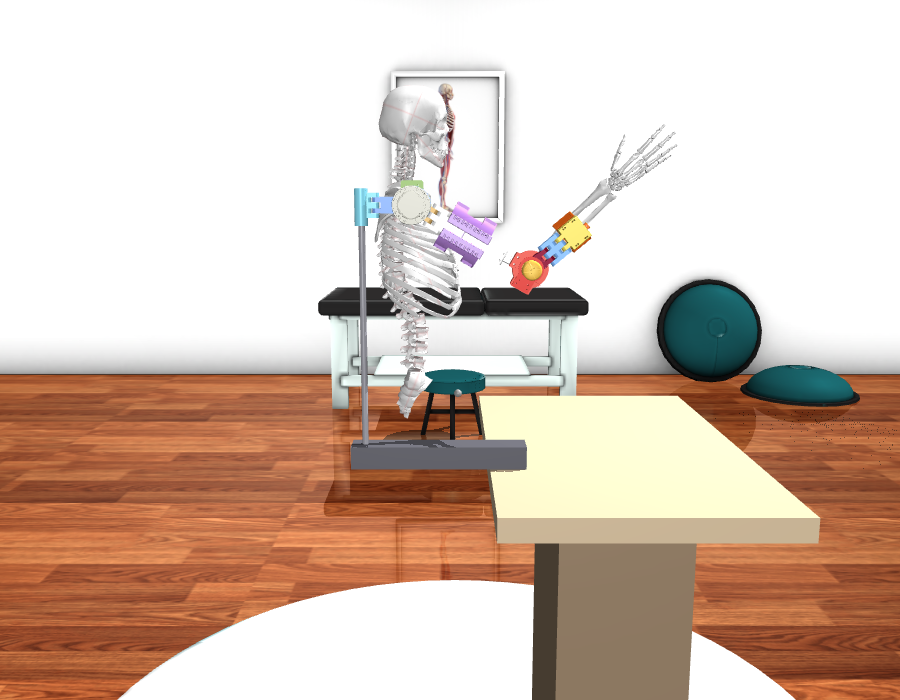
[picture p178: firmware/Exoskeleton_F446/sim/mujoco_arm/docs/figures/08_p5.png]
P5 姿势


*三个手术姿势：P1（肩 20°/肘 100°）、P4（30°/110°）、P5（60°/70°）。*

## 3. 控制接入

固件控制代码（`App/control/*.c` + `App/application/s5_site.c`）编译成主机库，仿真每 10 ms 调用一次，与真机同一份代码、同一套参数：

| 参数 | 值 |
|---|---|
| 肩重力模型 | 1.64 N·m × sin(肩角)，增益 1.5 |
| 肩输出上限 | 300 mNm 转子 = 2.4 N·m 关节侧 |
| 肩 Amplify | 300 mNm（速度 >20°/s 时叠加） |
| 肘重力模型 | 10 A × 0.02 N·m/A × sin(肩角+肘角) |
| 肘 Amplify | 10 A（速度 >20°/s 时按运动方向叠加） |
| 输出周期 | 10 ms |

人体侧有两种实现：**理想力矩**（关节直接加力矩）与**肌肉驱动**（计算力矩 → 静态优化 → 63 块肌肉）。本报告以肌肉驱动为主。

## 4. 三种条件

| 条件 | 含义 |
|---|---|
| C0 | 裸臂，不绑外骨骼 |
| C1 | 穿戴但外骨骼不通电（承担外骨骼自重） |
| C2 | 穿戴 + 固件助力 |

## 5. 结果

### 5.1 静态（三个手术姿势，各保持 47 s，肌肉驱动）

| 姿势 | 人体肩力矩 C0 / C1 / C2 | 全部肌肉激活和 C0 / C1 / C2 |
|---|---|---|
| P1（20°/100°） | 5.37 / 6.10 / **5.29** N·m | 0.39 / 0.42 / 0.39 |
| P4（30°/110°） | 5.89 / 6.85 / **5.66** | 0.55 / 0.59 / 0.55 |
| P5（60°/70°） | 8.93 / 10.42 / **8.35** | 1.04 / 1.11 / 1.02 |

静态结果

**穿戴代价**：不通电时肩力矩增加 13.6–16.7%（外骨骼自重 + 惯性）。
**助力收益**：相对穿戴不通电降低 13–20%；C2 甚至略低于裸臂 C0（P1 −1.5%、P4 −3.9%、P5 −6.5%），说明当前助力已略超"只抵消外骨骼自重"。

### 5.2 论文口径：单块肌肉（前三角肌 DELT1）

肩部外骨骼文献普遍只报特定肌肉（前/中/后三角肌）。同一批数据按该口径：

| 姿势 | C0 裸臂 | C1 穿戴不通电 | C2 助力 | **相对穿戴** | 相对裸臂 |
|---|---:|---:|---:|---:|---:|
| P1 | 0.054 | 0.066 | 0.053 | **−20.3%** | −2.5% |
| P4 | 0.129 | 0.145 | 0.125 | **−13.6%** | −2.9% |
| P5 | 0.344 | 0.375 | 0.332 | **−11.7%** | −3.6% |

三角肌结果

与文献对比：

| 研究 | 报告的数字 | 与本项目的关系 |
|---|---|---|
| Frontiers Bioeng. Biotechnol. 2024（MIS 肩外骨骼） | 三角肌前束 −21.0%、中束 −14.6%、后束 −8.3% | **同一区间**（本机 −11.7…−20.3%，相对穿戴） |
| Ergonomics 2026（模拟腹腔镜，软/硬两款） | 前三角肌各姿势均有下降 | 同上量级 |
| Applied Ergonomics 2024（助力 60–100%） | 抬臂阶段最多 −61~64% | 更高，因为助力覆盖整个重力矩 |
| ArmeoPower（整臂完全失重） | 峰值关节力矩 −74.8% | 远高于本机，属"全支撑"设备 |

**为什么"相对裸臂"只有 3% 左右**：本机助力上限 2.4 N·m，而 P5 姿势人臂需要 8.93 N·m，只覆盖约 23%；同时外骨骼自重 0.83 kg 挂在手臂上，给手臂增加约 22% 的负担。两者相抵，净收益自然小——这是**设计定位（助力而非全支撑）**决定的，不是控制逻辑问题。

### 5.3 爆发动作（肌肉驱动，含 Amplify）

| 指标 | G1 锤击（肘 100→45°，参考 180 ms） | G2 快速抬举（肩 5→45°，参考 250 ms） |
|---|---|---|
| 峰值力矩 C0 / C1 / C2 | 4.69 / 4.87 / **4.56** N·m | 44.7 / 46.5 / 46.1 N·m |
| 动作时间 | 435 ms | 225 ms |
| 稳态误差 | 1.2° | 0.2° |
| 人体正功 C0 / C1 / C2 | 18.8 / 19.5 / **18.7** J | 119.6 / 123.0 / 124.5 J |
| 外骨骼正功 | 2.0 J | 13.3 J |
| 助力收益（C2 vs C1，峰值力矩） | **−6.4%** | −0.7% |

Amplify 时序已按 ExoKit 的做法改为"瞬时切换"（原 200 ms 斜坡使增量到 241 ms 才达 90%，即爆发结束才起作用）；改后增量在 **121 ms** 全额介入，肘部收益由 −4.5% 提升到 **−6.4%**，且 C2 的峰值力矩与正功都低于裸臂 C0。

肩部仍只有 −0.7%，因为 250 ms 爆发的峰值力矩由惯性主导（4.6 N·m 对 46 N·m），放开上限到 575 mNm 也无改善（已验证）。

**G2 正功偏高的原因（已查明）**：按阶段拆分 G2 一个周期的做功：

| 阶段 | C1 穿戴不通电 | C2 助力 | 助力效果 |
|---|---:|---:|---|
| 抬臂（爆发） | 4.97 J | 4.63 J | **−6.8%（有用）** |
| 保持 | 4.37 J | 3.75 J | **−14.2%（有用）** |
| 放下（返回） | 2.85 J | 3.15 J | **+10.5%（帮倒忙）** |

原因是**重力补偿本身**：放下手臂时基线仍向上推，人必须用更大的力往下压。这与文献一致（Applied Ergonomics 2024 报告：助力接近或超过 100% 时，下放阶段伸肌激活最多升高 127%）。

**正功率门控**（只在加速段助力）已实现为编译选项 `S5_R5_AMPLIFY_ACCEL_GATE_DPS2`，但实测收益有限：锤击正功 18.7 → 18.4 J，峰值力矩反而由 −6.4% 退到 −4.8%，快速抬举不变；它只能撤掉 Amplify，撤不掉重力基线。**因此默认关闭（0）**，爆发结果均按关闭状态给出。

爆发结果

**为什么爆发收益小（定量）**：把肩部爆发力矩拆成惯性项与重力项：

| 动作时长 | 峰值惯性项 | 峰值重力项 | 重力占峰值 |
|---|---:|---:|---:|
| 250 ms | 80.75 N·m | 7.61 N·m | 8.6% |
| 430 ms | 27.30 | 7.61 | 21.8% |
| 600 ms | 14.02 | 7.61 | 35.2% |
| 800 ms | 7.89 | 7.61 | 49.1% |

现有控制只做重力补偿，爆发 90% 以上是惯性项，因此**理论上限只有 8.6%**；本机 2.4–4.6 N·m 的上限仅为惯性项的 3–6%。Amplify（速度触发增量）已接入肩、肘两通道，但其最大可能做功 4.6 N·m × 0.7 rad ≈ 3.2 J，对一次爆发的约 120 J 只有 2.5% 上限。

### 5.4 工作空间（肩 5–60° × 肘 30–110°）

工作空间热力图

数据：`build/sim-runs/workspace-final/`（当前默认参数：肩增益 1.5、上限 300 mNm、肘 10 A；静态保持，Amplify 不触发）。

- 穿戴代价均值 **+13.2%**（−1.8…+19.0%），助力收益均值 **+13.7%**（−1.8…+23.8%）；
- 抬臂越高、肘越弯收益越大（肩 60°/肘 70–110° 处 19–24%）；相对裸臂，肩 ≥20° 起 C2 才低于 C0（肩 60° 处 5.5–9.3%）；
- 肌肉激活收益均值 **+6.9%**（−14.4…+20.8%）；激活基线 <0.2 的 11 格不计百分比（图中 n/a，基线太小时百分比会被放大成假象）；
- **低抬臂（肩 10–15°）区域激活收益为负**（多为 −3…−5%，肩 10°/肘 50° 为 −14.4%），说明该区域补偿"帮过头"，需在台架小角度复核。

## 6. 结论

1. **静态/准静态省力成立**：相对穿戴不通电，肩力矩降低 13–20%、前三角肌激活降低 12–20%，与肩部外骨骼文献同一区间。
2. **相对裸臂收益小（约 3%）**：装置主要抵消自身重量，属设计定位问题；要提升需加大助力（上限 575 mNm/gain 3 时 P5 静态收益可达 35%）或给外骨骼减重。
3. **爆发动作收益有限（≤4.5%）**：爆发以惯性为主，重力补偿型控制不适用；若必须助力爆发，需要更大扭矩驱动或把动作定义在 ≥600 ms。
4. **两个独立指标方向一致**：关节力矩与肌肉激活都显示"穿戴更费力、助力后回落"，互为印证。

## 7. 已知限制

- 模型只有肩前屈与屈肘两个自由度；肩外展、内外旋、前臂旋转未建模，因此 DELT3、冈上/冈下肌等在模型里激活为 0。
- "人"是简化 PID + 计算力矩 + 最小激活优化，不是真实运动控制模型；数字适合作**相对比较**，不是真人用力的绝对预测。
- 外骨骼质量、质心、绑带软度、关节阻尼均为估计或假设（见 `model/params.json` 的 `status`）。
- 所有镜像**已编译未刷写**，实机行为未验证。

## 8. 复现

```powershell
cd firmware/Exoskeleton_F446
build\sim-venv\Scripts\python.exe sim\mujoco_arm\scripts\report_muscle_all.py   # 一键全套图
build\sim-venv\Scripts\python.exe sim\mujoco_arm\scripts\workspace_scan.py      # 工作空间热力图
build\sim-venv\Scripts\python.exe sim\mujoco_arm\scripts\check_static.py        # 场景与力学检查
```

## 9. 程序实现参考

复用顺序：本项目现有实现 → 开源项目 → 自行编写。只列真正用到的。

| 模块 | 参考来源 | 拿走了什么 | 改了什么 |
|---|---|---|---|
| 动作放大 | ExoKit `AmplifyReaction::runLoop()` | 速度触发、换向暂停状态机 | 肩/肘两通道；增量单位改为转子 N·m 与 C620 A；瞬时切换；新增正功率门控（默认关） |
| 人体模型 | MyoSim 0.2.3 `myoarm_r` | 骨骼、关节、63 块肌肉 | 只留两自由度；抬臂平面烘焙；去肌肉（度量模型保留） |
| 外骨骼 | 本项目 CAD 导出包 | 18 个 STL、两级转动关节、绑定点 | 质量按 STL×ABS 重算；调节轨加长 34.8 mm；执行器改力矩 |
| 仿真引擎 | MuJoCo 3.16.0 | 动力学、等式约束、`mj_fullM`/`qfrc_*` | 只调用 |
| 肌肉控制 | MyoSuite 教程 3.3/3.4、issue #337 | 期望加速度 → 广义力 → 静态优化 | `mj_inverse` 在本版本不填 `qfrc_inverse`，改用计算力矩公式 |
| 场景写法 | `myoarm_relocate.xml` | 静态桌子 box + contype 写法 | 桌子/方块/竖杆按本项目尺寸重建；竖杆轴线由 STL 截面算出 |
| 控制结构 | OpenSim CMC（Thelen 2003） | PD 求期望加速度 + 静态优化分层 | 在 MuJoCo 中实现，无残差执行器 |

## 10. 参考文献

1. Choi H.S. et al. *Front. Bioeng. Biotechnol.* 12 (2024). DOI 10.3389/fbioe.2024.1418148
2. Barbieri D.F. et al. *Ergonomics* (2026). DOI 10.1080/00140139.2026.2721391
3. Ramella G. et al. *Applied Ergonomics* (2024). DOI 10.1016/j.apergo.2024.104226
4. *J. Safety Research* (2024), live surgeries. DOI 10.1016/j.jsr.2024.02.003
5. *Scientific Reports* 14 (2024), coactivation. DOI 10.1038/s41598-024-78090-2
6. ArmeoPower, *J. Biomech.* (2018). PubMed 29506759
7. Thelen D.G. et al. *J. Biomech.* 36(3):321-328 (2003). DOI 10.1016/S0021-9290(02)00432-3
8. Maffiuletti N.A. et al. *Eur. J. Appl. Physiol.* 116 (2016). DOI 10.1007/s00421-016-3346-6
9. ASTM F3517-21（外骨骼动作测试标准实践）
10. MuJoCo 3.16.0；MyoSim 0.2.3 / MyoSuite；ExoKit；MyoSuite issue #337

## 11. 本项目完成的工作

| 类别 | 内容 |
|---|---|
| 仿真环境 | MyoArm + CAD 外骨骼 + 0.90 m 桌子与竖杆 + 两条软绑带；轴对齐、调节轨加长、竖杆穿孔；参数集中且标注来源 |
| 控制接入 | 固件原码编成主机库、10 ms 调用；抽出 `s5_assist_compose` 共用；125 项主机测试 |
| 人体模型 | 理想力矩版 + 肌肉驱动版（计算力矩 + 静态优化 + 63 肌肉） |
| 实验 | 工作空间 12×9；三姿势 ×60 s；两个爆发动作；T1–T3（早期理想力矩对照，脚本已于 2026-10-28 清理）；C0/C1/C2 |
| 主要结果 | 三角肌 −11.7…−20.3%（相对穿戴）；相对裸臂约 3%；爆发 6.4%/0.7%；放下阶段 +10.5% 根因查明 |
| 固件改动 | 肘 2→10 A；肩增益 1.5/上限 300；肘 Amplify；Amplify 瞬时；输出 50→10 ms；正功率门控（关）。镜像已编译未刷写 |
| 工具与文档 | 8 个脚本、一键出图、Markdown + 中英对照 Word、schedule 1.2–1.4 与日志 |
| 未做 | 台架对标、刷写与实机验证、方向相关基线、跨受试者变异性、肩外展/旋转自由度 |

## 12. 图索引

| 文件 | 内容 |
|---|---|
| `figures/01_overview.png` | 静态、三角肌、爆发三张结果图拼合 |
| `figures/02_static.png` | 静态：全部肌肉激活与人体力矩 |
| `figures/03_deltoid.png` | 论文口径：前三角肌激活与降幅 |
| `figures/04_burst.png` | 爆发：激活量与角速度曲线 |
| `figures/05_workspace.png` | 工作空间热力图（穿戴代价/助力收益/激活收益） |
| `figures/06_p1.png` `07_p4.png` `08_p5.png` | 三个手术姿势的场景图 |
