46564645/Surgery_exoskeleton/firmware/Exoskeleton_F446/.auto-embedded/tasks/s4-shoulder-follow-plan/r4_readonly_measurement_20261007.md

# R4-0 肩侧只读姿态记录：B 排查参考点（2026-10-07）

状态：**只读记录有效；关节映射未验收**。本页保存用户要求日后可复查的物理 B 标记和候选角，不是运行配置、机械限位或人体穿戴许可。A 是本次台架当前姿态定义的相对 0°，B 是用户在 24V 关闭时做的可重复前屈标记；不把本次 A 当成跨上电绝对零位或重力模型零位。

## 可回查的 B 点

| 项目 | 本次记录 |
|---|---|
| 物理标记 | 固定件/活动件 A 对位标记；另有 B 前屈标记。用户报告单次 A→B→A′ 后 A′ 对齐 A，采集后断电用尺复核为“大概回到原点”；标记精度未量化。 |
| A 转子平台 | `0–7.0 s`，70 个新鲜样本，中位 `2.851597 rev`，范围 `2.851498–2.851678 rev`。 |
| B 转子平台 | `10.3–11.0 s`，7 个新鲜样本，中位 `4.617304 rev`，范围 `4.617066–4.617659 rev`。该平台仅约 0.7 s，不冒称保持 5 s。 |
| A′ 转子平台 | `14.0–30.0 s`，160 个新鲜样本，中位 `3.035288 rev`，范围 `3.034978–3.035502 rev`。 |
| B−A | `+1.765707 rev`；**暂按驱动器存量 8:1 且输出到关节 1:1**，候选相对角 `+79.4568°`，日常回查标为 **B≈+79.5°（待复核）**。 |
| 用户量角尺核对 | 用户在听到候选值后报告“尺子接近 +79.5°”；没有独立精确度数、误差或尺面照片，因此只支持量级的定性核对，不可据此定量确认总传动比。 |
| A′−A | `+0.183691 rev`，在同一 8:1 假设下相当于约 `+8.3°`，约为本次 A→B 转子变化的 10.4%；远大于 A/A′ 各平台内的转子波动。用户只做了手工标记及量角尺粗对位，报告“大概回到原点”，对位误差未量化；不能据此断定机构或编码器故障，也不能把 `8.3°` 当成实测关节回位误差。 |

本次前屈期间转子读数增大，只能作为这一趟的局部方向观察；电机施力正方向没有实测。A′ 的手工回位精度不足以判定转子差的来源；在可重复参考姿态尚未建立前，不把 `+79.5°`、`8:1`、A 转子绝对读数或任何活动范围写入 S4 运行配置。量角尺只需用于 B 的量级核对，后续不要求用户凭手工尺读达到亚度精度。

用户随后明确选择跳过 A′ 回位精度复测。R4-1 只读链有界复核完成后，用户又明确要求停止重复只读测试；现阶段不再要求重复摆位或上电采集。上述决定不把 A′ 重复性或关节映射改记为通过；`+0.183691 rev` 仍是两段转子平台的差值，不能据此判断关节实际偏差或电机精度。

## 原始证据和边界

- 原始目录：[`tests/encoder_capture/evidence-visible-20261007T135213783700Z-5ab03581/`](../../../tests/encoder_capture/evidence-visible-20261007T135213783700Z-5ab03581/)。`binding.json` SHA-256 `7BC2CF8C342765D62DCC9321D0AB7F40A706EDEFBAEF5F6D4C512F9C0FF04292`；`events.jsonl` `DE7E77633EA2D8E813BD062B94DA4975591067B47333096F79B4A54C87EA970C`；`summary.json` `639846C3A44E02E08FD6C0043BD7A7FFB1C4FDE9E58FC8F5BC8BE6171AFB6799`。
- 复位后的 USB-only 被动预检为 `evidence-20261007T1340458306957Z/`，`pairs=0/tx=0/output_allowed=0`。一次中间尝试 `evidence-visible-20261007T134204735063Z-4f7f603d/` 因 `hb=0`、肩侧 `rx=0` 在 `encstart` 前退出，未消耗额度；具体缺心跳原因未定。重新开始前的带电被动查询 `evidence-20261007T1350401417926Z/` 观察到新鲜无错心跳、肩侧 `rx` 增长、额度未用、输出许可 0。
- 本次 30 秒采集 `success=true`、`stop_acknowledged=true`、`session_completed_without_fault=true`；主机观察 300 个不同编码器配对，固件 `pairs=600/tx=1200/rejected=0`。肩侧 CAN `rx=14039→18554`，`drop/invalid/fov/err/bus_off` 均为 0；结束 `output_allowed=0`。只出现一次 `encstart`、一次 `encstop` 与状态查询，没有转矩、速度、位置或模式改变命令。用户报告采集后 24V 已关闭，无异常。
- 本页不是带动力 FOLLOW 验收。其后 R4-1 的输出禁用 S4 HSE 七属性只读链已完成有界复核；当前板上镜像及结果以唯一开发日志为准。以后若出现新的角度/回零问题，可先核对**同一物理 A/B 标记、尺子基准、承托与肘姿态**及现有原始记录，再决定是否确需新的测量；目前不再安排重复只读采集，也不让用户手工量亚度角。B 尺读数接近候选只能支持本次量级核对。
