46564645/Surgery_exoskeleton/firmware/Exoskeleton_F446/.agents/skills/aemb-journal/SKILL.md

---
name: aemb-journal
description: "把本次会话的过程叙事（做了什么/决策/下一步）写进 workspace/journal.md，下次 SessionStart 自动注入最近几条。会话收尾或做了重要决策时用。"
---

# `aemb-journal` —— 写一条跨会话记忆

把"本次会话做了什么 / 关键决策 / 下一步"追加到 `workspace/journal.md`。
下次开会话时 SessionStart 会注入最近 3 条，让新会话带着"故事"启动，而非从零。

```bash
python3 .auto-embedded/scripts/task.py journal "<本次会话摘要>"
```

何时写：会话收尾、做了重要决策、或 `aemb-finish-work` 时。一句话即可，例：
- "确认 USART1 用 DMA 收发；下一步写 drv_uart 的空闲中断"
- "放弃 SPI 软件模拟方案（时序不稳），改用硬件 SPI2"

> journal 记"过程叙事"（跨会话续上下文）；可复用的约定/坑请用 `aemb-finish-work` 的 promote 进 spec。两者分工见 spec/governance。
