46564645/Surgery_exoskeleton/firmware/Exoskeleton_F446/docs/bench/live-sessions/live-20261021-210507/figure/figure.pdf

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

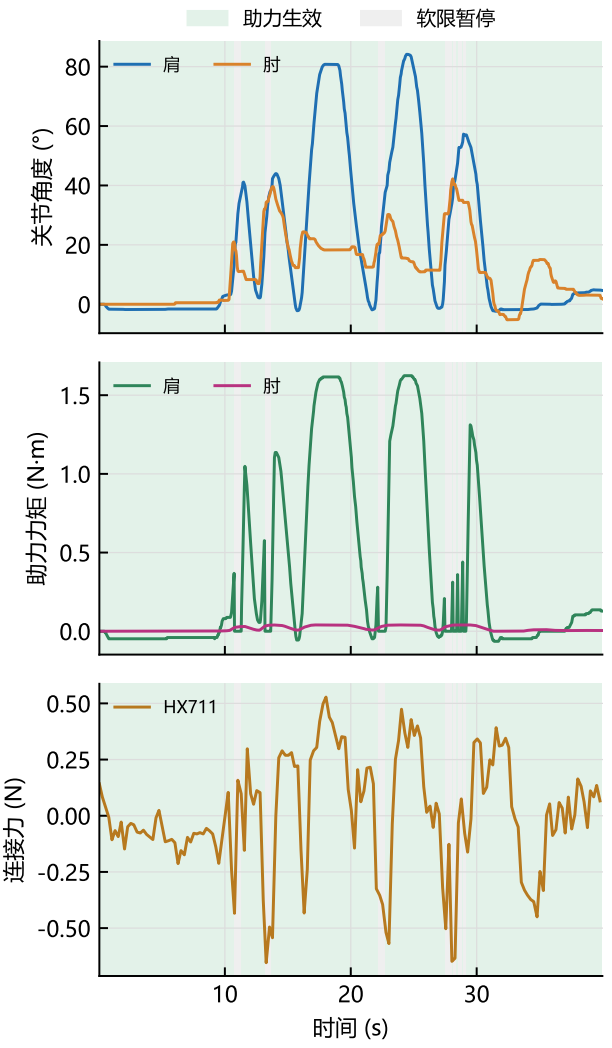
[picture p180: page 1]
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
