46564645/Surgery_exoskeleton/Open-source projects/elbow_exoskeleton-main/Main_Code_Files/Motor_Codes/AK4536_PositonControl_Main/AK4536_PositonControl_Main.ino

// CubeMars AK45-36 MIT Mode POSITION CONTROL with Portenta H7 on CAN1

// Libraries Required
#include <mbed.h>
#include "Arduino_PowerManagement.h"

// CAN Bus Setup (pins and rate)
mbed::CAN can1(PB_8, PH_13, 1000000);

// LED Pins
#define LED_RED   LEDR
#define LED_GREEN LEDG
#define LED_BLUE  LEDB

// Motor Configuration (set from cubemars app)
#define MOTOR_ID 2
const unsigned long CAN_ID = MOTOR_ID;

// Value Limits (from datasheet for AK series)
#define P_MIN -12.5f
#define P_MAX 12.5f
#define V_MIN -50.0f
#define V_MAX 50.0f
#define KP_MIN 0.0f
#define KP_MAX 500.0f
#define KD_MIN 0.0f
#define KD_MAX 5.0f
#define T_MIN -65.0f
#define T_MAX 65.0f

// Set Value Params
float p_in = 0.0f;
float v_in = 0.0f;
float kp_in = 200.0f;  // HIGH stiffness for position control
float kd_in = 3.0f;    // HIGH damping to prevent oscillation
float t_in = 0.0f;

// Measured Value Params
float p_out = 0.0f;
float v_out = 0.0f;
float t_out = 0.0f;

// Timing
uint32_t lastReceiveTime = 0;

/*********************************************************************************************************
  CONVERSION FUNCTIONS
*********************************************************************************************************/

unsigned int float_to_uint(float x, float x_min, float x_max, int bits) {
  float span = x_max - x_min;
  float offset = x_min;
  unsigned int pgg = 0;
  if (bits == 12) {
    pgg = (unsigned int)((x - offset) * 4095.0 / span);
  }
  if (bits == 16) {
    pgg = (unsigned int)((x - offset) * 65535.0 / span);
  }
  return pgg;
}

float uint_to_float(unsigned int x_int, float x_min, float x_max, int bits) {
  float span = x_max - x_min;
  float offset = x_min;
  float pgg = 0;
  if (bits == 12) {
    pgg = ((float)x_int) * span / 4095.0 + offset;
  }
  if (bits == 16) {
    pgg = ((float)x_int) * span / 65535.0 + offset;
  }
  return pgg;
}

/*********************************************************************************************************
  CAN COMMUNICATION SECTION 
*********************************************************************************************************/

void unpack_reply(uint8_t* dat, uint8_t len) {
  if (len != 6) return;

  unsigned int p_int = (dat[1] << 8) | dat[2];
  unsigned int v_int = (dat[3] << 4) | (dat[4] >> 4);
  unsigned int i_int = ((dat[4] & 0xF) << 8) | dat[5];

  p_out = uint_to_float(p_int, P_MIN, P_MAX, 16);
  v_out = uint_to_float(v_int, V_MIN, V_MAX, 12);
  t_out = uint_to_float(i_int, T_MIN, T_MAX, 12);

  lastReceiveTime = millis();

  // Optional: Visual feedback on CAN RX
  digitalWrite(LED_BLUE, LOW);
  delayMicroseconds(100);
  digitalWrite(LED_BLUE, HIGH);
}

void pack_cmd() {
  byte buf[8];

  float p_des = constrain(p_in, P_MIN, P_MAX);
  float v_des = constrain(v_in, V_MIN, V_MAX);
  float kp    = constrain(kp_in, KP_MIN, KP_MAX);
  float kd    = constrain(kd_in, KD_MIN, KD_MAX);
  float t_ff  = constrain(t_in, T_MIN, T_MAX);

  unsigned int p_int  = float_to_uint(p_des, P_MIN, P_MAX, 16);
  unsigned int v_int  = float_to_uint(v_des, V_MIN, V_MAX, 12);
  unsigned int kp_int = float_to_uint(kp, KP_MIN, KP_MAX, 12);
  unsigned int kd_int = float_to_uint(kd, KD_MIN, KD_MAX, 12);
  unsigned int t_int  = float_to_uint(t_ff, T_MIN, T_MAX, 12);

  buf[0] = p_int >> 8;
  buf[1] = p_int & 0xFF;
  buf[2] = v_int >> 4;
  buf[3] = ((v_int & 0xF) << 4) | (kp_int >> 8);
  buf[4] = kp_int & 0xFF;
  buf[5] = kd_int >> 4;
  buf[6] = ((kd_int & 0xF) << 4) | (t_int >> 8);
  buf[7] = t_int & 0xFF;

  mbed::CANMessage msg;
  msg.id  = CAN_ID;
  msg.len = 8;
  memcpy(msg.data, buf, 8);
  can1.write(msg);
}

/*********************************************************************************************************
  MOTOR MODE SECTION 
*********************************************************************************************************/

bool EnterMotorMode() {
  mbed::CANMessage msg;
  msg.id  = CAN_ID;
  msg.len = 8;
  msg.data[0] = 0xFF;
  msg.data[1] = 0xFF;
  msg.data[2] = 0xFF;
  msg.data[3] = 0xFF;
  msg.data[4] = 0xFF;
  msg.data[5] = 0xFF;
  msg.data[6] = 0xFF;
  msg.data[7] = 0xFC;

  if (!can1.write(msg)) return false;

  delay(50);
  return true;
}

void Zero() {
  mbed::CANMessage msg;
  msg.id  = CAN_ID;
  msg.len = 8;
  msg.data[0] = 0xFF;
  msg.data[1] = 0xFF;
  msg.data[2] = 0xFF;
  msg.data[3] = 0xFF;
  msg.data[4] = 0xFF;
  msg.data[5] = 0xFF;
  msg.data[6] = 0xFF;
  msg.data[7] = 0xFE;

  can1.write(msg);
  delay(100);
}

/*********************************************************************************************************
  MAIN FUNCTION SECTION
*********************************************************************************************************/

Board board;

void setup() {

  // For 3.3V pin outputs
  board.begin();
  board.setExternalVoltage(3.3);

  pinMode(LED_RED,   OUTPUT);
  pinMode(LED_GREEN, OUTPUT);
  pinMode(LED_BLUE,  OUTPUT);
  digitalWrite(LED_RED,   HIGH);
  digitalWrite(LED_GREEN, HIGH);
  digitalWrite(LED_BLUE,  HIGH);

  can1.mode(mbed::CAN::Mode::Normal);
  delay(3000);

  // Zero, then enable ONCE
  p_in = 0.0f;
  Zero();
  delay(1000);
  EnterMotorMode();
  delay(1000);

  digitalWrite(LED_GREEN, LOW);
  digitalWrite(LED_BLUE,  LOW);
  digitalWrite(LED_RED,   LOW);
}

// ############################
// MAIN LOOP - 1kHz Position Control
// ############################

void loop() {

  // 1. Unpack incoming CAN messages without blocking (Continuous)
  mbed::CANMessage msgIn;
  if (can1.read(msgIn, 0)) {
    if (msgIn.id == CAN_ID && msgIn.len == 6) {
      unpack_reply(msgIn.data, msgIn.len);
    }
  }
  
  // 2. 1 kHz (1000 microsecond) Timer Gate
  static uint32_t lastTime = micros();
  const uint32_t period_us = 1000;   

  uint32_t now = micros();
  if (now - lastTime < period_us) return;
  lastTime += period_us;

  // 3. Trajectory Generation Variables
  static float current_pos = 0.0f;
  static float sweep_speed = 0.25f; // rad/s
  static int sweep_dir = 1;         // 1 for forward, -1 for reverse

  // Calculate new position step (0.25 rad/s * 0.001 s = 0.00025 rad)
  current_pos += sweep_dir * sweep_speed * 0.001f;

  // Boundary checks to reverse direction automatically
  if (current_pos >= 1.570f) {
    current_pos = 1.570f;
    sweep_dir = -1; 
  } else if (current_pos <= 0.0f) {
    current_pos = 0.0f;
    sweep_dir = 1;  
  }

  // 4. Update MIT parameters for POSITION CONTROL
  p_in = current_pos;
  
  // CRITICAL: Velocity feedforward for smooth tracking
  v_in = sweep_dir * sweep_speed;
  
  // High gains for stiff position control
  kp_in = 200.0f;  // 20x stiffer than impedance mode
  kd_in = 3.0f;    // Damping scaled proportionally
  t_in = 0.0f;     // No feedforward torque needed

  // 5. Send command to motor
  pack_cmd();
}

/*********************************************************************************************************
  END FILE
*********************************************************************************************************/
