46564645/Surgery_exoskeleton/firmware/Exoskeleton_F446/Core/Src/main.c

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
/* Includes ------------------------------------------------------------------*/
#include "main.h"

/* USER CODE BEGIN Includes */
#include "app_main.h"
#include "board_runtime.h"
#include "board_can.h"

/* USER CODE END Includes */



CAN_HandleTypeDef hcan1;
CAN_HandleTypeDef hcan2;

UART_HandleTypeDef huart2;
DMA_HandleTypeDef hdma_usart2_rx;
DMA_HandleTypeDef hdma_usart2_tx;

void SystemClock_Config(void);
static void MX_GPIO_Init(void);
static void MX_DMA_Init(void);
static void MX_USART2_UART_Init(void);
static void MX_CAN1_Init(void);
static void MX_CAN2_Init(void);
/**
  * @brief  The application entry point.
  * @retval int
  */
int main(void)
{

  /* MCU Configuration--------------------------------------------------------*/

  /* Reset of all peripherals, Initializes the Flash interface and the Systick. */
  HAL_Init();

  /* Configure the system clock */
  SystemClock_Config();

  /* Initialize all configured peripherals */
  MX_GPIO_Init();
  MX_DMA_Init();
  MX_USART2_UART_Init();
  MX_CAN1_Init();
  MX_CAN2_Init();
  /* Initialize leds */
  BSP_LED_Init(LED2);

  /* Initialize USER push-button, will be used to trigger an interrupt each time it's pressed.*/
  BSP_PB_Init(BUTTON_USER, BUTTON_MODE_EXTI);

  /* Infinite loop */
  /* USER CODE BEGIN WHILE */
  if (!BoardRuntime_FinalizeInterrupts()) {
    BoardRuntime_FatalBlink();
  }
  App_Init();
  while (1)
  {

    /* USER CODE END WHILE */

    /* USER CODE BEGIN 3 */
    App_Poll();
  }
  /* USER CODE END 3 */
}

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
