46564645/Surgery_exoskeleton/firmware/Exoskeleton_F446/docs/bench/s4-r4-3-20261009/probe_profile.c

/* Host-only R4-3 gate probe. No hardware access. */
#include "s4_site.h"
#include <assert.h>
#include <stdio.h>

int main(void)
{
    const S4SiteProfile *site = S4Site_GetProfile();
    assert(site != NULL);
    assert(S4Site_ReadReady(site));
    assert(!S4Site_ObservationReady(site));
    assert(!S4Site_ProfileReady(site));
    assert(S4Site_SessionZeroReady(site));

    S4SiteProfile after_zero = *site;
    after_zero.s3.rotor_reference_confirmed[0] = true;
    after_zero.s3.safety.joint[0].mapping.rotor_zero_rad = 1.234f;
    assert(S4Site_ObservationReady(&after_zero));
    assert(S4Site_ProfileReady(&after_zero));
    assert(site->s3.safety.enabled_axes == SAFETY_SHOULDER_AXES);
    assert(site->s3.safety.joint[0].max_motor_command == 0.020f);
    assert(site->s3.safety.joint[0].lower_rad > 0.349f);
    assert(site->s3.safety.joint[0].upper_rad < 0.524f);
    assert(site->s3.shoulder_property_window_ms == 35000U);
    assert(site->s3.prepare_timeout_ms == 20000U);
    assert(site->session_ms == 10000U);
    assert(site->ramp_max_ms == 1000U);
    assert(site->s3.shoulder_property_window_ms
           > site->s3.prepare_timeout_ms + site->session_ms);

    double peak_nm = (double)site->gravity.amplitude_nm * site->assist_gain
        / site->s3.safety.joint[0].mapping.rotor_per_joint;
    double fixed_ms = 2.0 * site->send_interval_ms + site->stop_submit_budget_ms;
    unsigned steps = (site->ramp_max_ms - (unsigned)fixed_ms) / site->send_interval_ms;
    double removable_nm = steps * site->send_interval_ms * site->release_slew_nm_s / 1000.0;
    assert(peak_nm < site->s3.safety.joint[0].max_motor_command);
    assert(removable_nm >= site->s3.safety.joint[0].max_motor_command);
    printf("read_ready=1 cold_profile_ready=0 session_zero_ready=1 "
           "after_zero_ready=1 session_ms=%u reader_window_ms=%u "
           "ramp_in_ms=%u peak_rotor_nm=%.5f cap_nm=%.3f removable_nm=%.5f\n",
           site->session_ms, site->s3.shoulder_property_window_ms,
           site->session_ms - site->ramp_max_ms, peak_nm,
           site->s3.safety.joint[0].max_motor_command, removable_nm);
    return 0;
}
