46564645/Surgery_exoskeleton/firmware/Exoskeleton_F446/App/application/shoulder_property_feedback.c

/* Receive association adapted from encoder_stream: one pending request,
 * timestamp checks, complete-cycle S3/S4 or paired S5 publication, and no
 * retry after ambiguity.
 * No IDLE restriction: axis state and output permission belong to S3. */
#include "shoulder_property_feedback.h"
#include <math.h>
#include <stddef.h>
#include <string.h>

static bool duration_valid(uint32_t value)
{ return value > 0U && value < UINT32_C(0x80000000); }
void ShoulderPropertyFeedback_Init(ShoulderPropertyFeedback *r, uint32_t reply_timeout_ms)
{
    if (r == NULL) { return; }
    memset(r, 0, sizeof(*r));
    if (duration_valid(reply_timeout_ms)) { r->reply_timeout_ms = reply_timeout_ms; }
}
void ShoulderPropertyFeedback_EnableS5FastPath(ShoulderPropertyFeedback *r)
{
    if (r != NULL && r->reply_timeout_ms != 0U && !r->pending && !r->has_reply) {
        r->s5_fast_path = true;
    }
}
bool ShoulderPropertyFeedback_RequestZeroProof(ShoulderPropertyFeedback *r)
{
    if (r == NULL || !r->s5_fast_path || !r->s5_bootstrap_complete
        || r->quarantined || r->zero_proof_requested) { return false; }
    r->zero_proof_requested = true;
    r->published.zero_proof_valid = false;
    return true;
}
bool ShoulderPropertyFeedback_RequestModeProof(ShoulderPropertyFeedback *r)
{
    if (r == NULL || !r->s5_fast_path || !r->s5_bootstrap_complete
        || r->quarantined || r->mode_proof_requested) { return false; }
    r->mode_proof_requested = true;
    r->published.mode_pair_valid = false;
    return true;
}
void ShoulderPropertyFeedback_Invalidate(ShoulderPropertyFeedback *r)
{
    if (r == NULL) { return; }
    r->pending = false; r->quarantined = true; r->published.valid = false;
}
void ShoulderPropertyFeedback_Poll(ShoulderPropertyFeedback *r, uint32_t now_ms)
{
    if (r == NULL || !r->pending
        || (uint32_t)(now_ms - r->request_ms) <= r->reply_timeout_ms) { return; }
    /* A lost reply re-requests the same field; the exclusive TX owner submits
     * it on the next cycle. Only a run of timeouts latches the reader, so one
     * dropped SDO frame no longer ends the session. */
    r->pending = false;
    if (r->reply_retries >= SHOULDER_PROPERTY_MAX_RETRIES) {
        ShoulderPropertyFeedback_Invalidate(r);
    } else {
        r->reply_retries++;
    }
}
bool ShoulderPropertyFeedback_Expect(ShoulderPropertyFeedback *r,
                                    GdsPropertyField field, uint32_t submitted_ms)
{
    if (r == NULL || r->reply_timeout_ms == 0U || r->quarantined) { return false; }
    ShoulderPropertyFeedback_Poll(r, submitted_ms);
    if (r->quarantined) { return false; }
    if (r->pending || (unsigned)field >= GDS_PROPERTY_COUNT || field != r->next
        || (r->has_reply && (uint32_t)(submitted_ms - r->last_reply_ms) >= UINT32_C(0x80000000))) {
        ShoulderPropertyFeedback_Invalidate(r); return false;
    }
    if (field == GDS_PROPERTY_POSITION) {
        if (r->s5_fast_path && r->s5_bootstrap_complete) { r->working = r->published; }
        else { memset(&r->working, 0, sizeof(r->working)); }
    }
    r->request_ms = submitted_ms; r->pending = true;
    return true;
}
void ShoulderPropertyFeedback_Receive(ShoulderPropertyFeedback *r,
                                     BoardCanBus bus, const BoardCanFrame *f, uint32_t now_ms)
{
    if (r == NULL || r->reply_timeout_ms == 0U || r->quarantined || f == NULL
        || bus != BOARD_CAN_SHOULDER || (f->id & 0x1FU) != 0x005U) { return; }
    GdsPropertyValue value;
    /* A reply that arrives after the timeout was already replaced by a retry:
     * drop it instead of latching, the next request fetches fresh data. */
    if (!r->pending) { return; }
    if ((uint32_t)(now_ms - r->request_ms) > r->reply_timeout_ms
        || (uint32_t)(f->received_ms - r->request_ms) > r->reply_timeout_ms
        || (uint32_t)(now_ms - f->received_ms) > r->reply_timeout_ms
        || !GdsSdoRead_PropertyDecode(r->next, bus, f, &value)
        || ((r->next == GDS_PROPERTY_POSITION || r->next == GDS_PROPERTY_VELOCITY)
            && !isfinite(value.real * 6.2831853071795864769f))) {
        ShoulderPropertyFeedback_Invalidate(r); return;
    }
    r->working.value[r->next] = value;
    r->working.requested_ms[r->next] = r->request_ms;
    r->working.received_ms[r->next] = f->received_ms;
    r->last_reply_ms = f->received_ms; r->has_reply = true;
    r->pending = false;
    r->reply_retries = 0U;
    if (r->s5_fast_path && r->s5_bootstrap_complete) {
        if (r->next == GDS_PROPERTY_POSITION) {
            r->next = GDS_PROPERTY_VELOCITY;
        } else if (r->next == GDS_PROPERTY_VELOCITY) {
            /* A proof request can arrive while this pair is in flight. */
            r->working.zero_proof_valid = r->published.zero_proof_valid;
            r->working.mode_pair_valid = r->published.mode_pair_valid;
            r->working.sequence = r->published.sequence + 1U;
            r->working.valid = true; r->published = r->working;
            r->next = r->zero_proof_requested ? GDS_PROPERTY_INPUT_TORQUE
                : r->mode_proof_requested ? GDS_PROPERTY_CONTROL_MODE : GDS_PROPERTY_POSITION;
        } else if (r->next == GDS_PROPERTY_INPUT_TORQUE) {
            r->published.value[r->next] = value;
            r->published.requested_ms[r->next] = r->request_ms;
            r->published.received_ms[r->next] = f->received_ms;
            r->published.zero_proof_valid = true;
            r->zero_proof_requested = false;
            r->next = GDS_PROPERTY_POSITION;
        } else if (r->next == GDS_PROPERTY_CONTROL_MODE) {
            r->published.value[r->next] = value;
            r->published.requested_ms[r->next] = r->request_ms;
            r->published.received_ms[r->next] = f->received_ms;
            r->next = GDS_PROPERTY_INPUT_MODE;
        } else if (r->next == GDS_PROPERTY_INPUT_MODE) {
            r->published.value[r->next] = value;
            r->published.requested_ms[r->next] = r->request_ms;
            r->published.received_ms[r->next] = f->received_ms;
            r->published.mode_pair_valid = true;
            r->mode_proof_requested = false;
            r->next = GDS_PROPERTY_POSITION;
        }
    } else if ((unsigned)r->next + 1U == GDS_PROPERTY_COUNT) {
        r->working.sequence = r->published.sequence + 1U;
        r->working.valid = true;
        r->working.zero_proof_valid = r->working.mode_pair_valid = true;
        r->published = r->working;
        if (r->s5_fast_path) { r->s5_bootstrap_complete = true; }
        r->next = GDS_PROPERTY_POSITION;
    } else { r->next = (GdsPropertyField)((unsigned)r->next + 1U); }
}
bool ShoulderPropertyFeedback_Get(const ShoulderPropertyFeedback *r,
                                 uint32_t now_ms, uint32_t freshness_ms, ShoulderPropertySnapshot *out)
{
    if (out == NULL) { return false; }
    memset(out, 0, sizeof(*out));
    if (r == NULL) { return false; }
    *out = r->published;
    out->valid = out->valid && !r->quarantined && duration_valid(freshness_ms)
        && !(r->pending && (uint32_t)(now_ms - r->request_ms) > r->reply_timeout_ms);
    unsigned fields = r->s5_fast_path ? 2U : GDS_PROPERTY_COUNT;
    for (unsigned i = 0U; i < fields; i++) {
        /* Age from request is deliberately conservative: a response to a read
         * issued before a write must not certify that later write. */
        if ((uint32_t)(now_ms - out->requested_ms[i]) > freshness_ms) { out->valid = false; }
    }
    return out->valid;
}
