46564645/Surgery_exoskeleton/firmware/Exoskeleton_F446/App/application/s4_site.c

#include "s4_site.h"
#include "s3_shoulder_service.h"
#include "s2_config.h"
#include <math.h>
#include <stddef.h>

static const S4SiteProfile site = {
    .s3.safety.enabled_axes = 0U,
    .s3.safety.feedback_timeout_ms = 150U,
    .s3.shoulder_source = S3_SHOULDER_ENCODER_PROPERTIES,
    .s3.shoulder_property_reply_ms = 20U,
    .s3.shoulder_property_period_ms = 20U,
    .s3.shoulder_property_window_ms = 30000U,
    .s3.shoulder_node = S2_GDS_NODE,
    .s3.elbow_id = S2_C620_ID,
    .output_enabled = false,
    .session_zero_on_prepare = false
    /* Read timing follows the previous HSE seven-property bench profile;
     * this one bounded read-only session has a 30 s ceiling. Mapping,
     * model, motion limits and output confirmations remain false/zero. */
};

static bool duration(uint32_t ms)
{ return ms > 0U && ms < UINT32_C(0x80000000); }

#ifdef S4_SITE_HOST_TEST
static bool test_use_production;
static const S4SiteProfile test_s3_legacy = {0};
void S4Site_TestUseProduction(bool enabled) { test_use_production = enabled; }
const S4SiteProfile *S4Site_GetProfile(void)
{ return test_use_production ? &site : &test_s3_legacy; }
#else
const S4SiteProfile *S4Site_GetProfile(void) { return &site; }
#endif

bool S4Site_ReadReady(const S4SiteProfile *p)
{
    return p != NULL && S3ShoulderService_ReadProfileReady(&p->s3);
}
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
