46564645/Surgery_exoskeleton/(commit log)

2026-09-25 feat(firmware): add S1 DMA console and nonblocking scheduler
    Add static CLIP commands, pinned LwRB buffering, final IRQ checks after BSP initialization, and host regression tests. Hardware acceptance remains incomplete: SWD reports USB errors and VCP queries time out.
2026-10-02 feat(firmware): checkpoint S2 CAN feedback and bench evidence
    Add the receive-only dual-CAN foundation, C620 rotor position/velocity
    decoding, receive timestamps, freshness/offline recovery, and bounded
    console observations. Include the required CubeF4 CAN sources, host
    regressions, Windows development instructions, and project hardware docs.
    Record the verified C620 static cycle and the GDS Interface 2 driver fix
    and actual hardware/firmware/CAN settings. Persist the user's minimal
    necessary validation policy. S2 shoulder parsing and Form-error root
    cause remain unresolved; S3 motion has not been implemented or tested.
    Validation reused because the validated build inputs are unchanged:
    -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
2026-10-04 feat(firmware): accept scoped S2 shoulder feedback and archive bench profile
    Accept the approved S2 scope using the recorded30s continuous shoulder encoder
    window and one supervised100ms/20mNm relative trial with a sustained position
    change and completed stop observation. Dropout/recovery was canceled and was
    not executed. S3 is only partially accepted; velocity direction and calibrated
    joint motion remain unverified.
    Keep default production HSI and disabled output configuration. Archive the
    three HSE bench overlays and168 verified inputs with a device-free source
    materializer. A publication-only reconstruction produces the exact accepted
    91148-byte BIN SHA2567f844000b67d9880106a54b2f3fcd3f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
2026-10-16 feat(firmware): S5 R5 dual FOLLOW 30 s windows, CAN ALST resend, close S4
    Shoulder torque frames under NART=1 occasionally lost arbitration to GDS
    traffic and latched TRANSPORT; output frames now get one same-frame resend
    on confirmed ALST without TERR (mirrors the 10-07 read retry). R5 isolated
    profile raises shoulder assist to the full 1.64 Nm model (gain 1.0, 205 mNm
    rotor cap), runs 30 s sessions and widens the elbow lower edge to -20 deg.
    Three 30 s bench windows ran and stopped normally; elbow support remains
    ineffective and two known follow-ups (read TX ordering, soft pause clearing
    the shoulder baseline) are logged. S4 closed per user decision.
    Generated with [Devin](https://devin.a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
2026-10-18 feat(firmware): checkpoint HX711 force observations for follow-up control
    Preserve the temporary 452 g calibration, non-blocking raw acquisition,
    force reporting and RAM-only tare before changing the elbow candidate.
    Record the reduced-effort scope and observed wearing faults without
    claiming full support or physical safety validation.
    Generated with [Devin](https://devin.ai)
2026-10-20 feat(firmware): posture-dependent elbow gravity assist for R5 FOLLOW
    Fixed 2 A elbow current ignored forearm posture and pushed the arm even
    when hanging. Elbow current now follows sin(shoulder+elbow) up to the R5
    peak, so the hanging pose commands ~0 and assistance grows as the forearm
    rises. Host tests: default 111, R5 22, R4 3 pass; R5/default builds clean.
    Not flashed or bench tested.
    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
2026-10-20 feat(firmware): optional shoulder Amplify for R5 FOLLOW (ExoKit runLoop port)
    Ports ExoKit AmplifyReaction::runLoop() velocity-triggered logic to the
    shoulder: engage above 20 deg/s while raising, 400 ms direction-change
    suspension and hold, 200 ms ramp. The rotor-torque increment is added on
    top of the gravity baseline before the unchanged 205 mNm cap; the soft
    speed pause still withdraws everything. Build option
    S5_R5_SHOULDER_AMPLIFY_MNM (0..100, default 0 = off). HX711 not involved.
    Host tests (default 112, R5 S5 subset 24 at 0/40 mNm, R4 3) and
    R5/default cross builds pass. Not flashed or bench tested.
    Generated with [Devin](https://devin.ai)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
2026-10-21 feat(firmware): raise R5 elbow assist and harden the reader path
    Bench sessions kept ending early, so this bundle addresses the three causes
    found from the recorded sessions:
    - elbow gravity amplitude 2 A -> 14 A peak (0.28 Nm), which is 70% of the
    C620 command cap; soft limit 150 -> 200 deg/s and hard limit 240 -> 360
    deg/s so normal arm motion no longer pauses or latches.
    - session 30 -> 45 s and shoulder property window 55 -> 70 s, because the
    window must exceed prepare + session or the site reads as disabled.
    - shoulder SDO replies: a single lost reply used to quarantine the reader and
    abort FOLLOW. Now the same field is retried up to 4 times (CANopen practice)
    and late/duplic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
2026-10-21 feat(tools): live three-panel monitor and publication figure export
    Bench work needed to see the assist while it runs and to keep a figure that
    can go into a report:
    - tests/live_monitor/s5_live_window.py owns the VCP for one bounded session,
    reuses the existing preflight/stop sequence, plots shoulder/elbow angle,
    assist torque and HX711 force on a rolling 60 s axis, shades assist and
    soft-pause windows, and writes samples.csv / force.csv / session.jsonl.
    The firmware only keeps READY for 20 s, so one confirmed click runs the
    whole sequence instead of waiting for a second press.
    - tests/live_monitor/figure_session.py redraws the same CSV as a vector
    figure (PDF/SVG/PNG) with fix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
2026-10-26 feat(sim): MuJoCo table + exoskeleton + arm model, plus pending R5 force-assist work
    - sim/mujoco_arm: M0 environment and M1 model. params.json is the only
    physical parameter source; build_model.py emits the MJCF and
    check_static.py verifies the scene headless (mj_inverse against the
    two-link formula, 1.638 Nm exoskeleton self weight vs the firmware
    1.64 Nm model, worn-unpowered +15.7% at 60 deg, strap coupling).
    - schedule/AGENTS/index: SIM plan, M0-M1 logs, stage row, directory entry.
    - firmware: optional HX711 force-triggered assist (default off), live-monitor
    and bench helper scripts carried over from the R5 sessions.
    - .gitignore: ignore MUJOCO_LOG.TXT written by MuJoCo on win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
2026-10-26 feat(sim): share the assist composition and add the SIL bridge and timing model
    M2a (firmware, pure move): compute_target()'s composition now lives in
    App/control/s5_assist_compose.c so the board and the simulation run the same
    code. Order, numbers and failure semantics are unchanged; s5_follow.c only
    gathers the site numbers and the force sample. Seven new host cases cover
    gravity, caps, assist gate, Amplify, force gain, elbow-only and invalid input.
    All 124 host cases pass; WindowsDebug and the R5 dual configuration both build
    (not flashed).
    M2b (bridge): sim_bridge exports Reset/Step/GetSite/Sizes and links the real
    control sources plus s5_site.c. build_bridge.py mirrors the firmware CMa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
2026-10-26 feat(sim): render the M1 scene now that OpenGL works again
    Both laptop GPUs recovered from Code 43 after ToDesk was stopped, so the
    viewer and offscreen rendering work. plot_scene.py writes three PNG views of
    the model at a chosen pose, prints the body positions, can open the real
    viewer, and can hide the human arm because the coaxial exoskeleton is thinner
    and otherwise invisible. README and the log record the corrected status.
    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
2026-10-26 fix(sim): put the exoskeleton beside the arm and couple the bands by angle
    The user's SolidWorks view shows the links running along the outside of the
    arm with cuffs wrapping it, so the old coaxial scene hid the exoskeleton
    inside the human arm. The mount, post and both exoskeleton links now sit
    0.10 m to the side; the human chain stays at y = 0 and the joint axes stay
    along y, so the sagittal dynamics are unchanged.
    The band model needed two corrections. A point attachment (connect) and a
    rigid weld both became infeasible once the elbow bent, because the
    exoskeleton elbow axis sits 5.5 cm above the human elbow: at 90 deg the two
    cuff points are about 4 cm apart, so the constraint fought th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
2026-10-27 feat(sim): rebuild M1 on the user's Fusion exoskeleton and MyoArm
    The first M1 drew its own capsule human, put the exoskeleton inside the arm
    and coupled the cuffs by joint angle, so it did not match the bench. Rebuild
    it from the user's Fusion export (read-only copy under model/orthoease) plus
    MyoSim myoarm_r, with the exoskeleton on the right arm's outside, the 14 mm
    stand pole through the 01B clamp bore, a 0.90 m table and two soft weld cuffs.
    Masses come from STL volume x ABS; the upper arm is lengthened along the 04
    rail to meet the MyoArm elbow; the passive turntable stays free. check_static
    covers the scene relations, gravity torques, worn-vs-bare effort, band
    coupling and table cont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
2026-10-27 feat(sim): M4 experiment runner comparing bare, worn and assisted
    One command runs the same reference motion for C0 (bare arm), C1 (worn,
    unpowered) and C2 (worn, driven by the firmware control library at its own
    send interval), records the human actuator torque as effort and writes CSV,
    summary JSON and a four-panel figure.
    First results: wearing the unpowered exoskeleton costs about 11% total effort;
    the current firmware gives back about 7% (10% at the shoulder, almost nothing
    at the elbow) because its elbow channel (0.04 Nm at 2 A) is far below the
    forearm link's own weight moment. The band time constant moves from 0.02 to
    0.05 s so the cuffs stop fighting the 3-4 deg axis tilt.
    Generat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
2026-10-27 feat(sim): sweep the firmware elbow amplitude in simulation
    The M4 runs showed the elbow channel recovers almost nothing, so rebuild the
    control library for MA = 2k..20k mA (a build option, no source change) and run
    the same motion each time. Shoulder reduction stays at 10% for every MA, so
    the whole remaining gap is the elbow: 6.9% total at the current 2 A, 8.8% at
    10 A (M3508 rated) and 11.1% at the 20 A command limit, where the worn and
    assisted effort matches the bare arm.
    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
2026-10-27 feat(firmware): raise the R5 elbow amplitude to 10 A and match the sim
    The simulation sweep put the whole remaining effort gap on the elbow channel:
    2 A recovers 6.9% of the worn-exoskeleton penalty, 10 A (M3508 rated) 8.8%,
    and the shoulder stays at 10% for every value. Build MA=10000 in its own build
    directory (FLASH 141896 B, no warnings, host tests 124 pass), record the hash
    in the firmware README and make the simulation bridge default match. Nothing
    is flashed yet; the board still runs the 2000 mA image.
    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
2026-10-27 feat(sim): final M4 results and report figures; drop the bench comparison
    Start the tasks at 5 deg instead of 0: MyoArm's shoulder range starts at 0, so
    a hanging arm rests on the joint stop and the stop, not the muscles, carries
    the load. Add report_figures.py for the time series, per-task bars, scene
    stills and a lift animation, and record the final numbers (wearing costs about
    12%, the 10 A assist gives back about 9%). M5 (bench comparison) is cancelled
    by user decision.
    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
2026-10-27 feat(sim): M6 muscle activation as a second effort metric
    Keep MyoArm's 63 muscles in a metric-only model and solve the static
    optimisation for the joint torque each recorded sample needed, then report the
    sum of activation per condition. Wearing the unpowered device raises it 5-7%;
    with the 10 A assist it returns to the bare-arm level. Also fix the tension
    sign (MuJoCo reports muscle force as negative along the length, so the first
    version picked extensors as flexors) and the active-set clipping loop.
    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
2026-10-27 feat(sim): stages A, B and G - workspace map, surgical holds, burst moves
    Stage A scans shoulder 5-60 by elbow 30-110 with a PD hold (inverse dynamics
    is unusable once the straps close the loop: the grounded exoskeleton then
    "carries" the arm in the solution). Wearing costs 13% on average, the assist
    gives back 9%, and at low elevation with a small elbow angle the assist
    actually raises muscle activation.
    Stage B holds the three surgical postures for 60 s: benefit 8.2/10.6/12.2% for
    P1/P4/P5. Stage G adds mallet-strike and rapid-lift bursts at 1 ms sampling:
    the assist recovers only 1-2% there, because the firmware updates every 50 ms
    and the shoulder slew is 0.1 Nm/s, so the assist is froz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
2026-10-27 feat: 10 ms firmware output period and muscle-driven burst simulation
    User decisions: raise the R5 send interval from 50 to 10 ms, drive the human
    arm with MyoArm's 63 muscles, and allow the MuJoCo window during runs.
    Firmware: send_interval_ms 50 -> 10 (still under the service and request
    limits); host tests 124 pass; nothing flashed. Simulation: keep_muscles now
    keeps the straps too (the earlier early return left the muscle model
    unstrapped, which made C0/C1/C2 identical), plus sim/muscle_drive.py and
    scripts/muscle_burst.py with --viewer. G1 mallet strike: peak human torque
    15.67/17.44/15.94 Nm for C0/C1/C2, i.e. 8.6% below the unpowered case, with
    the activation peak down 26%.
    Not conf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
2026-10-27 feat(sim): computed-torque feedforward for the muscle-driven arm
    Follow the MyoSuite inverse-dynamics/CMC tutorials and the maintainers' advice
    in issue #337: build the torque demand from the desired acceleration,
    tau = M(q) a_des + qfrc_bias - qfrc_passive - qfrc_constraint
    then distribute it over the 63 muscles with the static optimisation. mj_inverse
    is not used because this MuJoCo leaves qfrc_inverse at zero unless the discrete
    flag is set.
    The shoulder sag is gone (G2 steady error 26-28 deg -> 0.2 deg). The muscles
    now limit the elbow burst to about 430 ms against the 180 ms reference, which
    is more realistic than the ideal-torque model, and the assist contribution in
    bursts stay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
2026-10-27 feat(firmware): allow a larger shoulder assist (gain up to 3, cap up to 575 mNm)
    The user chose to raise the assist amplitude. Raising the gain alone does
    nothing because the 205 mNm rotor cap clips it, so add S5_R5_SHOULDER_CAP_MNM
    (1..575, default 205 = the old value) and widen the gain range to 3.0; the
    profile check follows. Nothing is flashed.
    Simulation sweep (muscle driven, elbow at 20 A): the static P5 posture improves
    from 12.2% to 35.3% effort reduction (shoulder RMS 10.40 -> 6.31 Nm), while the
    bursts stay at about 1% because their 46 Nm peak is dominated by inertia rather
    than gravity. 4.6 Nm is the GDS68 rating, so there is no thermal margin left.
    Generated with [Devin](https: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
2026-10-27 feat(firmware): conservative assist settings - 10 A elbow, gain 1.5, 300 mNm cap
    User choice of the conservative step. Make 1.5 and 300 the defaults in CMake,
    in s5_site.c and in the simulation bridge, and record the built image
    (FLASH 141896 B, no warnings, host tests 124 pass, not flashed).
    Simulation with these settings: the three surgical postures improve from
    8.2/10.6/12.2% to 11.3/15.1/17.6% effort reduction; the bursts stay at
    0.6-3.1% because their peak torque is inertia-dominated.
    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
2026-10-27 docs(sim): why the burst assist has no gain - inertia dominates
    Decompose the shoulder burst torque into M*qdd and qfrc_bias: at 250 ms the
    inertial term peaks at 80.75 Nm against 7.61 Nm of gravity, so gravity
    compensation can remove at most 8.6% of the peak torque, and our 2.4 Nm cap is
    3% of the inertial term. The controller type is wrong for bursts, not its
    parameters.
    Add positive-work metrics to the muscle burst report (peak torque cannot show a
    gravity-compensation benefit) and record the Amplify test: 0 -> 100 mNm moves
    the exoskeleton's work from 9.08 to 9.58 J with no change in human work. Note
    that C2 human work came out slightly above C1 - unexplained, flagged for a
    closer look.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
2026-10-27 feat(firmware): widen the shoulder Amplify range and use it for the burst test
    The burst test is meant to exercise the assist function that the device
    already has, so widen S5_R5_SHOULDER_AMPLIFY_MNM from 0..100 to 0..575 mNm
    (4.6 Nm joint, GDS68 rating / 8) and record the sweep.
    Muscle-driven burst results: G2 peak torque stays at 46.17 Nm for every
    Amplify value and the human positive work only falls from 125.8 to 124.8 J at
    the maximum. The ceiling is arithmetic: 4.6 Nm x 0.7 rad is about 3.2 J of the
    120 J a burst needs, i.e. 2.5%. The elbow burst is unaffected because only the
    shoulder channel has Amplify. Host tests 124 pass, nothing flashed.
    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
2026-10-27 feat(firmware): elbow Amplify, shoulder Amplify at 300 mNm
    The burst test is meant to exercise the device's assist function, so add
    S5_R5_ELBOW_AMPLIFY_MA (0..20000 mA, default 5000). It reuses the shoulder
    Amplify module with |elbow velocity| for the trigger and the sign of the
    movement for the increment, so a fast extension (a strike) is assisted as well
    as a flexion, with the same 400 ms suspension and 200 ms ramp. The compose
    function, the site, s5_follow, the simulation bridge and the host fixture all
    follow, plus a new compose_elbow_amplify case (125 tests pass).
    Simulation: the elbow burst improves from 3.1% to 4.0/4.6/5.6% below the
    unpowered case as the increment goes 5/10/20 A; th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
2026-10-27 feat(sim): elbow Amplify at 10 A, muscle-driven static and burst results
    User choice: elbow Amplify 10 A. Make it the default in CMake, s5_site.c and
    the bridge, rebuild the image (FLASH 142136 B, no warnings, not flashed) and
    keep the 125 host tests green.
    Add scripts/muscle_static.py and fix two issues it exposed: Burst now supports
    a fixed pose (the static holds were silently using a 20 deg shoulder) and
    MuscleRun records both joint torques (it only recorded the driven one).
    Results with the final settings: static holds P1/P4/P5 give human shoulder
    torque 5.37/6.10/5.29, 5.89/6.85/5.66 and 8.93/10.42/8.35 Nm for C0/C1/C2, so
    the assisted case is now slightly below the bare arm; the burs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
2026-10-28 docs(sim): report in the paper convention and a single validation report
    The shoulder-exoskeleton papers report one muscle (anterior deltoid) against
    the worn-but-unpowered case. Add per-muscle activations and that comparison to
    muscle_static.py (new deltoid panel), fold it into the one-command report, and
    write docs/validation_report.md with the model sources, control settings, the
    static / deltoid / burst / workspace results, the literature comparison, the
    limits and the reproduction commands. Eight figures are archived under
    docs/figures so the report is self-contained in the repository.
    Deltoid activation falls 20.3 / 13.6 / 11.7% against the unpowered case for
    P1/P4/P5, the same range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
2026-10-28 fix(firmware): make Amplify switch instantly instead of ramping over 200 ms
    The user asked whether the burst test really uses the assist. Splitting the
    command into baseline and increment (two runs, subtracted) showed the increment
    only reached 90% at 241 ms of a 250 ms burst, i.e. the assist arrived after the
    movement. Two causes: the 20 deg/s start took ~120 ms to cross, and the 200 ms
    ramp was a local addition (ExoKit's AmplifyReaction switches instantly).
    Support ramp_ms = 0 in ShoulderAmplify_Step and add S5_R5_AMPLIFY_START_DPS
    (10), S5_R5_AMPLIFY_RAMP_MS (0) and S5_R5_AMPLIFY_SUSPEND_MS (150) shared by
    the shoulder and elbow channels. The host case that rejected ramp 0 now accepts
    it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
2026-10-28 docs(sim): re-run the burst experiments with the instant Amplify switch
    With the new timing (10 deg/s start, instant switch, 150 ms suspension) the
    mallet strike improves to 6.4% below the unpowered case and also beats the
    bare arm (4.56 vs 4.69 Nm); its positive human work falls below both C0 and C1.
    The rapid lift still moves only 0.7% because its peak is inertia-dominated.
    The activation curves also show an anomaly worth flagging: after the lift the
    assisted case (blue) sits above the unpowered one, and its positive work is
    slightly higher, which suggests the increment keeps pushing while the arm
    decelerates. Recorded as unresolved, with the figures and the report updated.
    Generated wit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
2026-10-28 feat(firmware): positive-power gate for Amplify, off by default
    Implement the gate as a config field (accel_gate_rad_s2) plus the build option
    S5_R5_AMPLIFY_ACCEL_GATE_DPS2: the increment is only allowed while the joint
    accelerates in the assisted direction. The measured effect is marginal (mallet
    work 18.7 -> 18.4 J but its peak gets worse, rapid lift unchanged), so the
    default is 0 and the burst runs stay as they were.
    The report also records the real cause of the rapid-lift anomaly: splitting one
    cycle shows the raise (-6.8%) and hold (-14.2%) phases improve while the
    lowering phase gets 10.5% worse, because the gravity baseline keeps pushing up
    while the arm goes down, the effect the Ap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
2026-10-28 fix(sim): centre the workspace map labels and keep the colour scales readable
    imshow's extent put every printed value on the cell border instead of the cell
    centre, and a single -85% cell (activation divided by a 0.004 baseline) flattened
    the third panel. Switch to pcolormesh with the samples at their own grid points,
    give each panel a robust 2-98% colour range, and blank cells whose unpowered
    activation is below 0.01. Regenerate the bilingual report with the new figure.
    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
2026-10-28 docs(sim): add implementation references, DOIs and the work list to the report
    Sections 10-12 in both the Markdown report and the bilingual Word document:
    a table of the sources actually read (ExoKit, MyoSim, the CAD package, MuJoCo,
    the MyoSuite CMC tutorials, OpenSim CMC) with what was taken and adapted, the
    reference list with DOIs, and a summary of what this project delivered per area
    including an explicit "not done" row.
    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
2026-10-28 fix(sim): only show activation percentages where the baseline is meaningful
    At shoulder 15 / elbow 40 the unpowered activation is 0.042, so 1 - C2/C1 read
    -85% although the assisted case simply returns to the bare-arm level; that one
    cell flattened the whole panel. Blank cells whose unpowered activation is below
    0.2 (11 of 108), use nan-aware summary statistics, and update the captions in
    both reports. The panel now spans -14.4 to +20.8%.
    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
2026-10-28 docs(sim): align the workspace text with the current-default rerun
    The heat map had already been regenerated with shoulder gain 1.5 / 300 mNm,
    but the Markdown report, the Word caption and the README still quoted the
    gain 1.0 / 205 mNm numbers (+9.4 % mean benefit, over-help at shoulder 5-20 /
    elbow 30-60). Quote workspace-final instead (+13.7 % mean, 19-24 % at
    shoulder 60, negative activation benefit at shoulder 10-15), keep the old
    column in the README for comparison, and bring the schedule status lines and
    log up to date.
    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
2026-10-28 chore(sim): drop one-off scripts and the ideal-torque M4 chain
    The report and every current number come from the muscle-driven runs
    (report_muscle_all.py) and the workspace scan, so the one-off diagnostics
    (smoke_env, lift_contact, check_timing with the unused io_model/timing.json,
    sweep_elbow_ma, burst_report, activation_report), the ideal-torque M4 runner
    (run_experiment, runner, tasks, metrics, plots, report_figures) and the
    fixed-number checks in test_bridge/check_static are no longer needed.
    burst.py keeps only the motion definitions the muscle drive uses. README gets
    a current command table; requirements now pin python-docx and lxml.
    A full rerun after the cleanup reproduces the repor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
2026-10-28 chore(tests): drop stage-specific bench tools, keep their evidence in docs/bench
    bench_serial (S1, POSIX), bench_can_serial (S2 no-driver case), the GDS USB
    power diagnostic (depends on a path outside the repo) and the S2/S3 capture
    tools only applied to stages that are closed. Their recorded evidence moves to
    docs/bench/s2-encoder-capture and docs/bench/s3-capture (including the local
    S2 captures that had only been ignored), and the live docs point there.
    Default host tests (125) and check_generated still pass.
    The log also records a finding from checking the R5 host profile: since the
    shoulder cap went from 205 to 300 mNm, OutputGateway_ConfigureAxesFollow
    rejects the release budget (0.12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
