46564645/Surgery_exoskeleton/(notices)

Notices in the files:
firmware/Exoskeleton_F446/Core/Src/main.c:
Copyright (c) 2026 STMicroelectronics.
All rights reserved.
This software is licensed under terms that can be found in the LICENSE file
